geilevideossos-gamedev/fable-sbc-test/enclosure/renders/enclosure_front.png

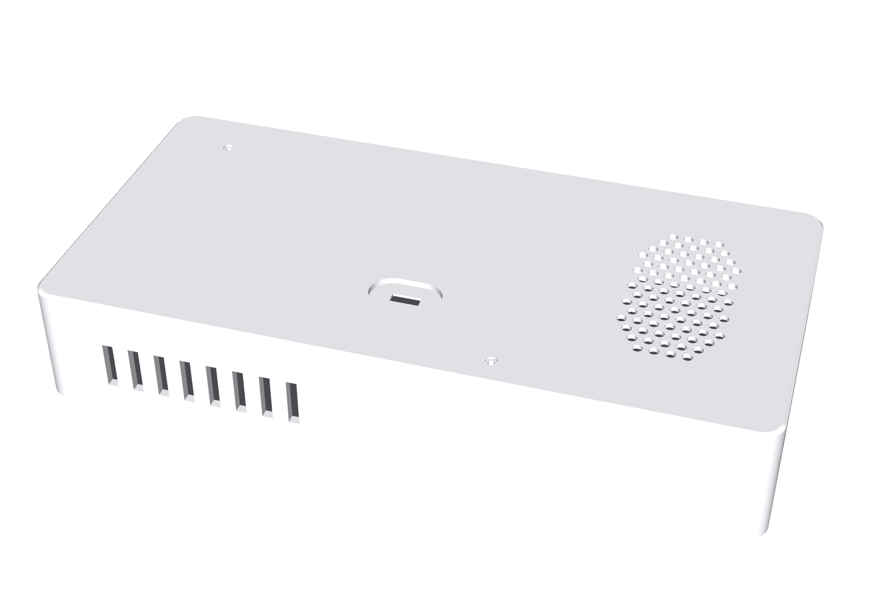
enclosure/renders/enclosure_front.png
