geilevideossos-gamedev/fable-sbc-test/enclosure/renders/fit_top_transparent.png

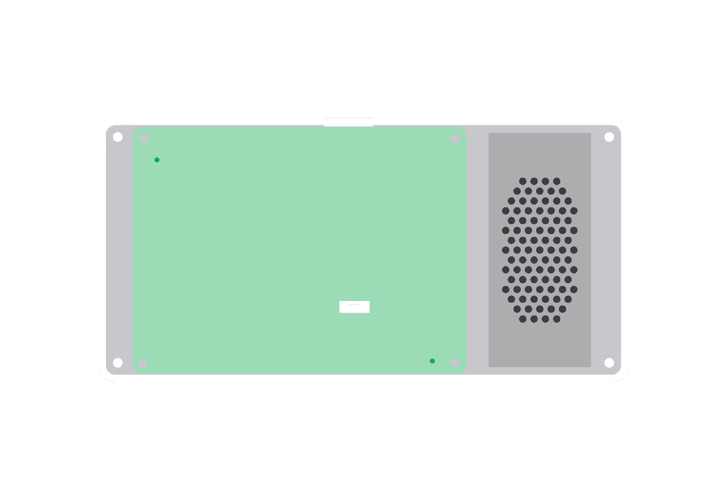
enclosure/renders/fit_top_transparent.png
