geilevideossos-gamedev/fable-sbc-test/enclosure/renders/section_cm4.png

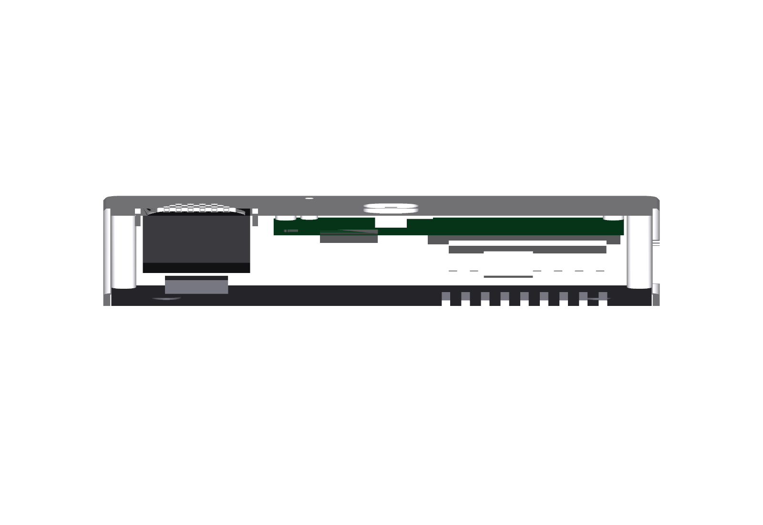
enclosure/renders/section_cm4.png
