geilevideossos-gamedev/fable-sbc-test/enclosure/renders/section_front_row.png

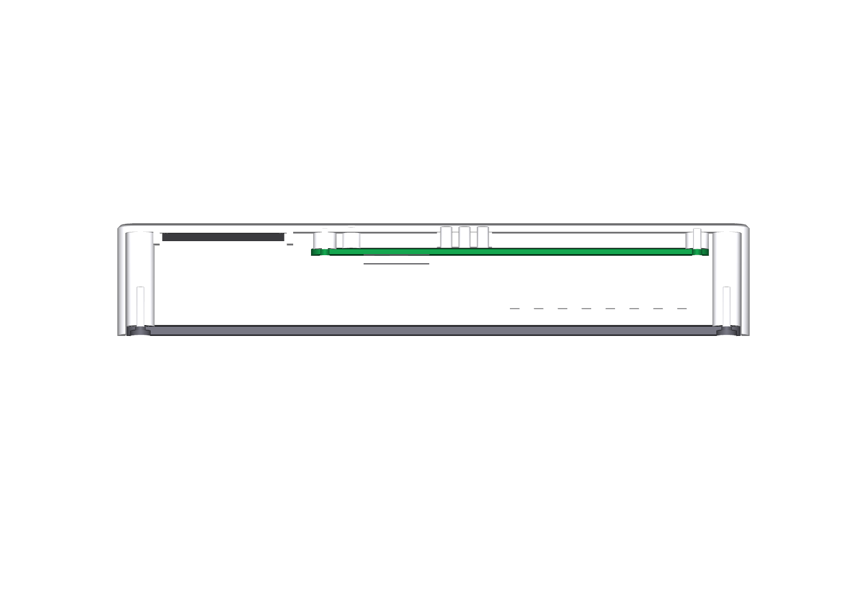
enclosure/renders/section_front_row.png
