geilevideossos-gamedev/fable-sbc-test/hardware/outputs/render_bottom.png

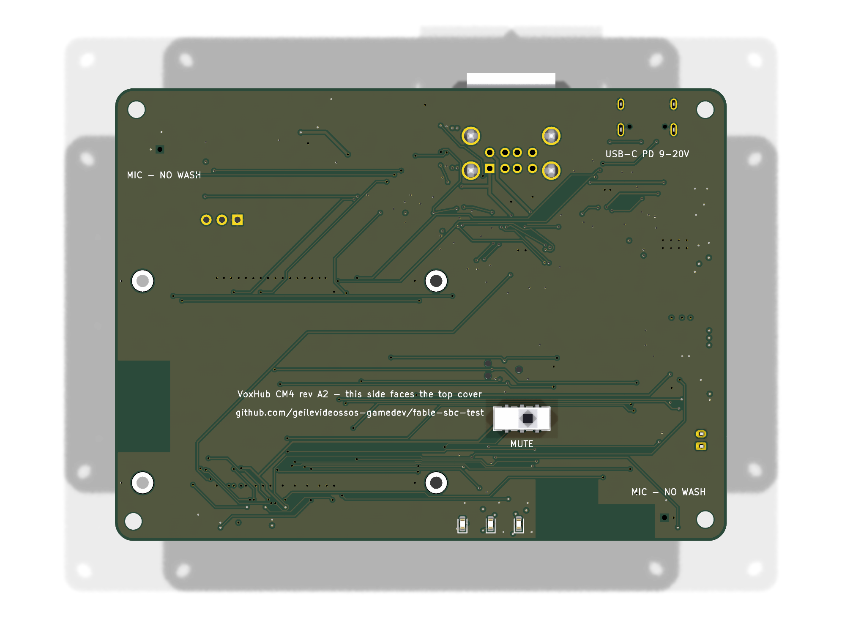
hardware/outputs/render_bottom.png
