geilevideossos-gamedev/fable-sbc-test/fab/jlcpcb/bom_jlcpcb.csv

Comment | Designator | Footprint | LCSC Part #
CL10A105KB8NNNC | C1 | C_0603_1608Metric | C15849
CC0603KRX7R9BB104 | C2 | C_0603_1608Metric | C14663
CL10B105KA8NNNC | C3,C5,C11 | C_0603_1608Metric | C29936
CL05B104KO5NNNC | C4,C6,C12,C18,C19,C21,C24,C25,C28,C29,C30,C31,C32,C33,C34,C35,C39,C42,C43,C44,C45,C48,C50 | C_0402_1005Metric | C1525
CL05B103KB5NNNC | C7 | C_0402_1005Metric | C15195
CL31B106KBHNNNE | C8,C9 | C_1206_3216Metric | C89632
GRM188R71H224KAC4D | C10 | C_0603_1608Metric | C669503
CL31A226KAHNNNE | C14,C15,C16,C17,C22,C23,C46,C47 | C_1206_3216Metric | C12891
CL10A475KA8NQNC | C20,C36,C37,C40,C49 | C_0603_1608Metric | C69335
0402CG150J500NT | C26,C27 | C_0402_1005Metric | C1548
T520B107M006ATE040 | C38,C41 | CP_EIA-3528-21_Kemet-B | C116740
SMBJ22A | D1 | D_SMB | C224015
SD24C-01FTG | D2,D3 | D_SOD-323 | C207246
LTST-C191KRKT | D4,D9 | LED_0603_1608Metric | C125099
MM3Z10VT1G | D5 | D_SOD-323 | C39057
150060VS75000 | D6,D10 | LED_0603_1608Metric | C6848499
KT-0603G | D7 | LED_0603_1608Metric | C12624
KT-0603B | D8 | LED_0603_1608Metric | C2288
9774015151R | H5,H6,H7,H8 | Mounting_Wuerth_WA-SMSI-M2.5_H1.5mm_9774015151 | C5353804
USB4105-GF-A | J1 | USB_C_Receptacle_GCT_USB4105-xx-A_16P_TopMnt_Horizontal | C3020560
DF40C-100DS-0.4V(51) | J2,J3 | CM4_J1_DF40C-100DS | C597931
DM3AT-SF-PEJM5 | J4 | microSD_HC_Hirose_DM3AT-SF-PEJM5 | C114218
61400826021 | J6 | USB_A_Wuerth_61400826021_Horizontal_Stacked | C5366339
B2B-PH-K-S(LF)(SN) | J7 | JST_PH_B2B-PH-K_1x02_P2.00mm_Vertical | C131337
SLO0630H6R8MTT | L1 | L_Bourns_SRP7028A_7.3x6.6mm | C207841
IM69D130V01 | MK1,MK2 | Infineon_PG-LLGA-5-1 | C536262
AO3401A | Q1 | SOT-23 | C15127
2N7002,215 | Q2,Q3,Q4 | SOT-23 | C65189
0402WGF5101TCE | R1,R4,R18 | R_0402_1005Metric | C25905
0402WGF1001TCE | R2,R7,R26 | R_0402_1005Metric | C11702
0402WGF0000TCE | R3,R6 | R_0402_1005Metric | C17168
0402WGF2401TCE | R5 | R_0402_1005Metric | C25882
0402WGF4992TCE | R8,R16 | R_0402_1005Metric | C25897
0402WGF1003TCE | R9,R12,R13,R24,R25,R28,R29,R30,R31,R32,R42,R43,R44,R46,R47 | R_0402_1005Metric | C25741
0402WGF1503TCE | R10 | R_0402_1005Metric | C25755
0402WGF4703TCE | R11 | R_0402_1005Metric | C25790
0402WGF2492TCE | R14 | R_0402_1005Metric | C25874
0402WGF2201TCE | R15,R20,R45 | R_0402_1005Metric | C25879
0402WGF1002TCE | R17,R19,R21,R23,R33,R34,R35,R36,R38,R40 | R_0402_1005Metric | C25744
0402WGF1500TCE | R22 | R_0402_1005Metric | C25082
0402WGF1202TCE | R27 | R_0402_1005Metric | C25752
0402WGF2002TCE | R37,R39 | R_0402_1005Metric | C25765
0402WGF330JTCE | R41 | R_0402_1005Metric | C25105
JS202011JCQN | SW1 | SW_DPDT_CK_JS202011JCQN | C221665
CYPD3177-24LQXQT | U1 | QFN-24-1EP_4x4mm_P0.5mm_EP2.75x2.75mm | C2952489
LMR33640ADDAR | U2 | Texas_HSOP-8-1EP_3.9x4.9mm_P1.27mm_ThermalVias | C2836966
TPS2553DBVR | U3,U5,U6 | SOT-23-6 | C55266
USB2514B-I/M2 | U4 | QFN-36-1EP_6x6mm_P0.5mm_EP3.7x3.7mm | C220679
USBLC6-2SC6 | U7,U8 | SOT-23-6 | C7519
ADAU7002ACBZ-R7 | U9 | ADAU7002_WLCSP-8_0.76x1.56mm_P0.4mm | C481886
MAX98357AETE+T | U10 | TQFN-16-1EP_3x3mm_P0.5mm_EP1.23x1.23mm | C910544
RF-BM-2652P2 | U11 | RFstar_RF-BM-2652P2 | C5440064
X322524MOB4SI | Y1 | Crystal_SMD_3225-4Pin_3.2x2.5mm | C70590
