geilevideossos-gamedev/fable-sbc-test/hardware/outputs/bom_system.csv

Item | Qty used | Function | Description | Manufacturer | Part number | Shop | Shop article no. | Buy qty | Pack | EUR incl. VAT | Ext. EUR | Second source | Note | Link (prices and stock checked 2026-11-12)
1 | 1 | Compute module | Raspberry Pi Compute Module 4 Lite, 4 GB RAM, wireless, no eMMC | Raspberry Pi | CM4104000 | Reichelt.at | RPI CM4W 4GBLITE | 1 | 1 | 105.83 | 105.83 | Semaf Wien 102.00 (free shipping), Welectron 103.00, DigiKey SC0671; CM4102000 (2 GB) is the cheaper drop-in | the board has no Ethernet: only wireless variants work (not RPI CM4 4GBLITE = CM4004000) | https://www.reichelt.at/at/de/shop/produkt/raspberry_pi_compute_modul_4_4gb_ram_lite_wlan-290539
2 | 1 | Speaker | Enclosed speaker 3 W 4 ohm, 70 x 30 x 16.5 mm, JST-PH 2-pin plug on a lead of about 50 cm | Adafruit | 3351 | BerryBase.at | ADA3351 | 1 | 1 | 5.50 | 5.50 | none without re-drawing the speaker pocket of the enclosure | plugs into J7, no soldering | https://www.berrybase.at/mono-gehaeuselautsprecher-3w-4-ohm
3 | 1 | Heat sink | Heat sink set for Raspberry Pi: 14 x 14 x 7 mm (used) + 8.8 x 8.8 x 5 mm, adhesive foil applied | BerryBase | RPI-2KKS | BerryBase.at | RPI-2KKS | 1 | set of 2 | 1.30 | 1.30 | BerryBase RPI-4KKS; any 14 x 14 mm heat sink up to 9.5 mm high with adhesive foil | on the BCM2711 of the CM4 | https://www.berrybase.at/2-teiliges-kuehlkoerper-set-fuer-raspberry-pi-schwarz
4 | 1 | microSD card | microSDXC 64 GB, endurance type (Home Assistant OS writes around the clock) | SanDisk | SDSQQNR-064G-GN6IA | BerryBase.at | 619659173081 | 1 | 1 | 28.90 | 28.90 | any A1 / A2 class microSD of 32 GB or more | flash os/output/haos_voxhub-cm4-*.img.xz | https://www.berrybase.at/sandisk-high-endurance-microsdxc-uhs-i-u3-speicherkarte-adapter-64gb
5 | 8 | Screws CM4 + PCB | Screw M2.5 x 5 mm pan head PH1, DIN 7985 (4 x CM4 to the SMT spacers, 4 x PCB to the shell bosses) | generic | DIN 7985 M2.5x5 | BerryBase.at | D7985 | 10 | single | 0.06 | 0.60 | ISO 7045 / ISO 14583 M2.5 x 5; Screwerk STP390250060S (2.5 x 6 thread-forming, business customers only) for the bosses | never longer than 6 mm | https://www.berrybase.at/schraube-kopf-zylinder-m2-5x5
6 | 4 | Screws base | Screw M2.5 x 8 mm pan head PH1, DIN 7985 (base to the shell posts) | generic | DIN 7985 M2.5x8 | BerryBase.at | D7988 | 10 | single | 0.05 | 0.50 | M2.5 x 10 also fits; Screwerk STP390250080S (thread-forming, business customers only) | head 5.0 mm in a 5.2 mm counterbore | https://www.berrybase.at/schraube-kopf-zylinder-m2-5x8
7 | 4 | Feet | Rubber feet 8 x 3 mm, round, self-adhesive | Delock | 18308 | Reichelt.at | DELOCK 18308 | 1 | 70 | 4.89 | 4.89 | any 8 mm stick-on foot at least 2 mm high | base recesses are 8.6 mm | https://www.reichelt.at/at/de/shop/produkt/gummifuesse_rund_selbstklebend_8_x_3_mm_70_stk_schwarz-371080
8 | 1 | Speaker pad | Self-adhesive cellular rubber sheet 3 x 300 x 200 mm (cut 40 x 18 mm for the speaker pedestal) | Jamara | 059850 | Reichelt.at | JAMARA 059850 | 1 | 1 sheet | 5.60 | 5.60 | any soft closed-cell foam about 3 mm thick | compressed to about 2 mm when the base is closed | https://www.reichelt.at/at/de/shop/produkt/moosgummiplatte_3_x_300_x_200_mm_selbstklebend_1_stueck-327925
9 | 1 | Power supply | USB-C PD charger 30 W (5 V 3 A, 9 V 3 A, 12 V 2.5 A, 15 V 2 A, 20 V 1.5 A) | Goobay | 79153 | Reichelt.at | GOOBAY 79153 | 1 | 1 | 16.54 | 16.54 | Goobay 79155 (65 W); any USB-C PD charger with a fixed 12 / 15 / 20 V profile of 2 A or more | the board negotiates 15 V / 2 A | https://www.reichelt.at/at/de/shop/produkt/usb-ladegeraet_30_w_gan_1x_usb-c_weiss-425716
10 | 1 | USB-C cable | USB-C to USB-C cable, 60 W, 1 m | Shiverpeaks | BS20-75025 | Reichelt.at | SHVP BS20-75025 | 1 | 1 | 5.84 | 5.84 | any USB-C to USB-C cable rated 3 A |  | https://www.reichelt.at/at/de/shop/produkt/sync-_ladekabel_usb-c_60w_1_0_m-378629
 |  |  | System parts for one device |  |  |  |  |  |  |  | 175.50
 |  |  | Shipping to Austria (Reichelt.at 6.95, BerryBase.at 5.95) |  |  |  |  |  |  |  | 12.90
 |  |  | Total |  |  |  |  |  |  |  | 188.40
