geilevideossos-gamedev/fable-sbc-test/enclosure/voxhub_assembly.step

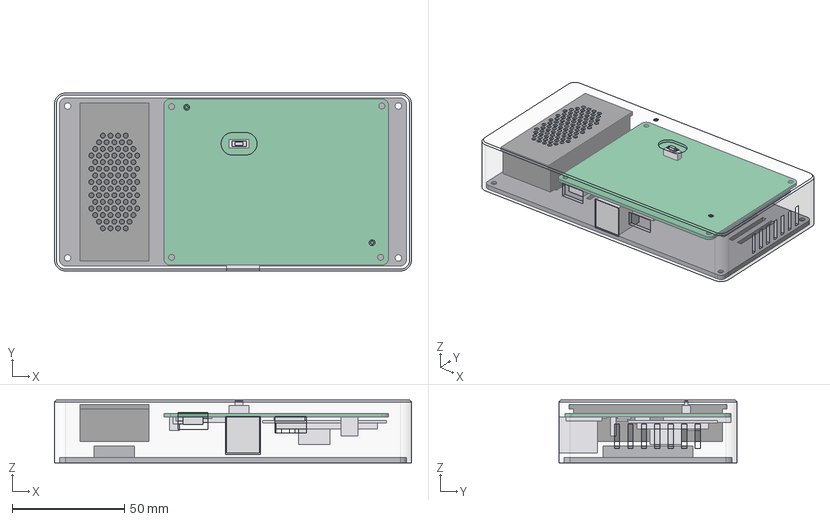
[picture p11: CAD file, 2026-11-12]
enclosure/voxhub_assembly.step
158.8 x 79.2 x 28.0 mm
base
pcb
components
speaker
