geilevideossos-gamedev/fable-sbc-test/hardware/3dmodels/ADAU7002.step

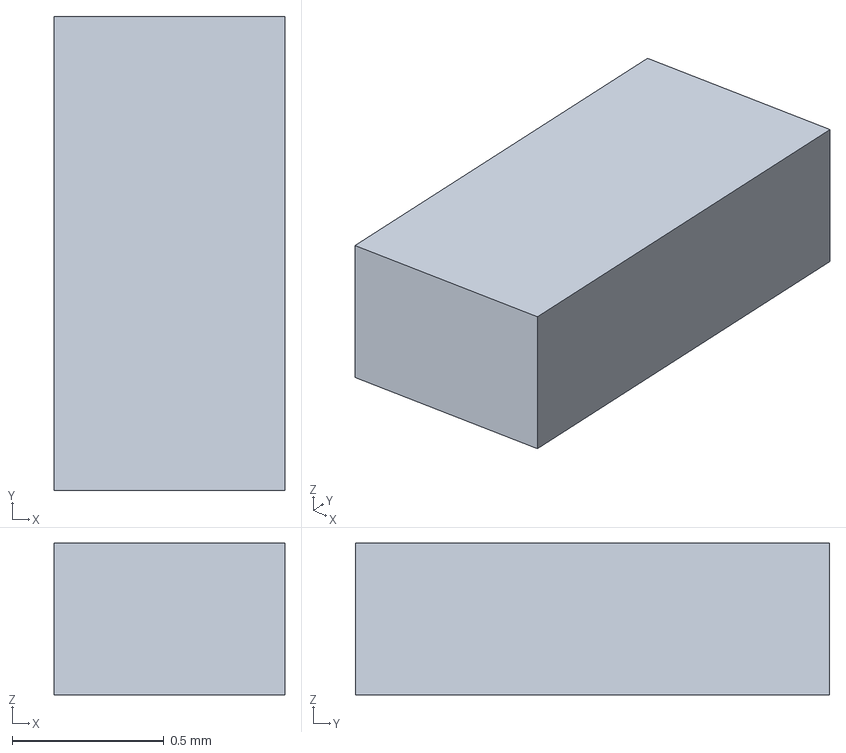
[picture p12: CAD file, 2026-11-12]
hardware/3dmodels/ADAU7002.step
0.76 x 1.56 x 0.5 mm
