geilevideossos-gamedev/fable-sbc-test/hardware/outputs/voxhub_outline.dxf

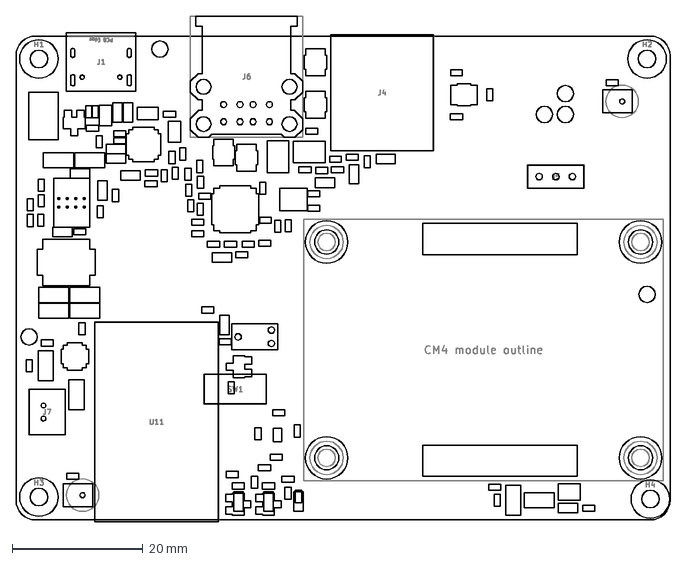
[picture p13: CAD file, 2026-11-12]
hardware/outputs/voxhub_outline.dxf
100.0 x 77.3 mm
