geilevideossos-gamedev/fable-sbc-test/enclosure/voxhub_base.step

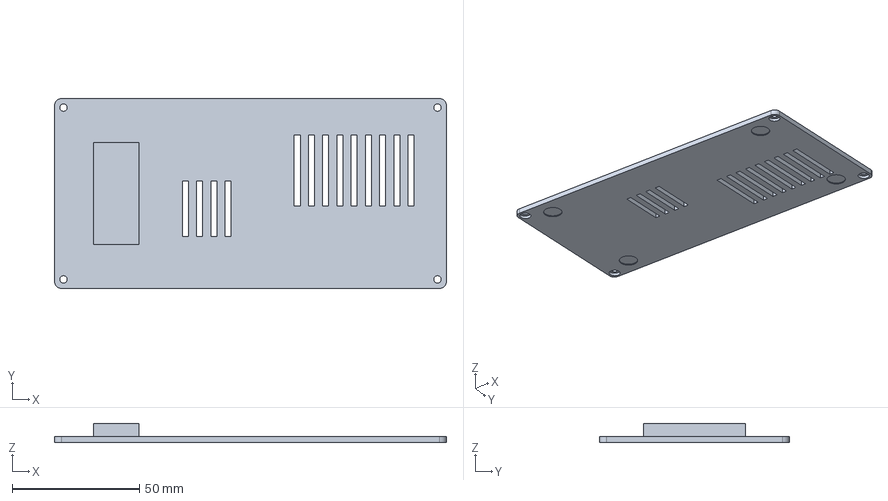
[picture p14: CAD file, 2026-11-12]
enclosure/voxhub_base.step
154.3 x 74.7 x 7.50 mm
