geilevideossos-gamedev/fable-sbc-test/hardware/3dmodels/RaspberryPi_CM4_with_heatsink.step

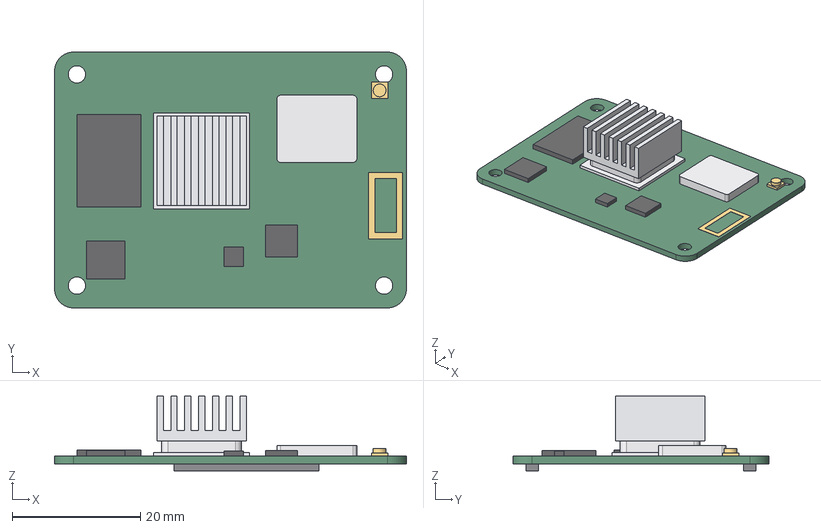
[picture p15: CAD file, 2026-11-12]
hardware/3dmodels/RaspberryPi_CM4_with_heatsink.step
55.0 x 40.0 x 11.7 mm
pcb
plugs
soc
heatsink
chips
shield
ufl
antenna
