geilevideossos-gamedev/fable-sbc-test/hardware/outputs/voxhub_pcb.step

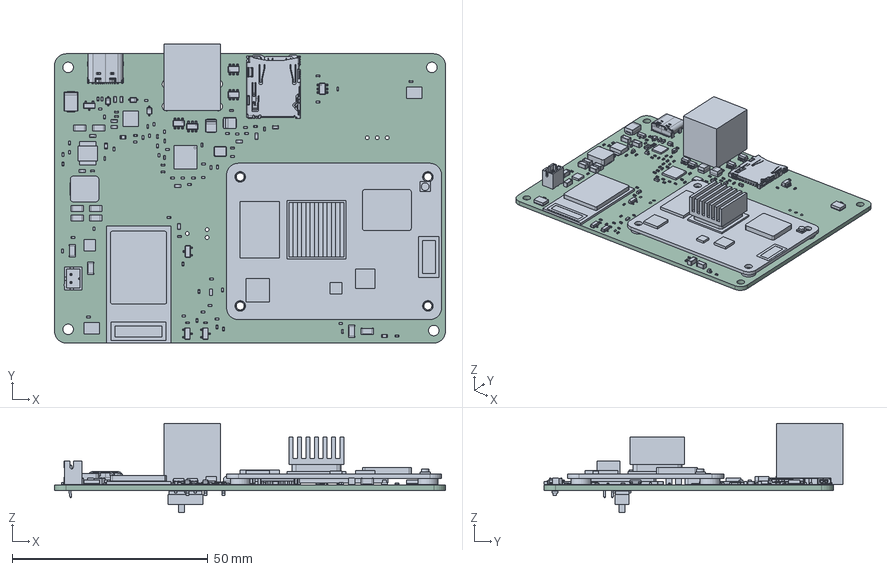
[picture p16: CAD file, 2026-11-12]
hardware/outputs/voxhub_pcb.step
100.0 x 76.5 x 22.8 mm
C_0402_1005Metric x 26
R_0402_1005Metric x 47
QFN-36-1EP_6x6mm_P0.5mm_EP3.7x3.7mm
C_0603_1608Metric x 11
lid x 2
base x 3
pcb x 2
shield x 2
antenna x 2
D_SOD-323 x 3
C_1206_3216Metric x 10
LED_0603_1608Metric x 6
JST_PH_B2B-PH-K_1x02_P2.00mm_Vertical
pads
SOT-23 x 4
D_SMB
tongues
contacts
SOT-23-6 x 5
Crystal_SMD_3225-4Pin_3.2x2.5mm
microSD_HC_Hirose_DM3AT-SF-PEJM5
CP_EIA-3528-21_Kemet-B x 2
plugs
soc
heatsink
chips
ufl
Mounting_Wuerth_WA-SMSI-M2.5_H1.5mm_9774015151 x 4
leads
USB_C_Receptacle_GCT_USB4105-xx-A_16P_TopMnt_Horizontal
frame
actuator
pins
voxhub_PCB
