geilevideossos-gamedev/fable-sbc-test/enclosure/voxhub_shell.step

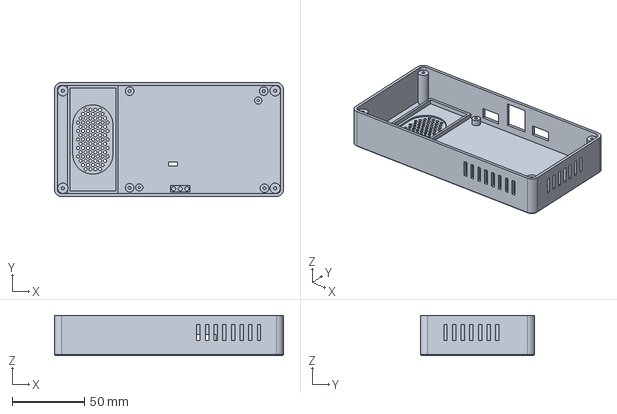
[picture p17: CAD file, 2026-11-12]
enclosure/voxhub_shell.step
158.8 x 79.2 x 28.0 mm
