geilevideossos-gamedev/fable-sbc-test/hardware/3dmodels/RF-BM-2652P2.step

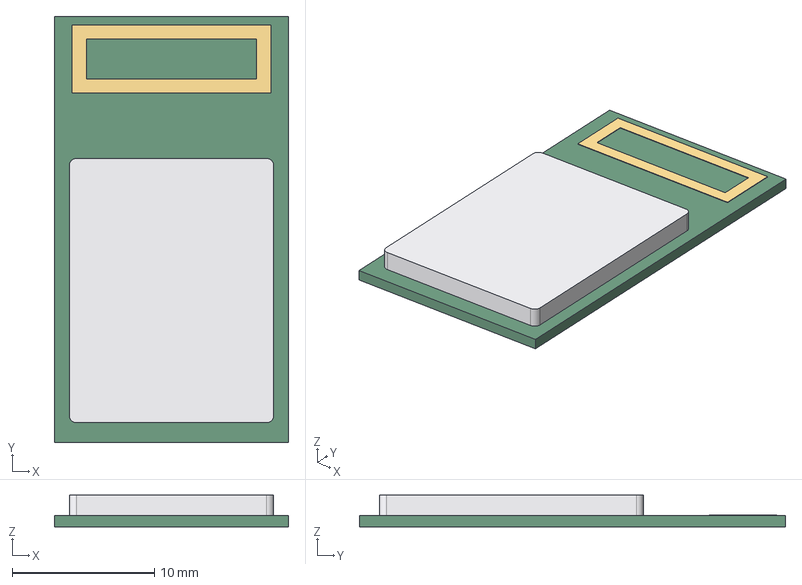
[picture p18: CAD file, 2026-11-12]
hardware/3dmodels/RF-BM-2652P2.step
16.5 x 30.0 x 2.25 mm
pcb
shield
antenna
