geilevideossos-gamedev/fable-sbc-test/hardware/3dmodels/MGM240P.step

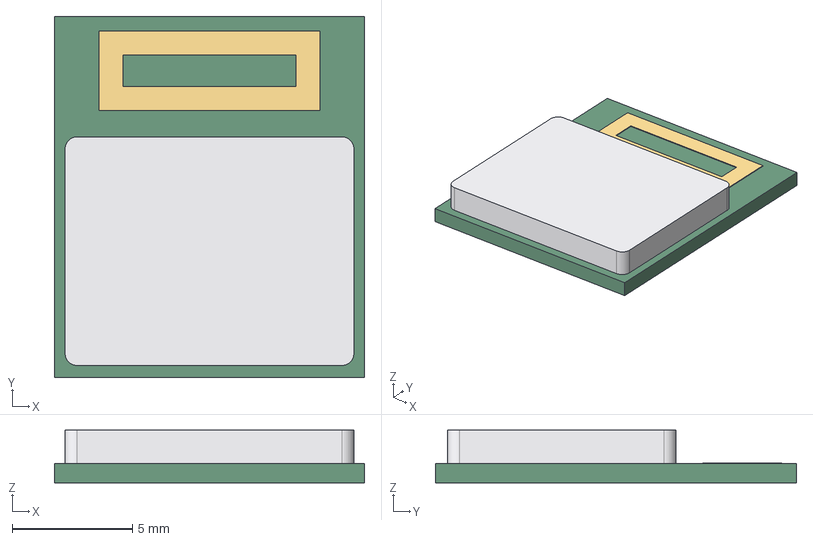
[picture p19: CAD file, 2026-11-12]
hardware/3dmodels/MGM240P.step
12.9 x 15.0 x 2.20 mm
pcb
shield
antenna
