geilevideossos-gamedev/fable-sbc-test/(list of files, cad)

Other CAD files:
enclosure/voxhub_base.3mf
enclosure/voxhub_base.stl
enclosure/voxhub_shell.3mf
enclosure/voxhub_shell.stl
