geilevideossos-gamedev/fable-sbc-test/assistant/voxhub_satellite/CHANGELOG.md

# Changelog

## 0.1.0

- First release: Linux Voice Assistant 1.1.18 as an Assist voice satellite on the VoxHub hub, status LEDs and
  hardware mute switch through the peripheral API, microphone gain for the googlevoicehat card, and the exposure
  guard that keeps locks and alarm panels away from Assist.
