geilevideossos-gamedev/fable-sbc-test/hardware/outputs/voxhub_schematic.pdf

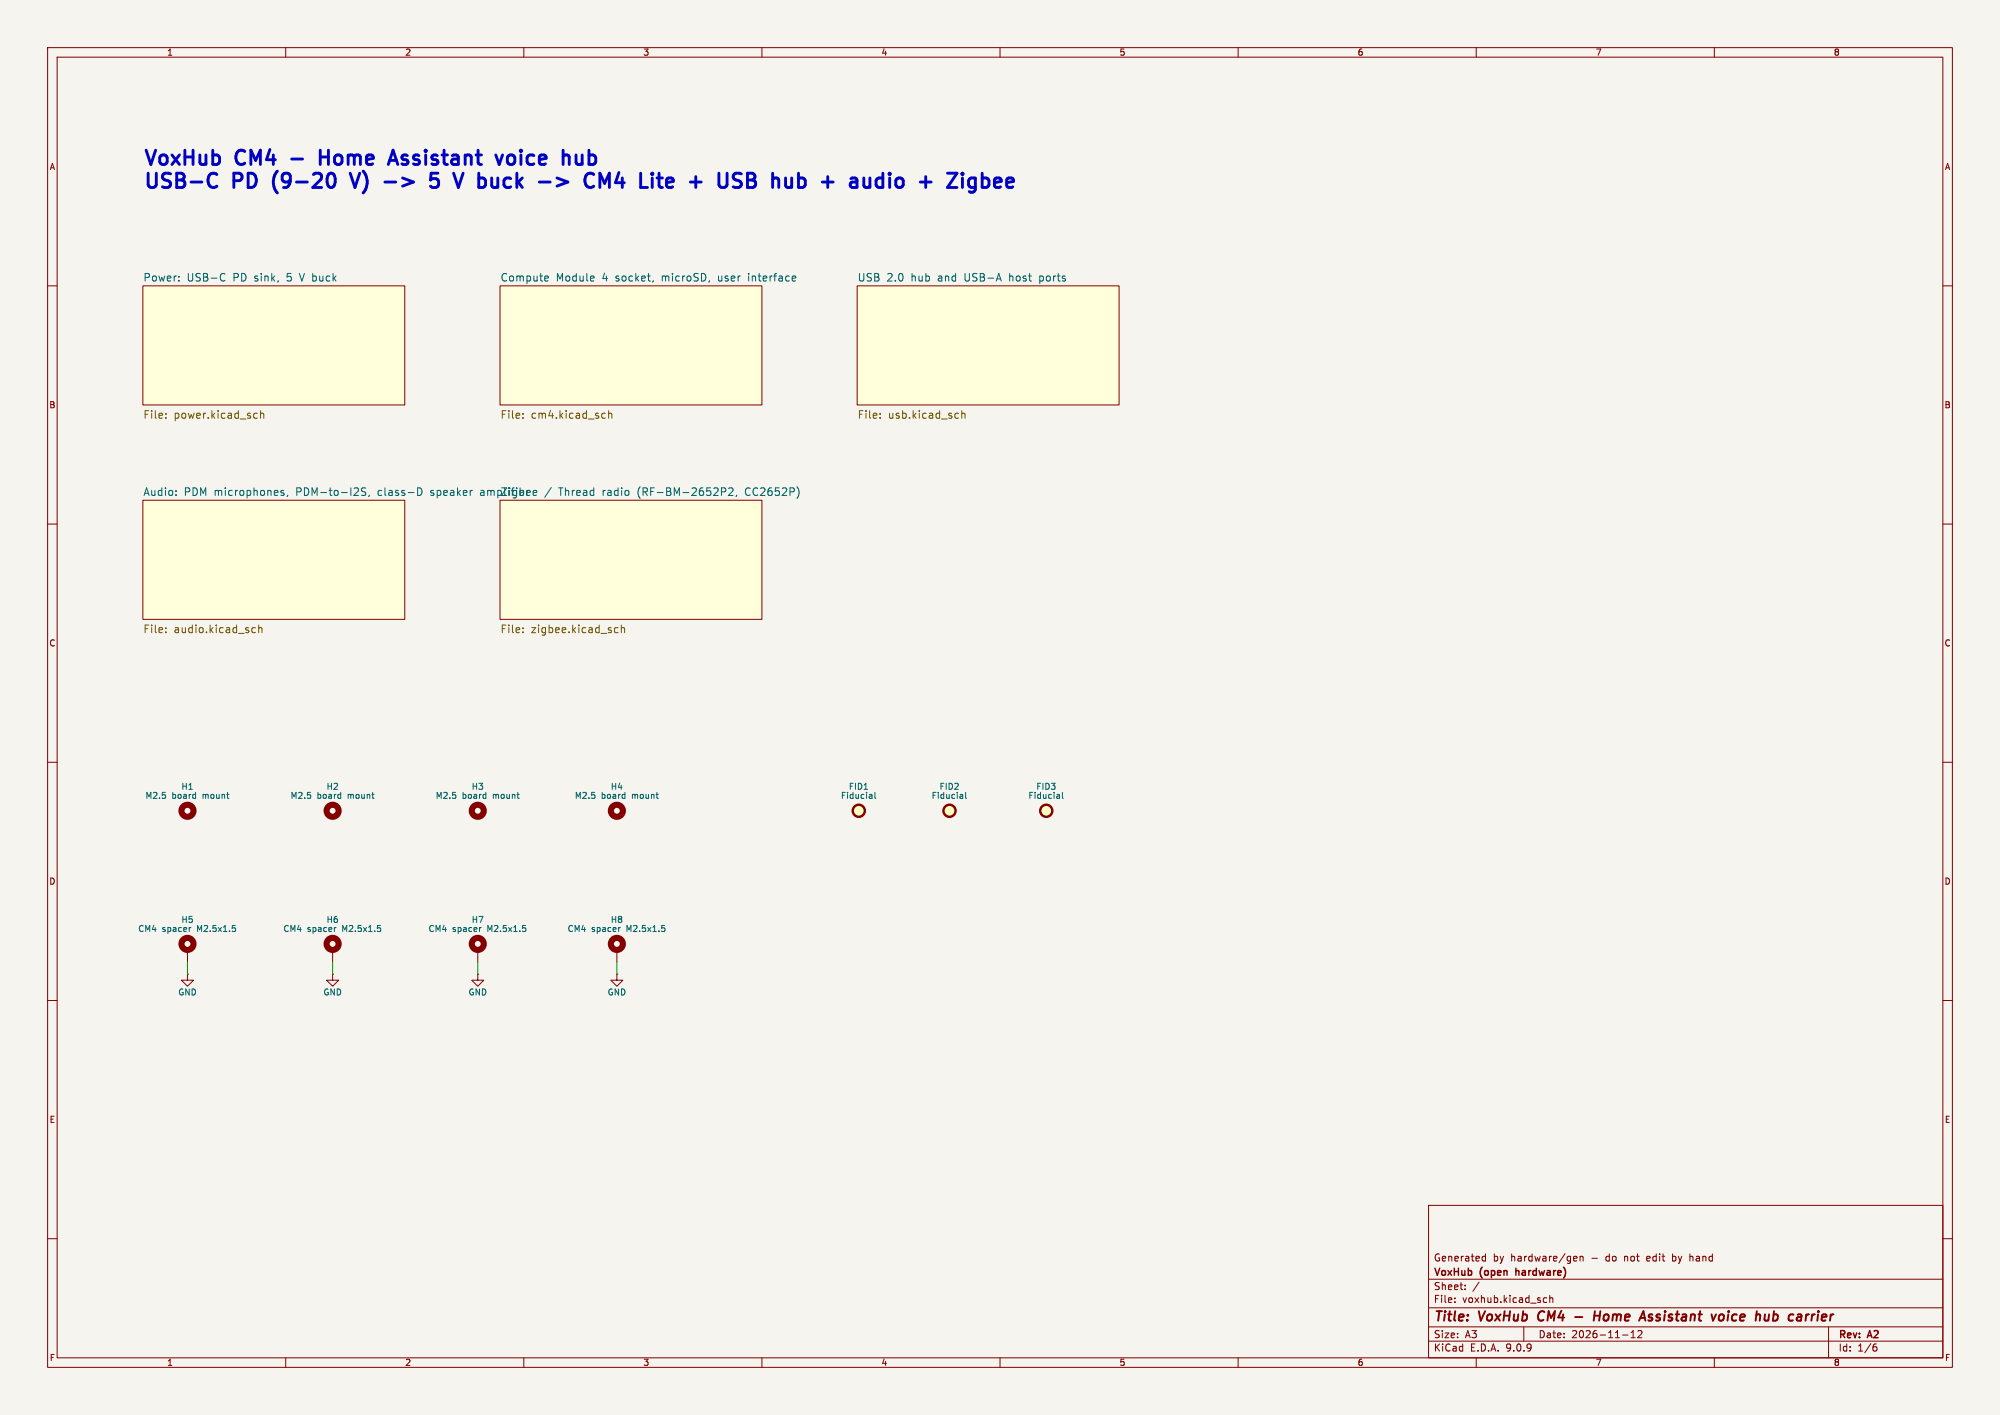
[picture p20: page 1]

FID2 Fiducial FID1 Fiducial H4 M2.5 board mount H3 M2.5 board mount H2 M2.5 board mount H1 M2.5 board mount VoxHub CM4 - Home Assistant voice hub

Compute Module 4 socket, microSD, user interface

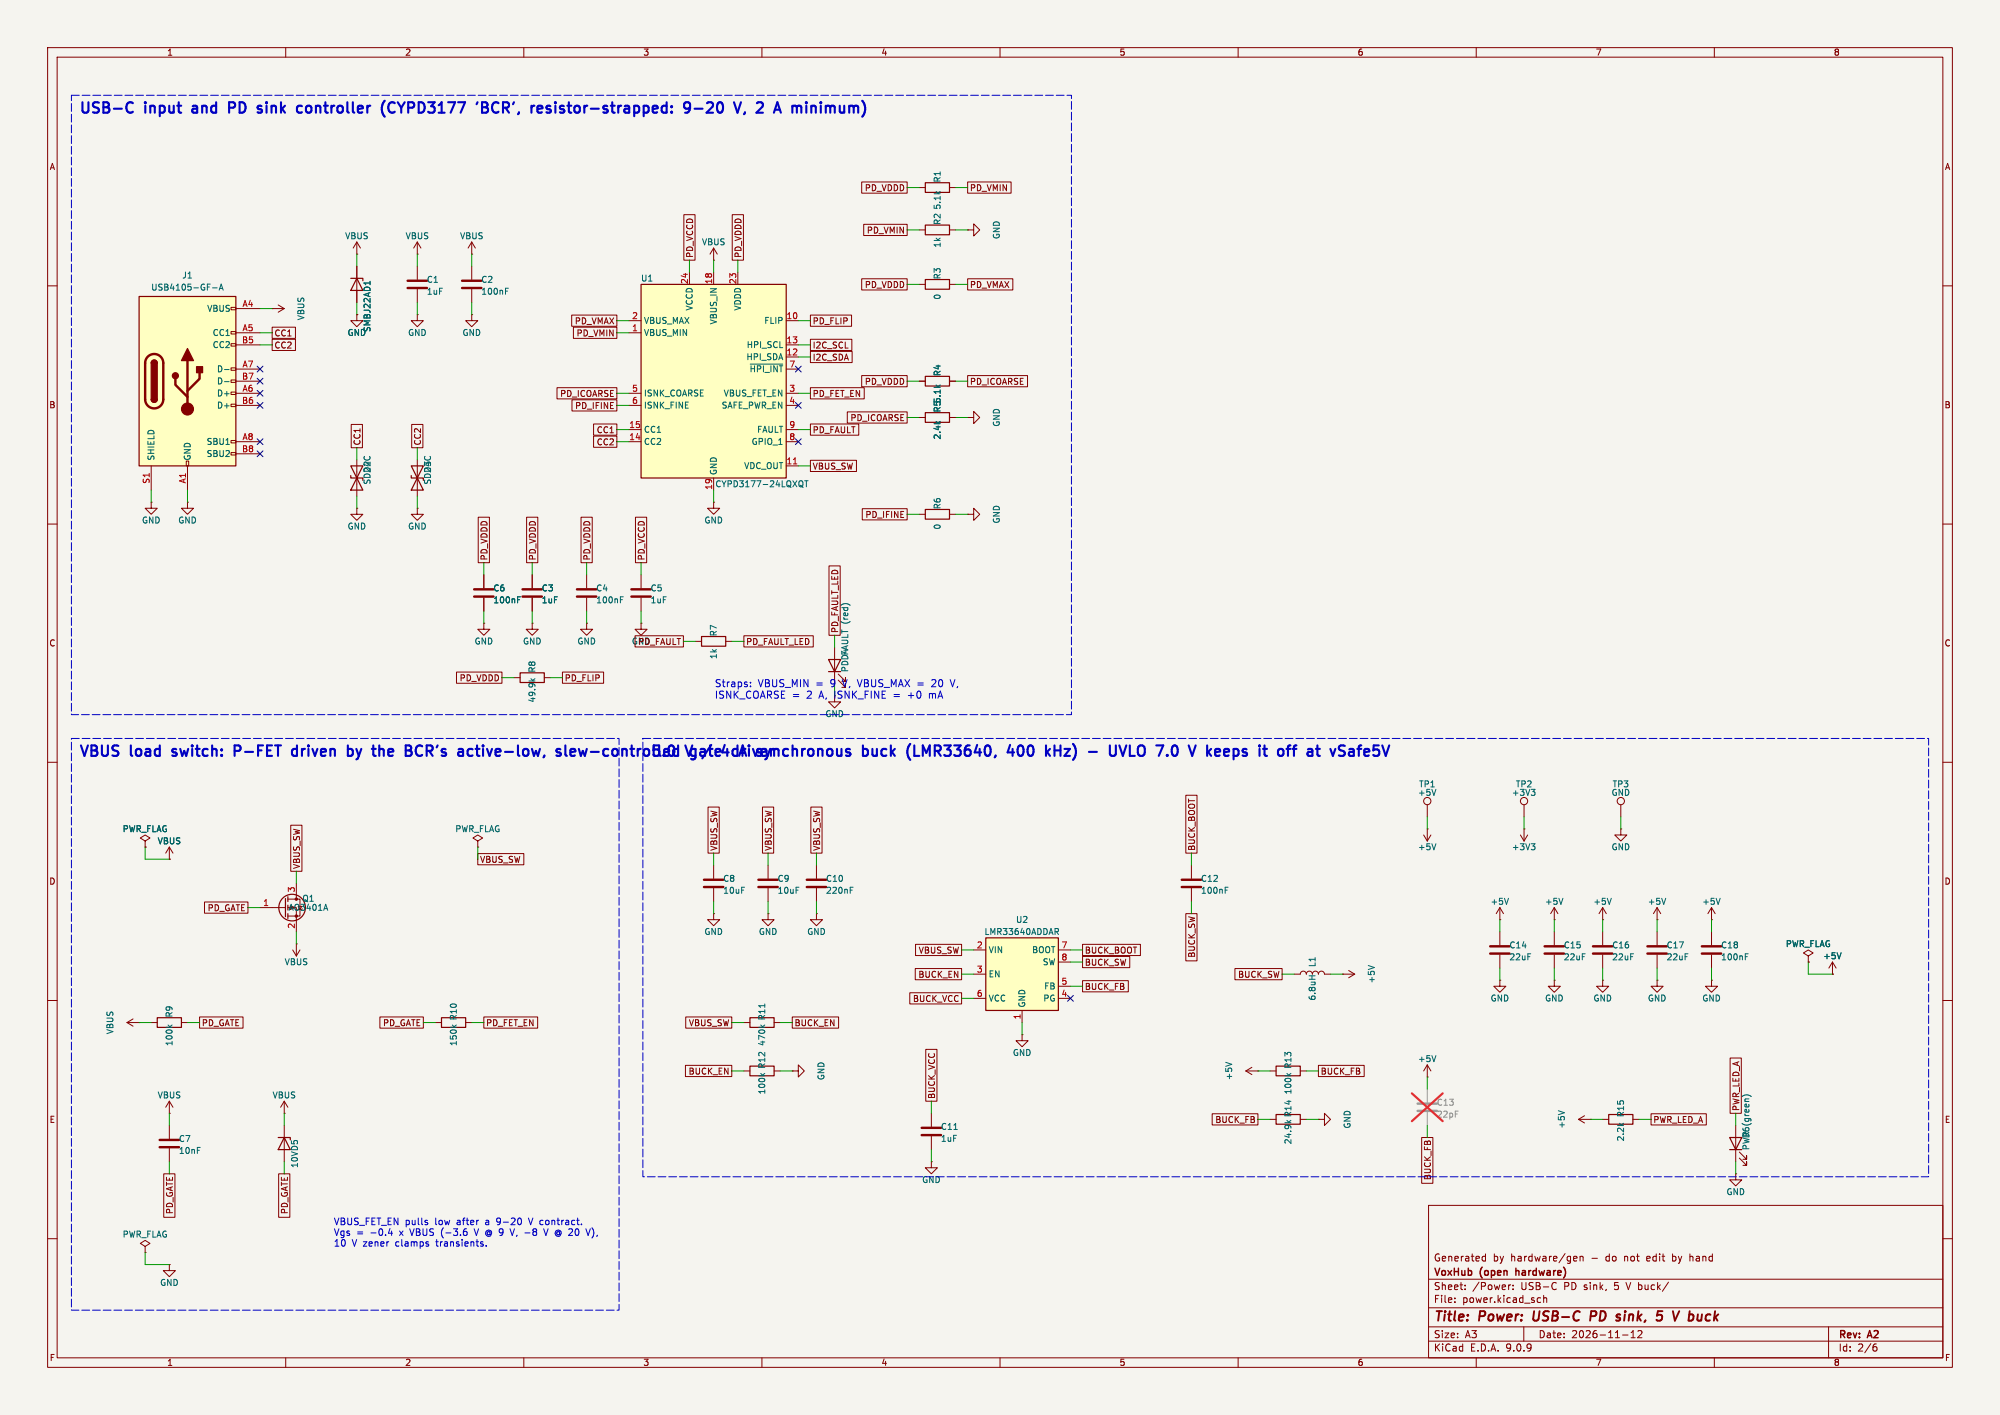
[picture p21: page 2]

1 BOOT 7 SW 8 FB 5 PG 4 U2

Id: 2/6 Title: Power: USB-C PD sink, 5 V buck

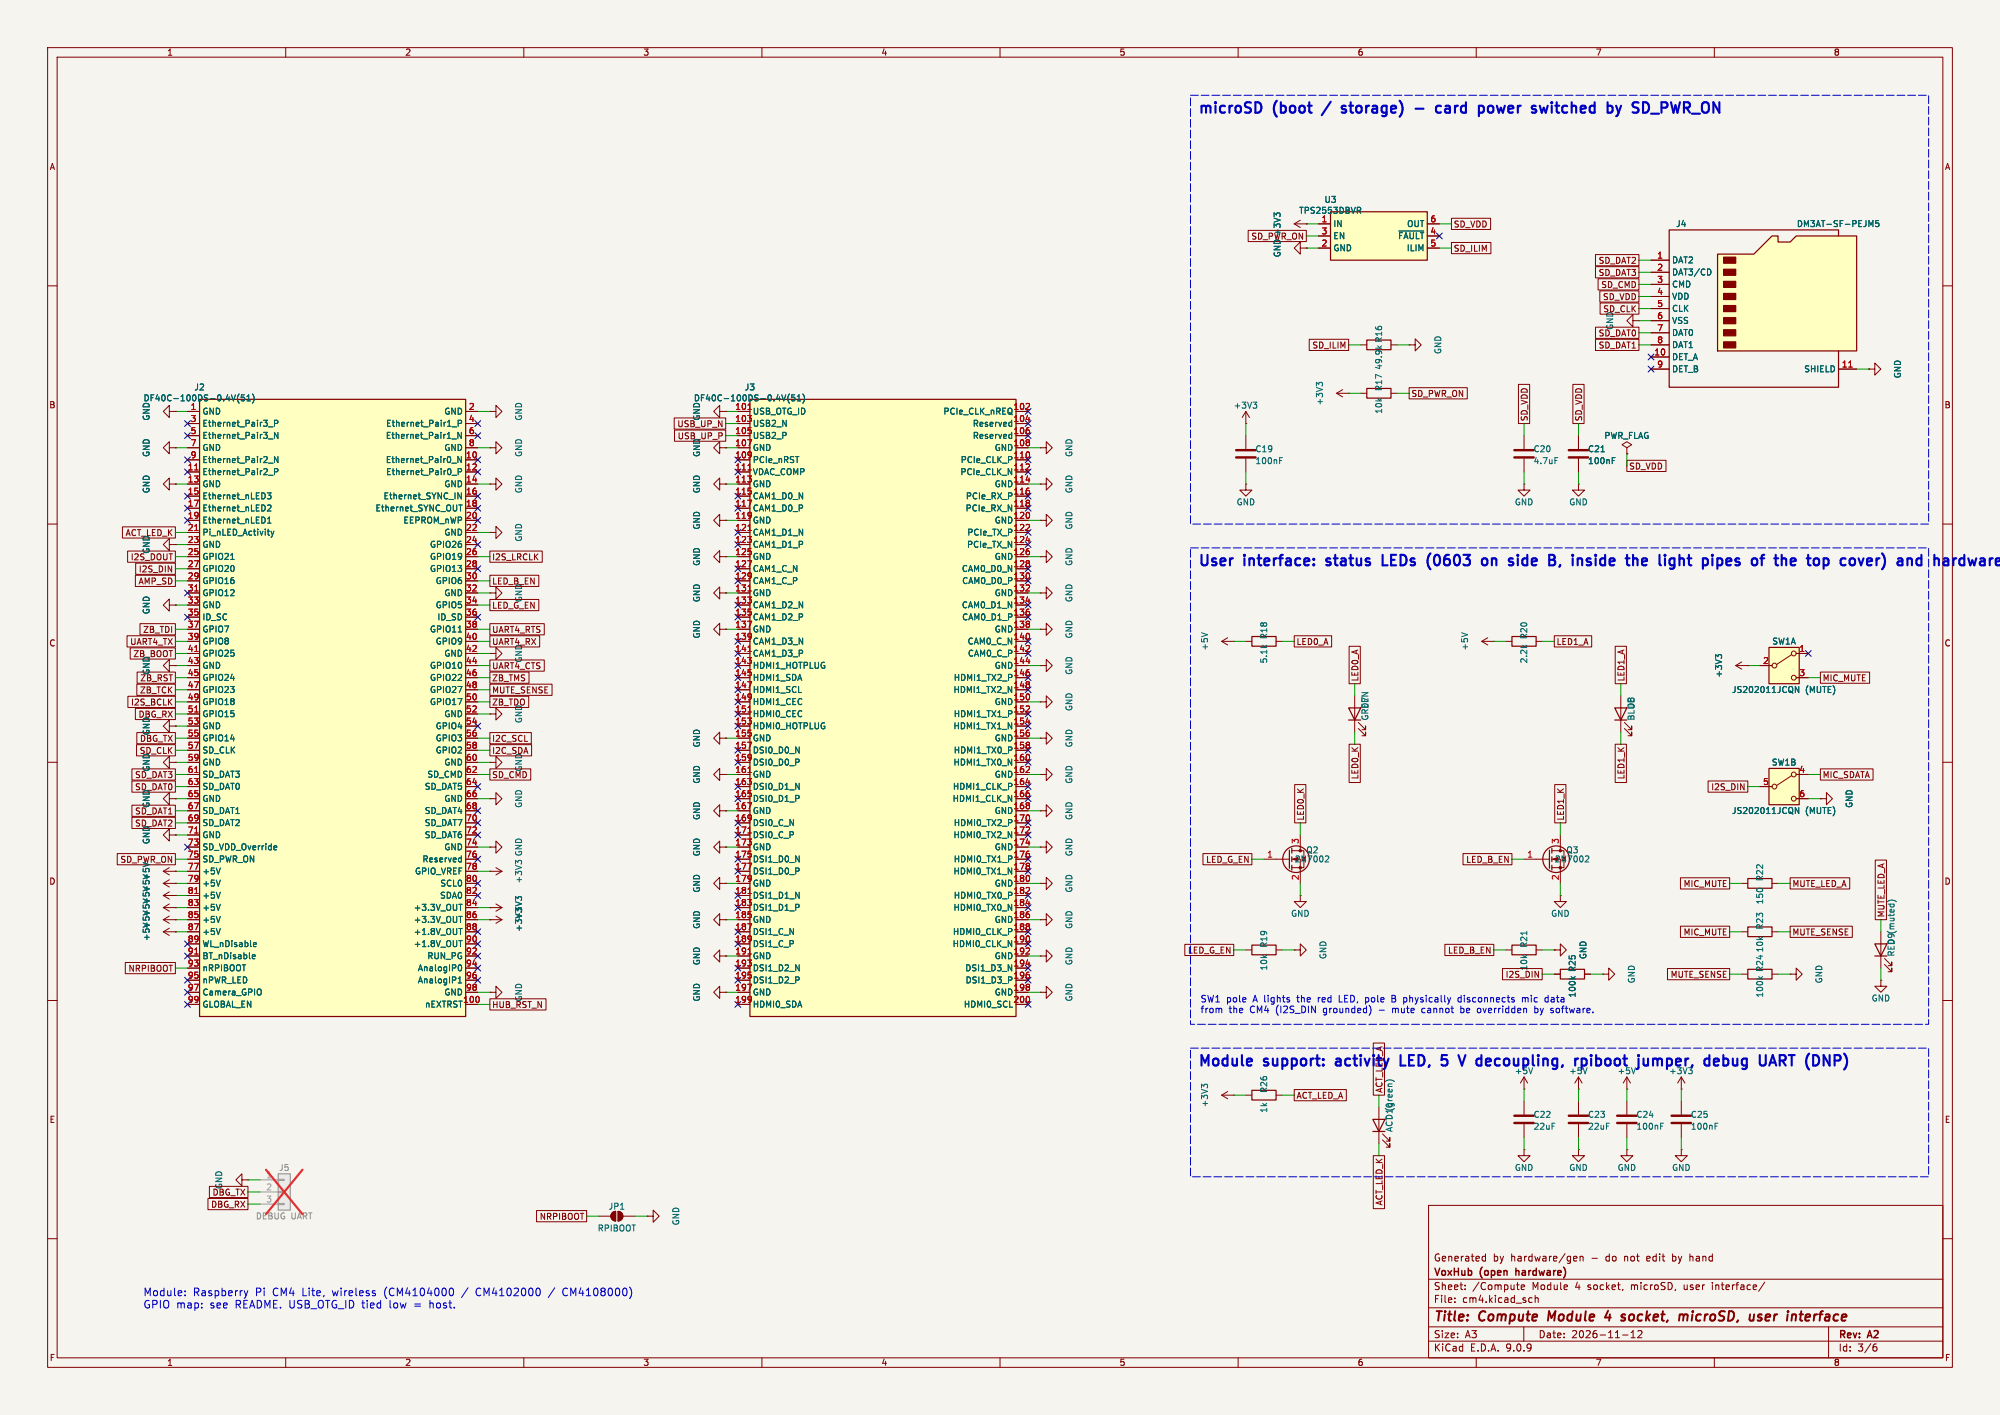
[picture p22: page 3]

microSD (boot / storage) - card power switched by SD_PWR_ON
ILIM 5 U3 TPS2553DBVR +3V3 GND GND
PCIe_CLK_nREQ 102 Reserved 104 Reserved 106 GND108 PCIe_CLK_P 110 PCIe_CLK_N 112 GND114 PCIe_RX_P 116 PCIe_RX_N 118 GND120 PCIe_TX_P 122 PCIe_TX_N 124 GND126 CAM0_D0_N 128 CAM0_D0_P 130 GND132 CAM0_D1_N 134 CAM0_D1_P 136 GND138 CAM0_C_N140 CAM0_C_P142 GND144 HDMI1_TX2_P 146 HDMI1_TX2_N 148 GND150 HDMI1_TX1_P 152 HDMI1_TX1_N 154 GND156 HDMI1_TX0_P 158 HDMI1_TX0_N 160 GND162 HDMI1_CLK_P 164 HDMI1_CLK_N 166 GND168 HDMI0_TX2_P 170 HDMI0_TX2_N 172 GND174 HDMI0_TX1_P 176 HDMI0_TX1_N 178 GND180 HDMI0_TX0_P 182 HDMI0_TX0_N 184 GND186 HDMI0_CLK_P 188 HDMI0_CLK_N 190 GND192 DSI1_D3_N 194 DSI1_D3_P 196 GND198 HDMI0_SCL 200

GND 1 Ethernet_Pair3_P 3 Ethernet_Pair3_N 5 GND 7 Ethernet_Pair2_N 9 Ethernet_Pair2_P 11 GND 13 Ethernet_nLED3 15 Ethernet_nLED2 17 Ethernet_nLED1 19 Pi_nLED_Activity 21 GND 23 GPIO21 25 GPIO20 27 GPIO16 29 GPIO12 31 GND 33

J2 DF40C-100DS-0.4V(51) GND 1 Ethernet_Pair3_P 3 Ethernet_Pair3_N 5 GND 7 Ethernet_Pair2_N 9 Ethernet_Pair2_P 11 GND 13 Ethernet_nLED3 15 Ethernet_nLED2 17 Ethernet_nLED1 19 Pi_nLED_Activity 21 GND 23 GPIO21 25 GPIO20 27 GPIO16 29 GPIO12 31 GND 33

PCIe_CLK_nREQ 102 Reserved 104 Reserved 106 GND108 PCIe_CLK_P 110 PCIe_CLK_N 112 GND114 PCIe_RX_P 116 PCIe_RX_N 118 GND120 PCIe_TX_P 122 PCIe_TX_N 124 GND126 CAM0_D0_N 128 CAM0_D0_P 130 GND132 CAM0_D1_N 134 CAM0_D1_P 136 GND138 CAM0_C_N140 CAM0_C_P142 GND144 HDMI1_TX2_P 146 HDMI1_TX2_N 148 GND150 HDMI1_TX1_P 152 HDMI1_TX1_N 154 GND156 HDMI1_TX0_P 158 HDMI1_TX0_N 160 GND162 HDMI1_CLK_P 164 HDMI1_CLK_N 166 GND168 HDMI0_TX2_P 170 HDMI0_TX2_N 172 GND174 HDMI0_TX1_P 176 HDMI0_TX1_N 178 GND180 HDMI0_TX0_P 182 HDMI0_TX0_N 184 GND186 HDMI0_CLK_P 188 HDMI0_CLK_N 190 GND192 DSI1_D3_N 194 DSI1_D3_P 196 GND198 HDMI0_SCL 200 GND GND GND

ID_SC 35 GPIO7 37 GPIO8 39 GPIO25 41 GND 43 GPIO24 45 GPIO23 47 GPIO18 49 GPIO15 51 GND 53 GPIO14 55 SD_CLK 57 GND 59 SD_DAT3 61 SD_DAT0 63 GND 65 SD_DAT1 67 SD_DAT2 69 GND 71 SD_VDD_Override 73 SD_PWR_ON 75 +5V 77 +5V 79 +5V 81 +5V 83 +5V 85 +5V 87 WL_nDisable 89 BT_nDisable 91

I2S_LRCLK
ID_SD 36 GPIO11 38 GPIO9 40 GND 42 GPIO10 44 GPIO22 46 GPIO27 48 GPIO17 50 GND 52 GPIO4 54 GPIO3 56 GPIO2 58 GND 60 SD_CMD 62 SD_DAT5 64 GND 66 SD_DAT4 68 SD_DAT7 70 SD_DAT6 72 GND 74 Reserved 76 GPIO_VREF 78 SCL0 80 SDA0 82 +3.3V_OUT 84 +3.3V_OUT 86 +1.8V_OUT 88 +1.8V_OUT 90 RUN_PG 92 AnalogIP0 94 AnalogIP1 96 GND 98

LED_B_EN

Id: 3/6 Title: Compute Module 4 socket, microSD, user interface

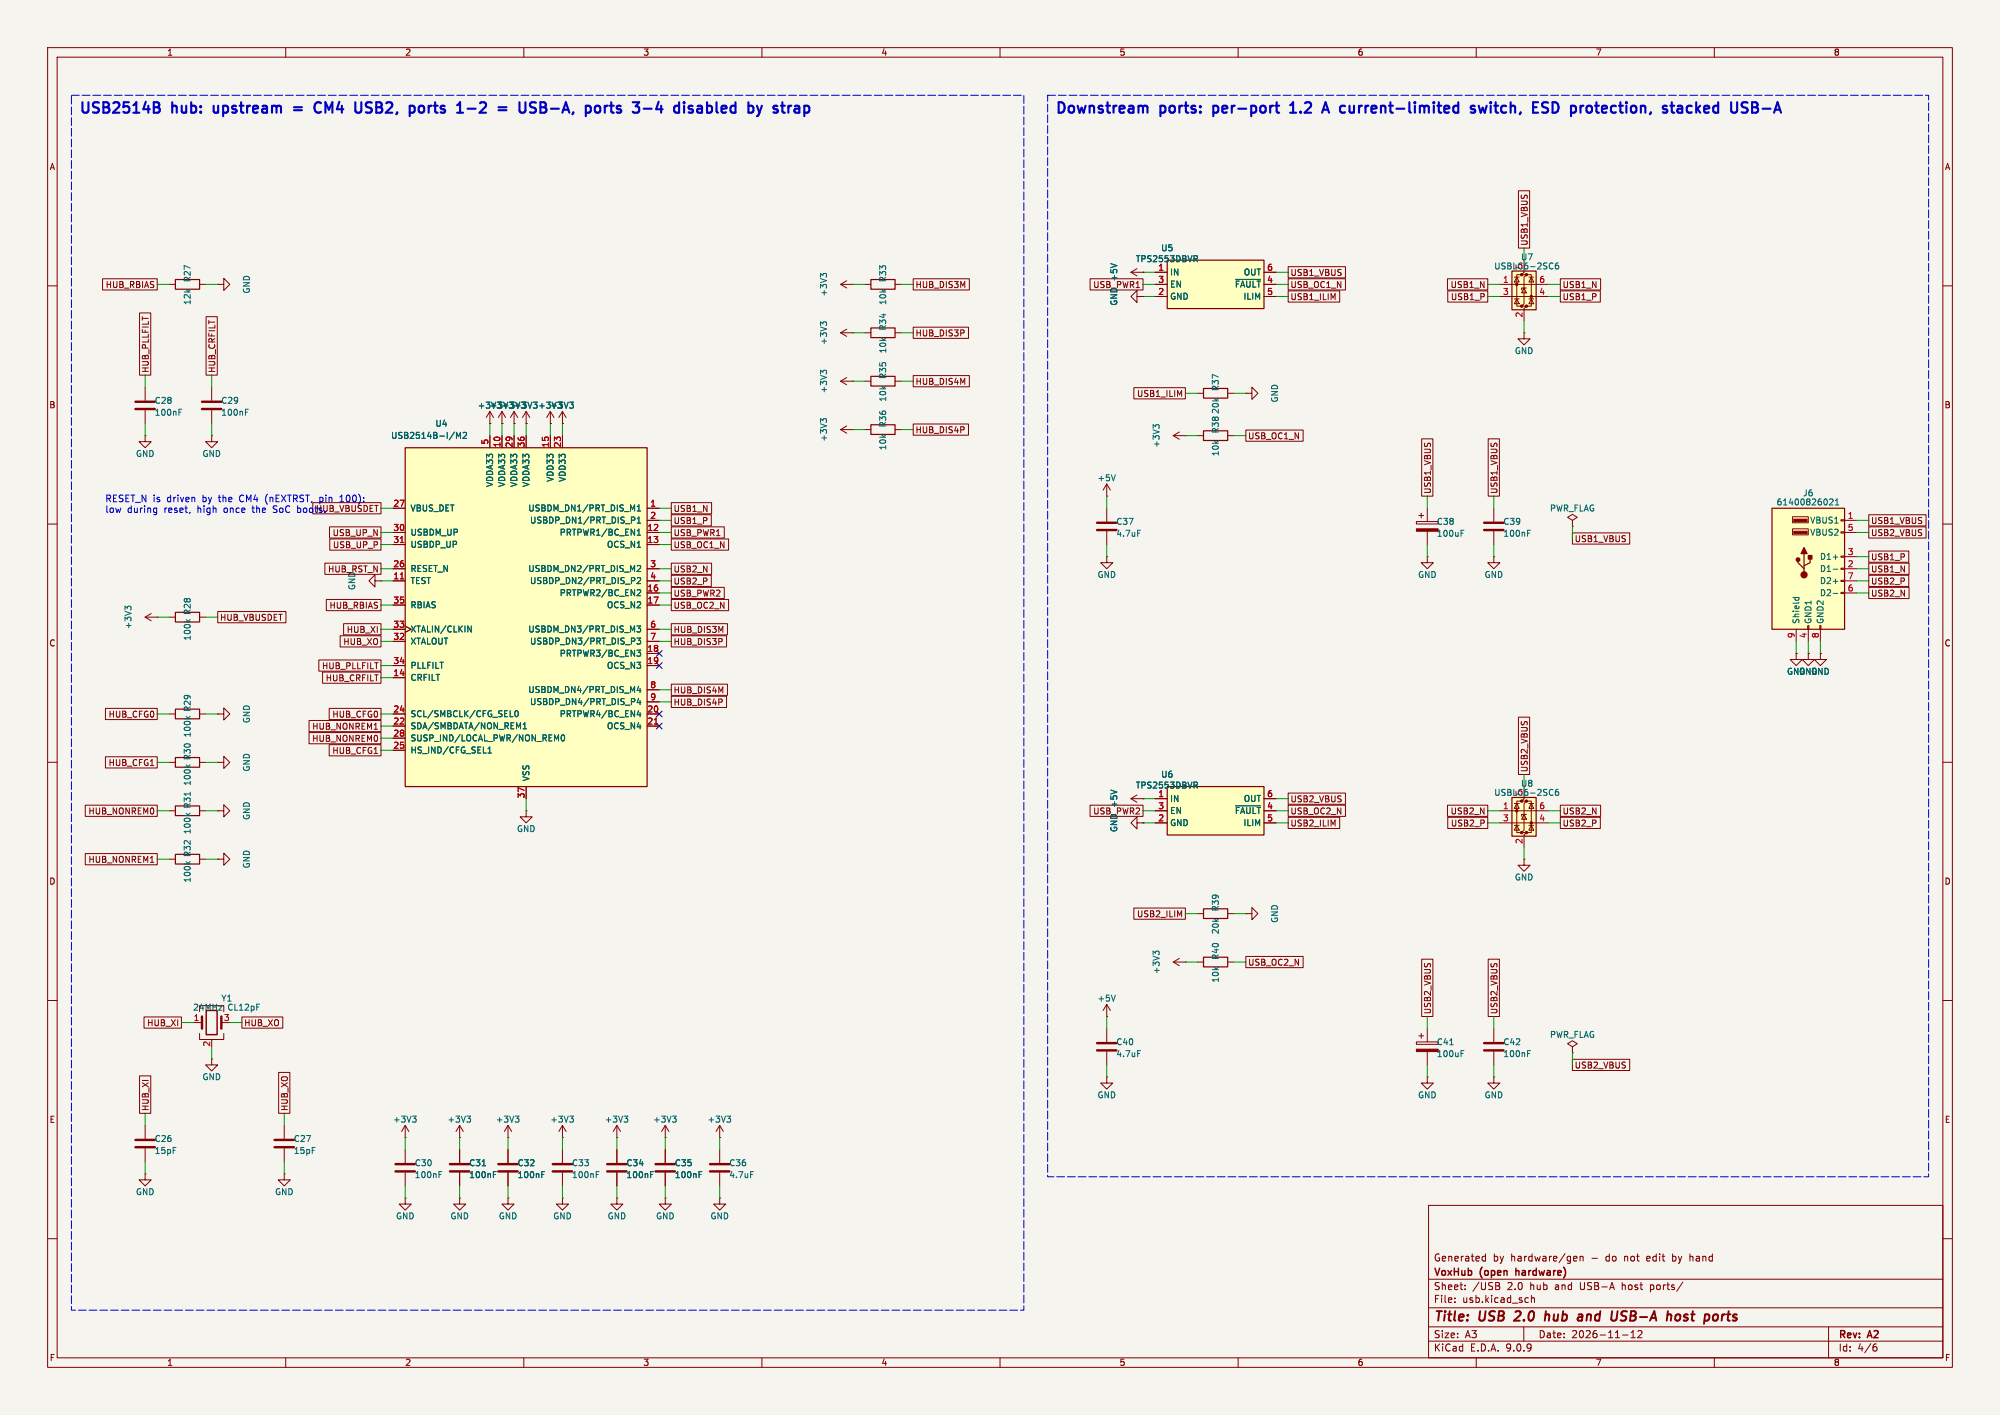
[picture p23: page 4]

RESET_N is driven by the CM4 (nEXTRST, pin 100):

Id: 4/6 Title: USB 2.0 hub and USB-A host ports

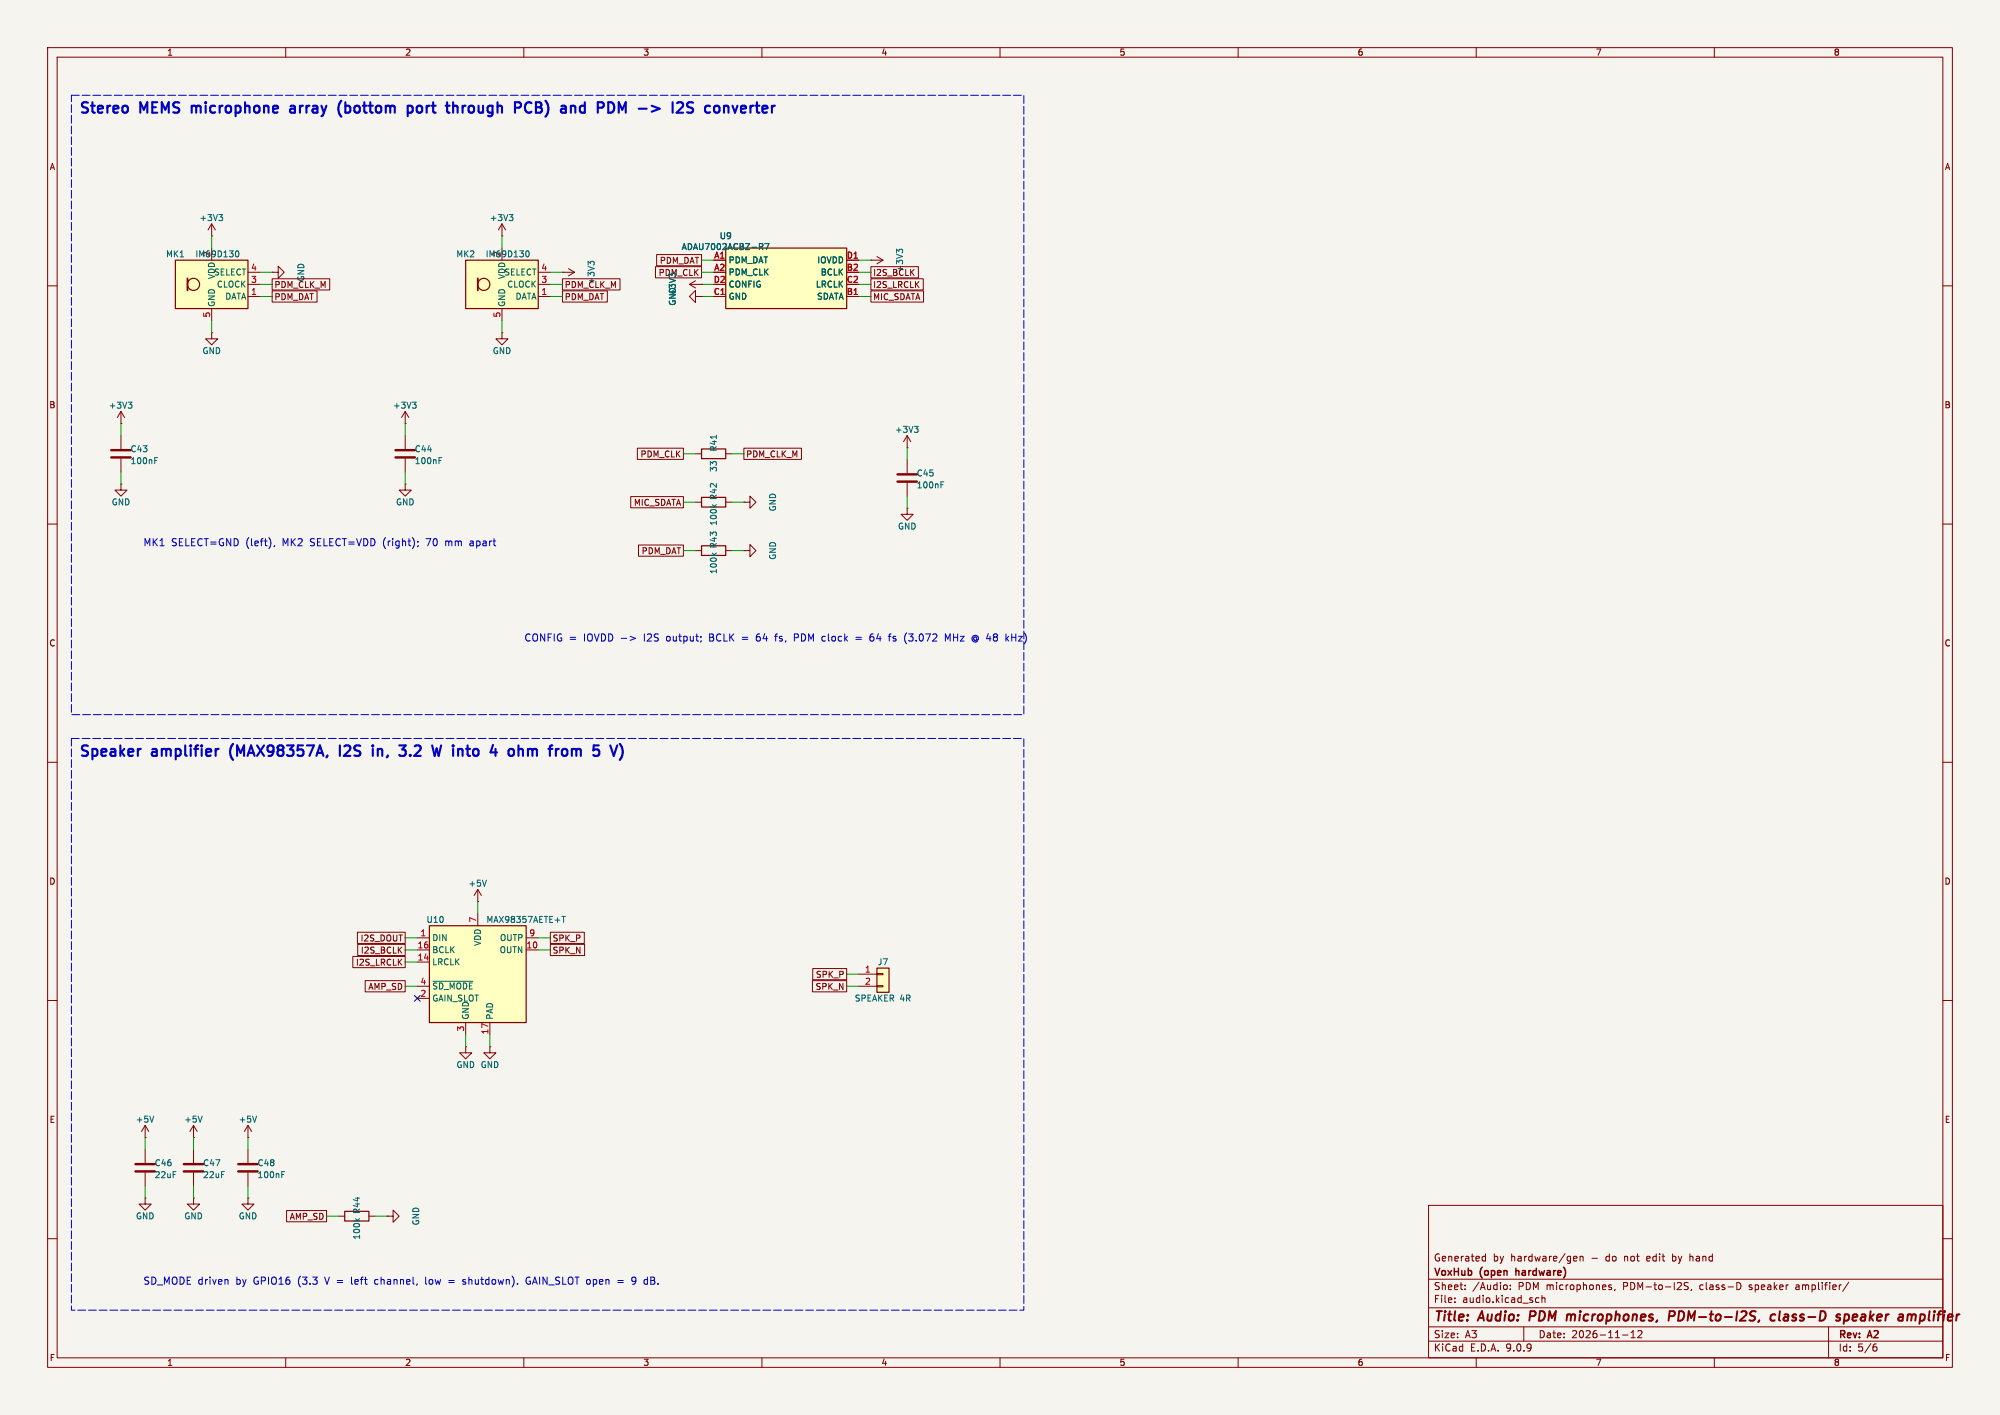
[picture p24: page 5]

5 SELECT 4 CLOCK 3 DATA 1 MK2 IM69D130 +3V3 GND GND VDD

7 PAD 17 OUTP 9 OUTN 10 U10 MAX98357AETE+T GND GND R41 33 GND R42 100k 1

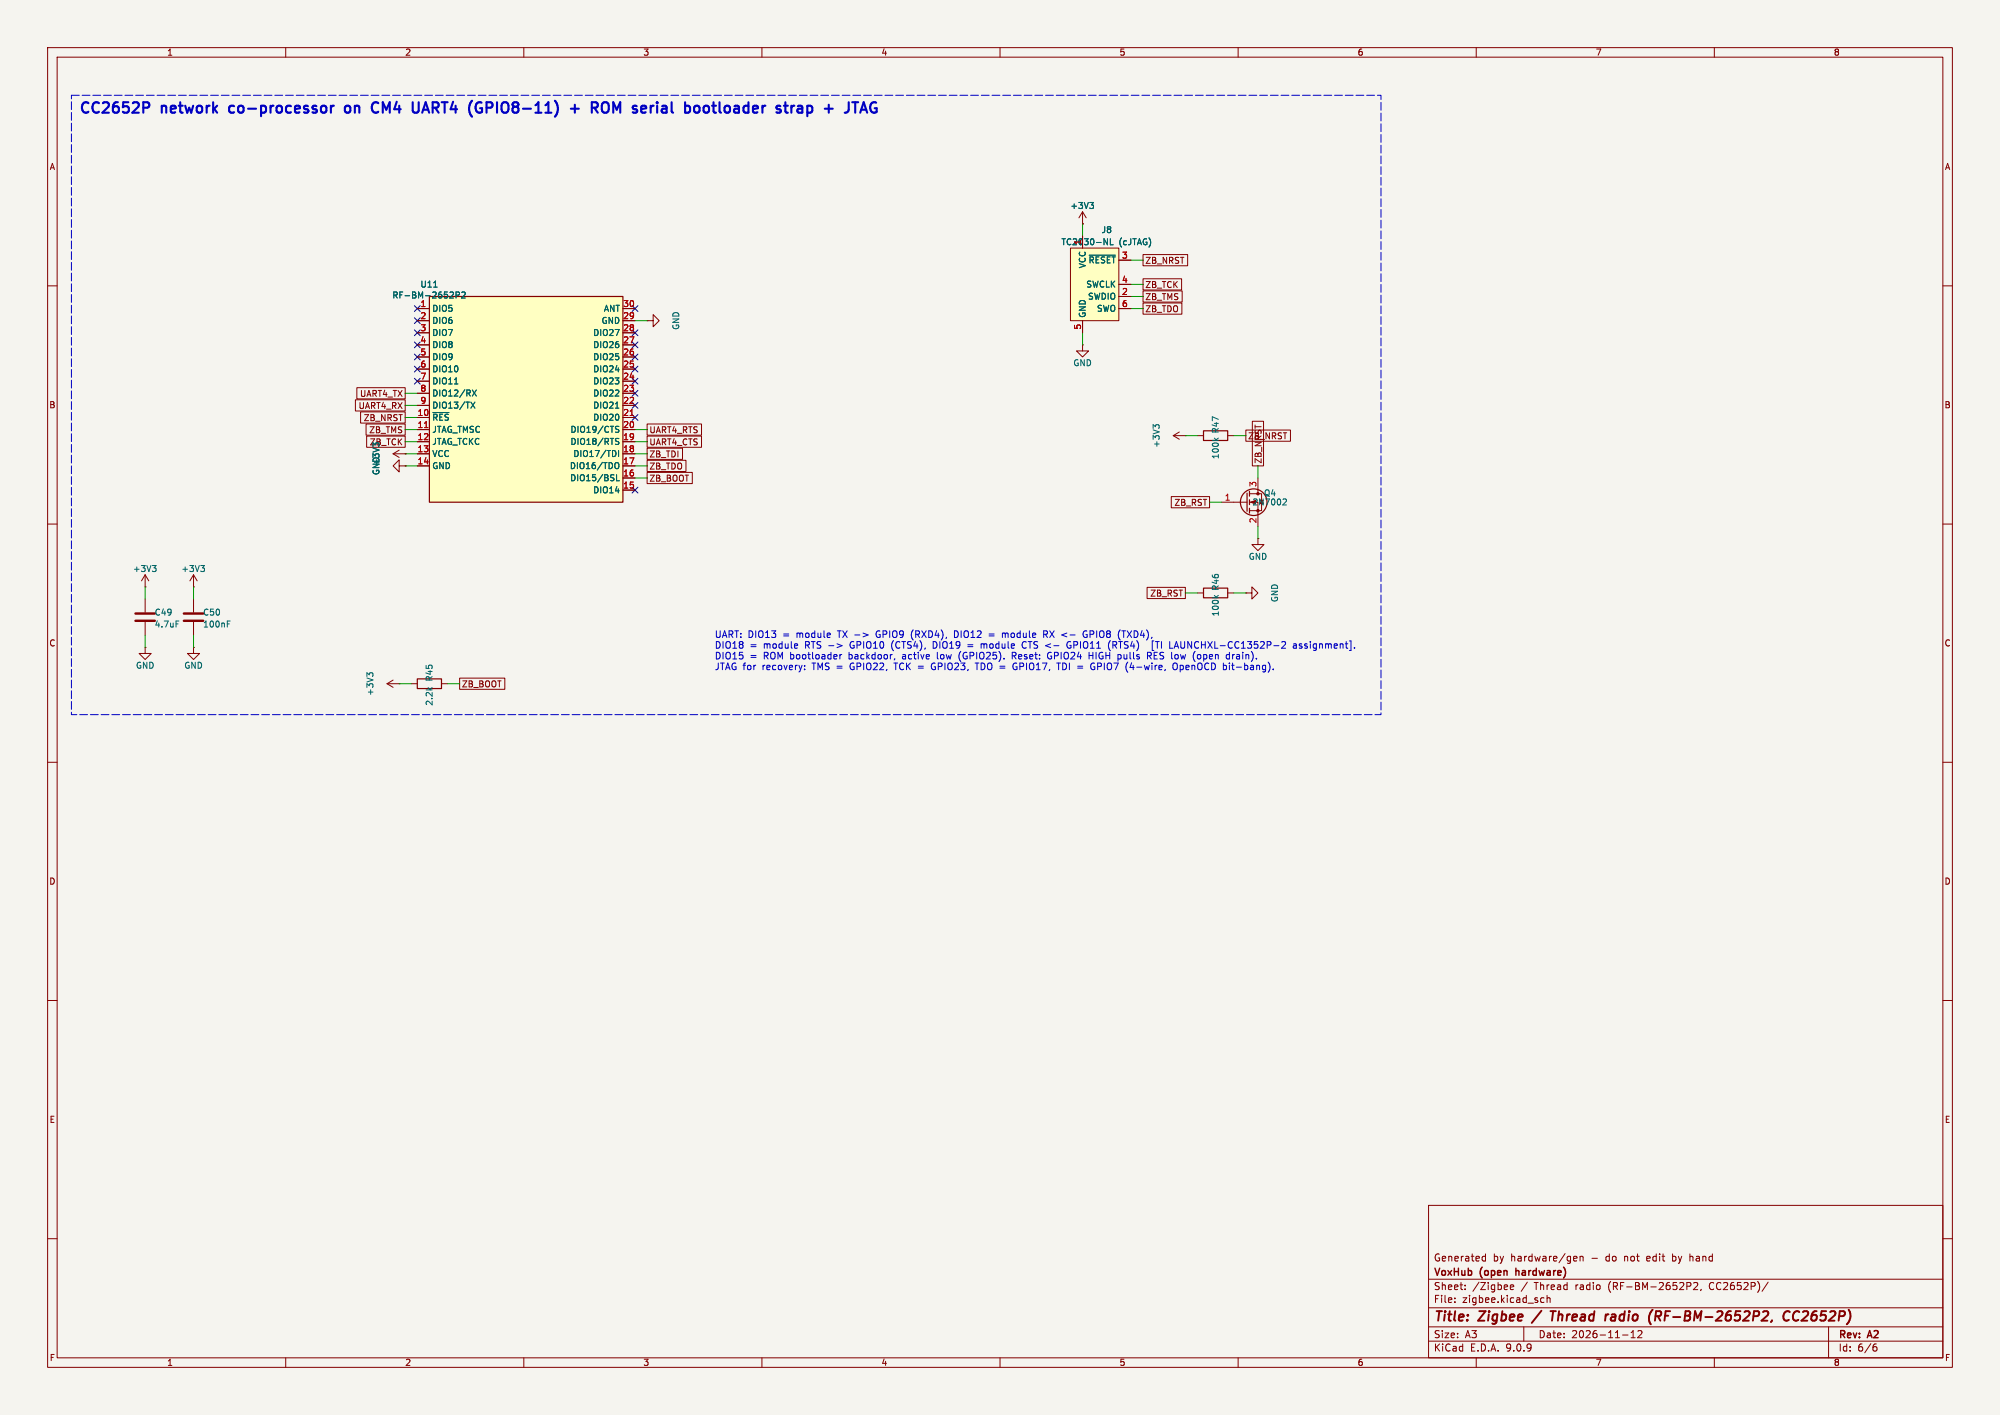
[picture p25: page 6]

5 ~{RESET}3 SWCLK 4 SWDIO 2 SWO 6
