geilevideossos-gamedev/fable-sbc-test/hardware/outputs/pcb_layers/voxhub.pdf

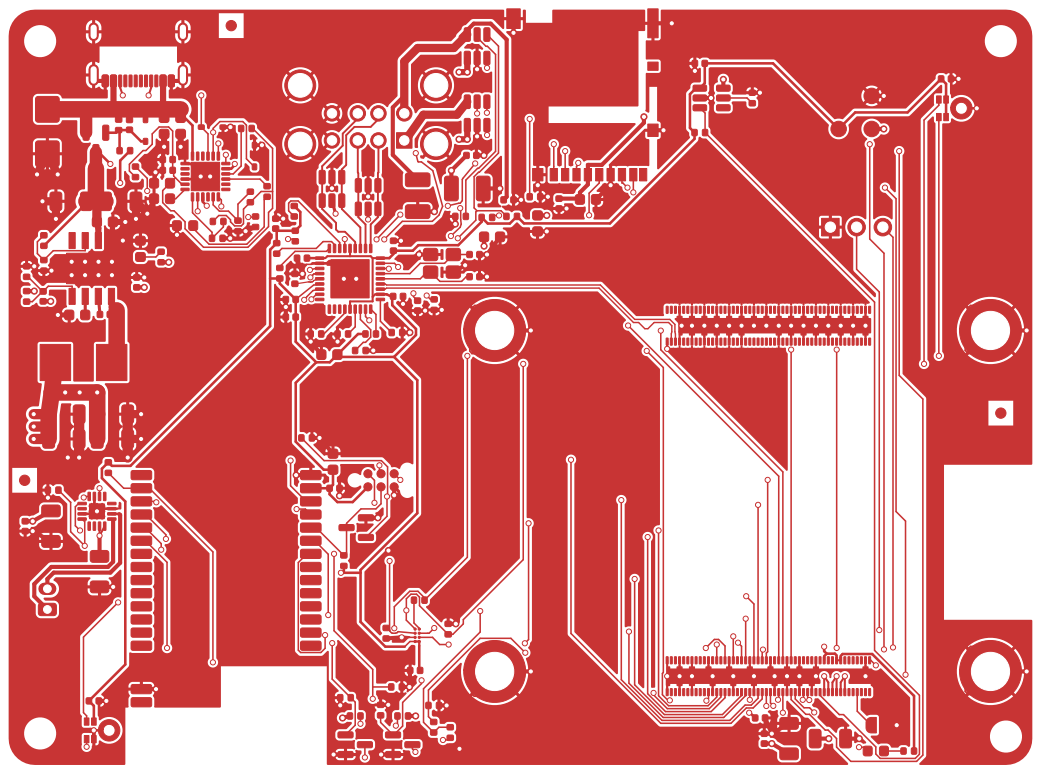
[picture p26: page 1]

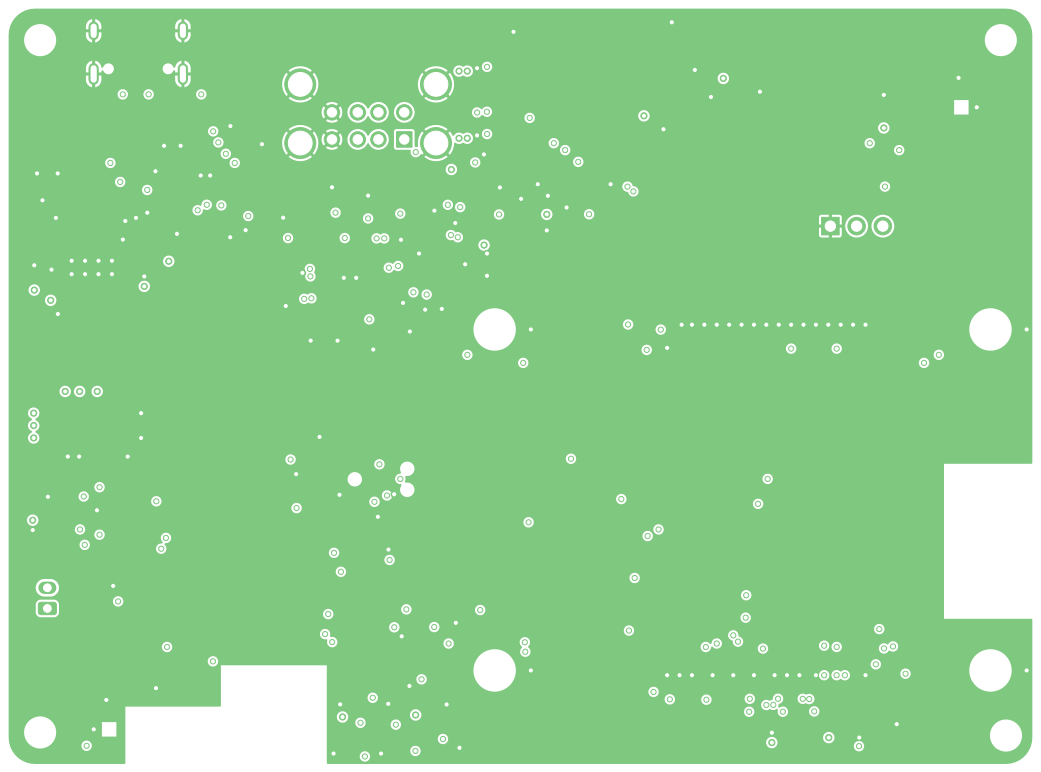
[picture p27: page 2]

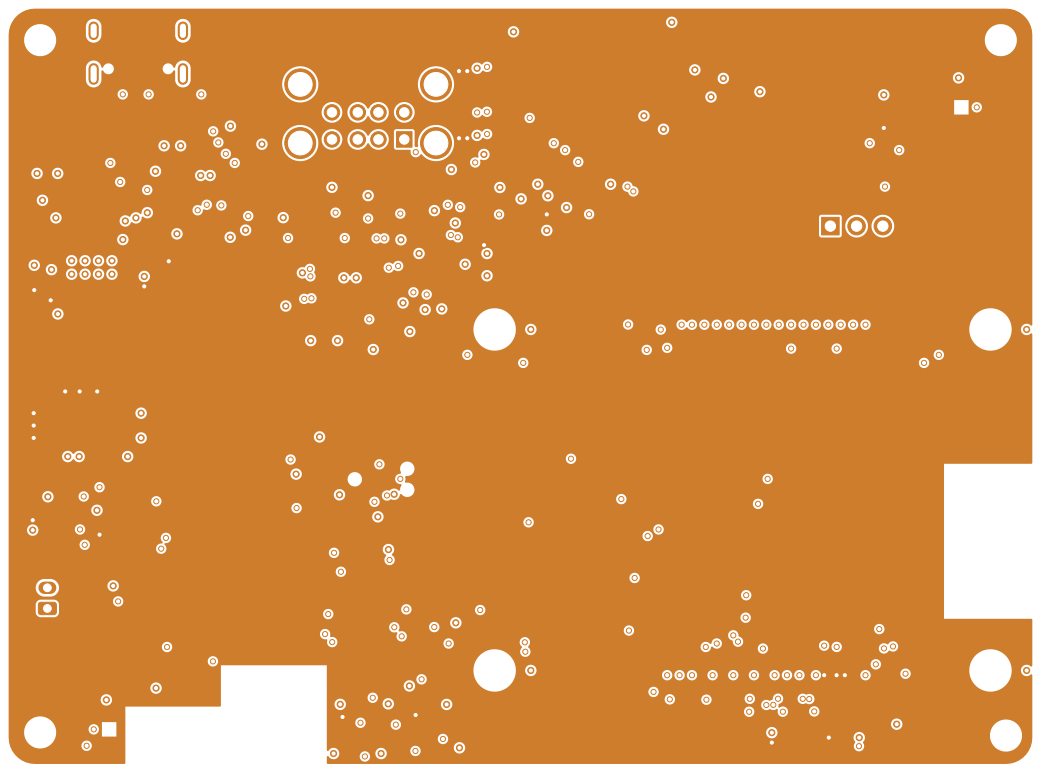
[picture p28: page 3]

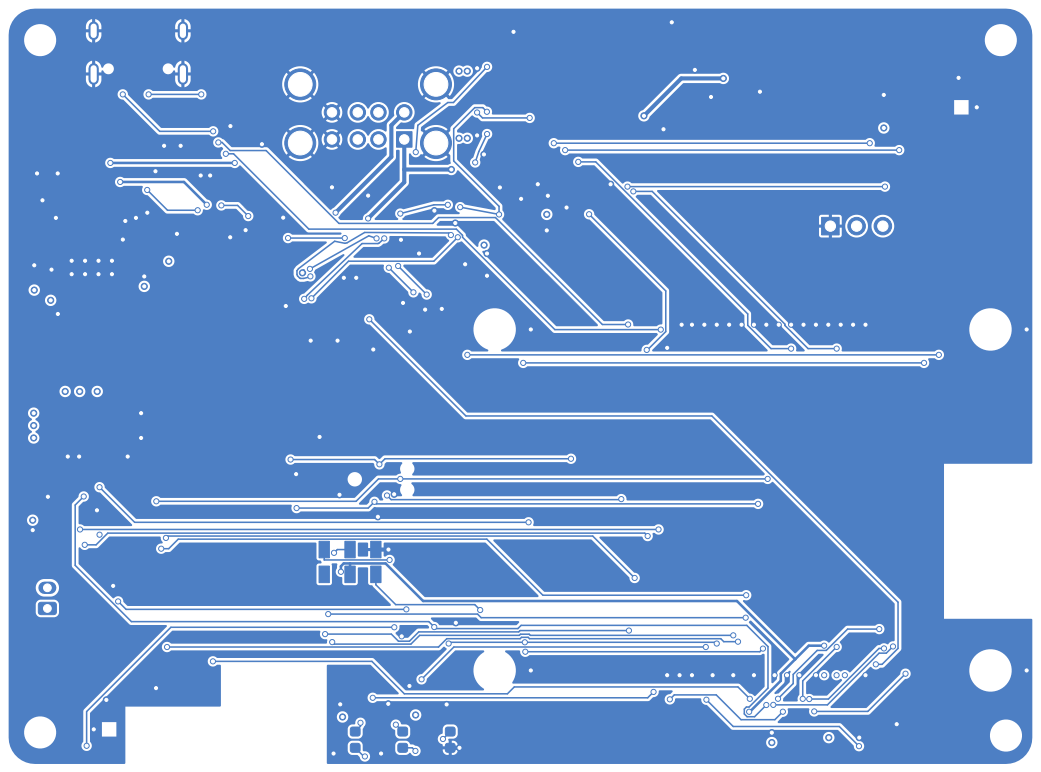
[picture p29: page 4]

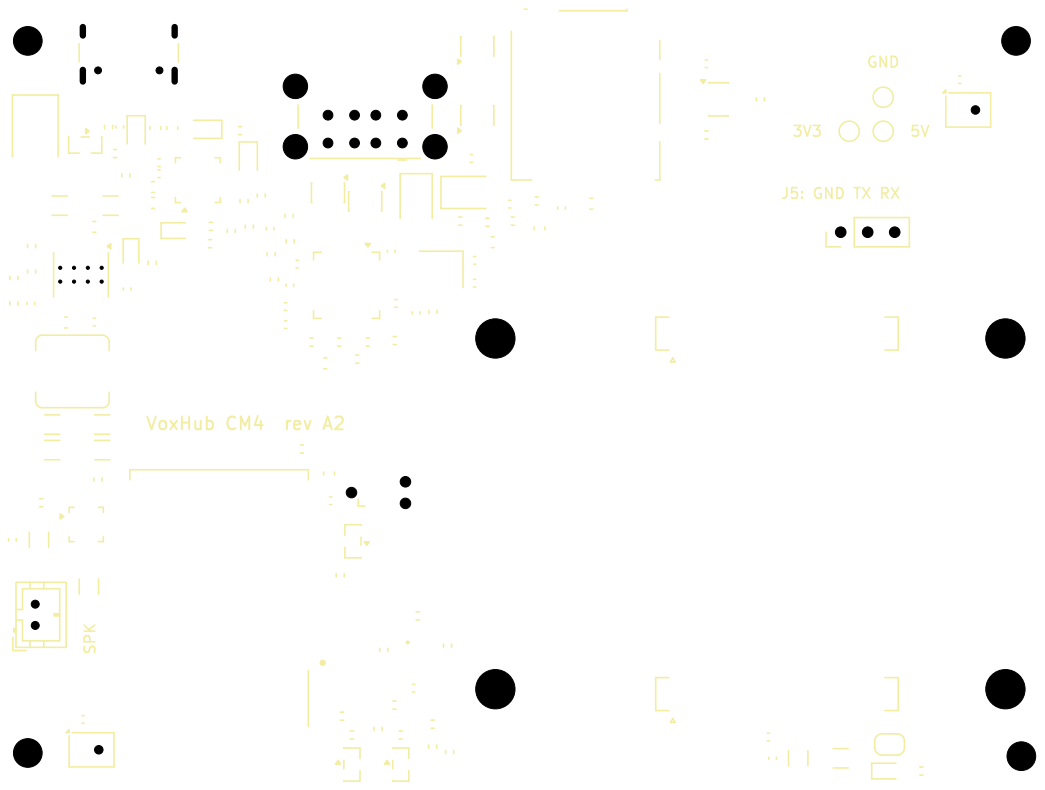
[picture p30: page 5]

J5: GND TX RX GND

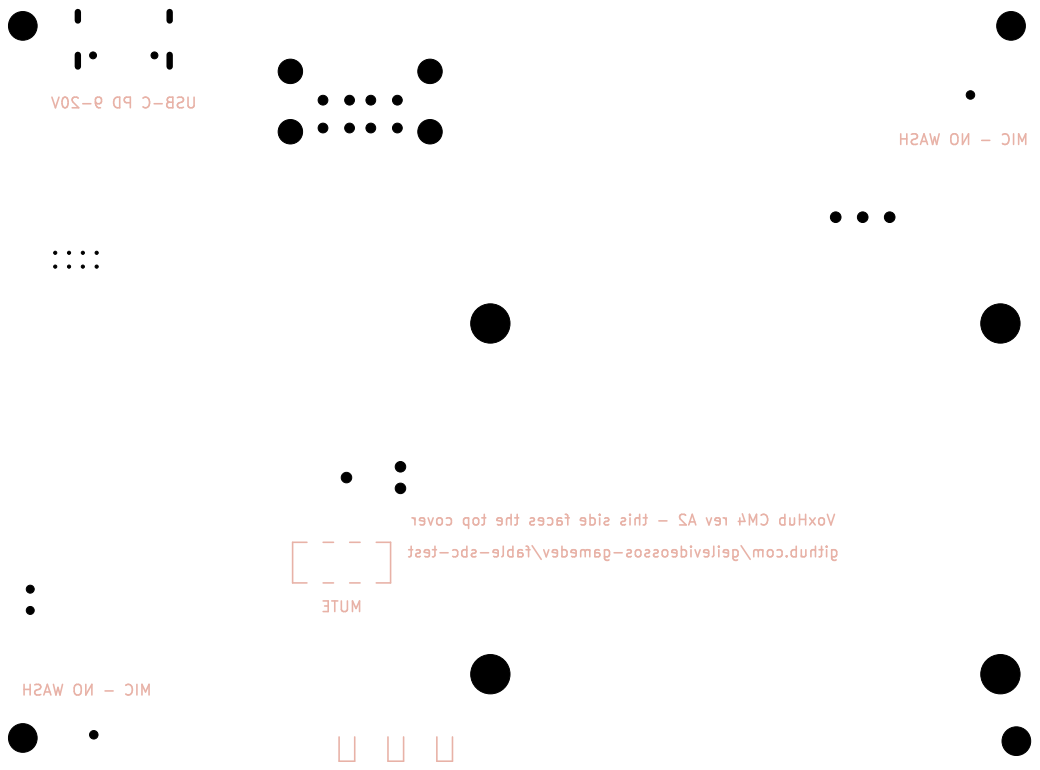
[picture p31: page 6]

github.com/geilevideossos-gamedev/fable-sbc-test WASH NO - MIC

cover top the faces side this - A2 rev CM4 VoxHub

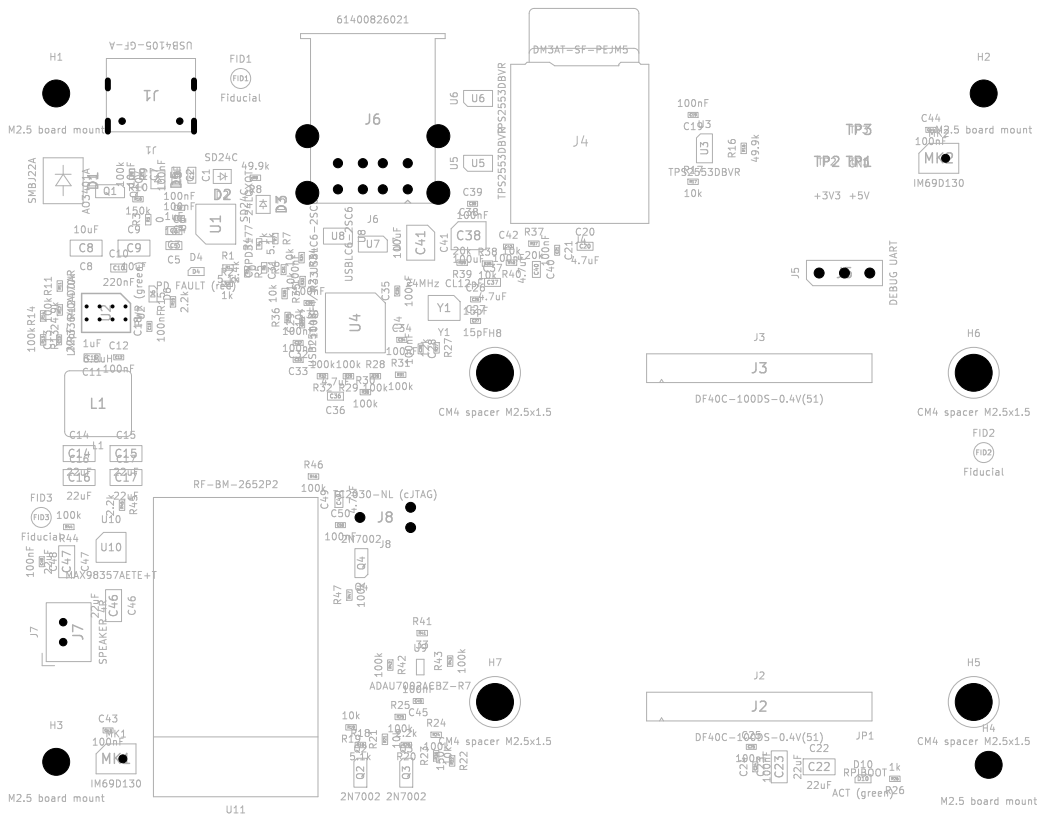
[picture p32: page 7]

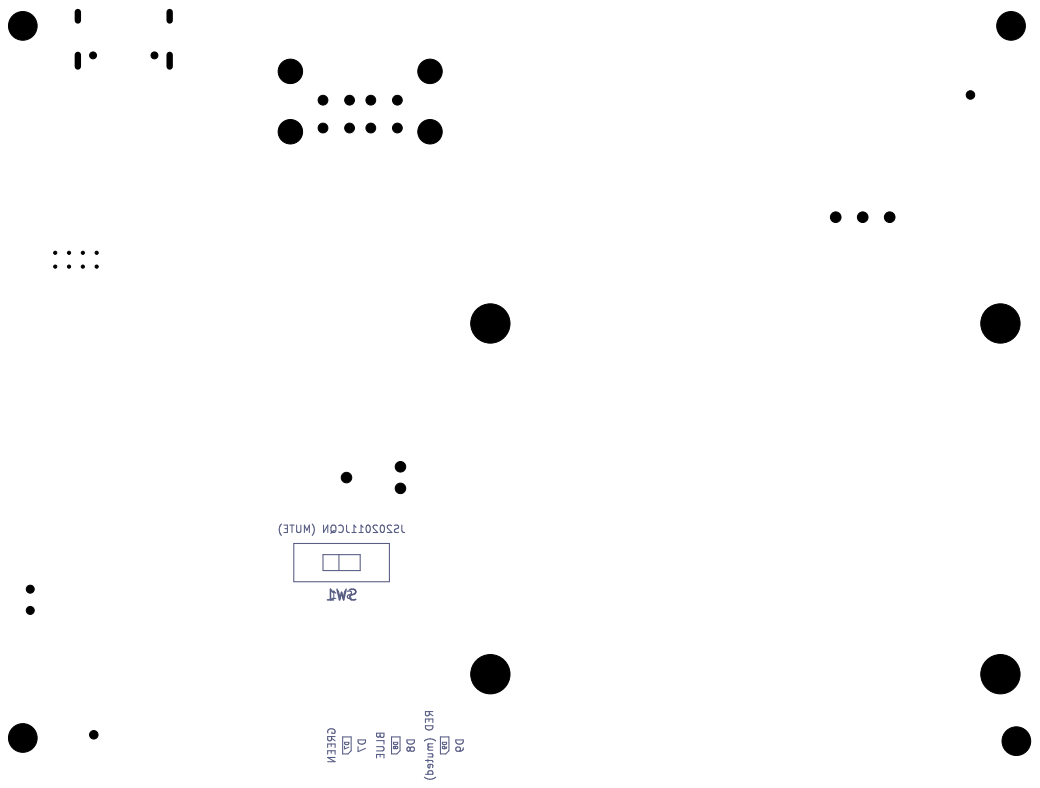
[picture p33: page 8]

(MUTE) JS202011JCQN SW1 D9 RED (muted) D8D9 BLUE D7D8 GREEN D7

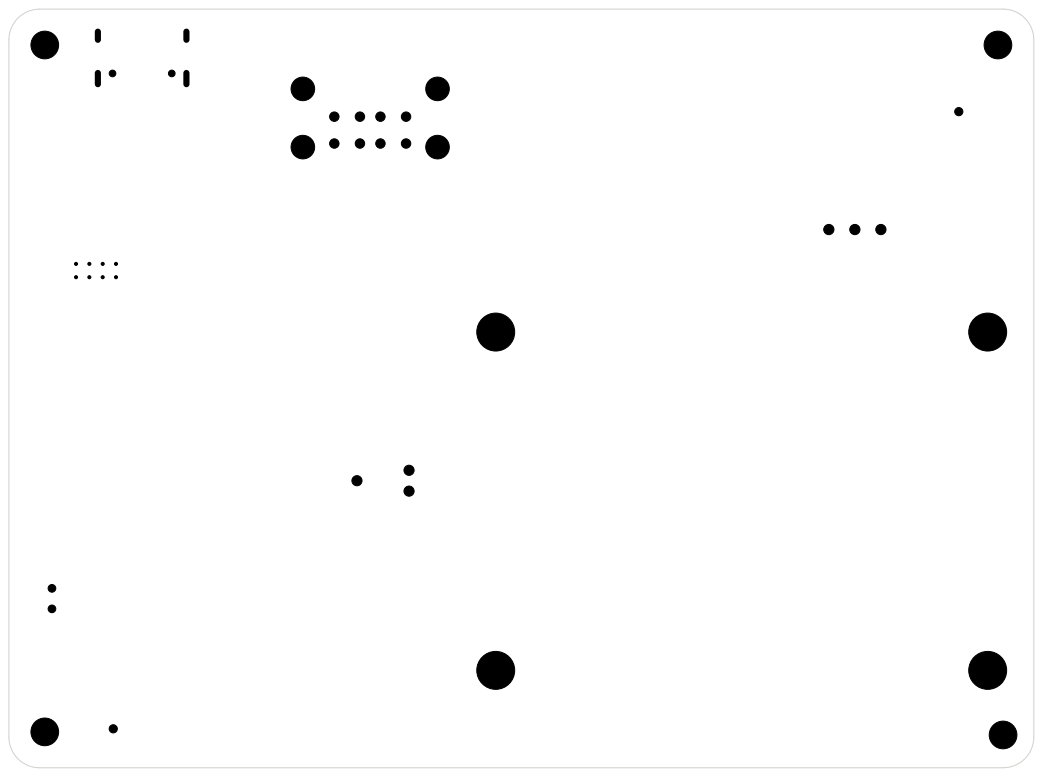
[picture p34: page 9]
