geilevideossos-gamedev/fable-sbc-test/hardware/voxhub.kicad_pcb

## KiCad design hardware/voxhub.kicad_pcb (2026-11-12)

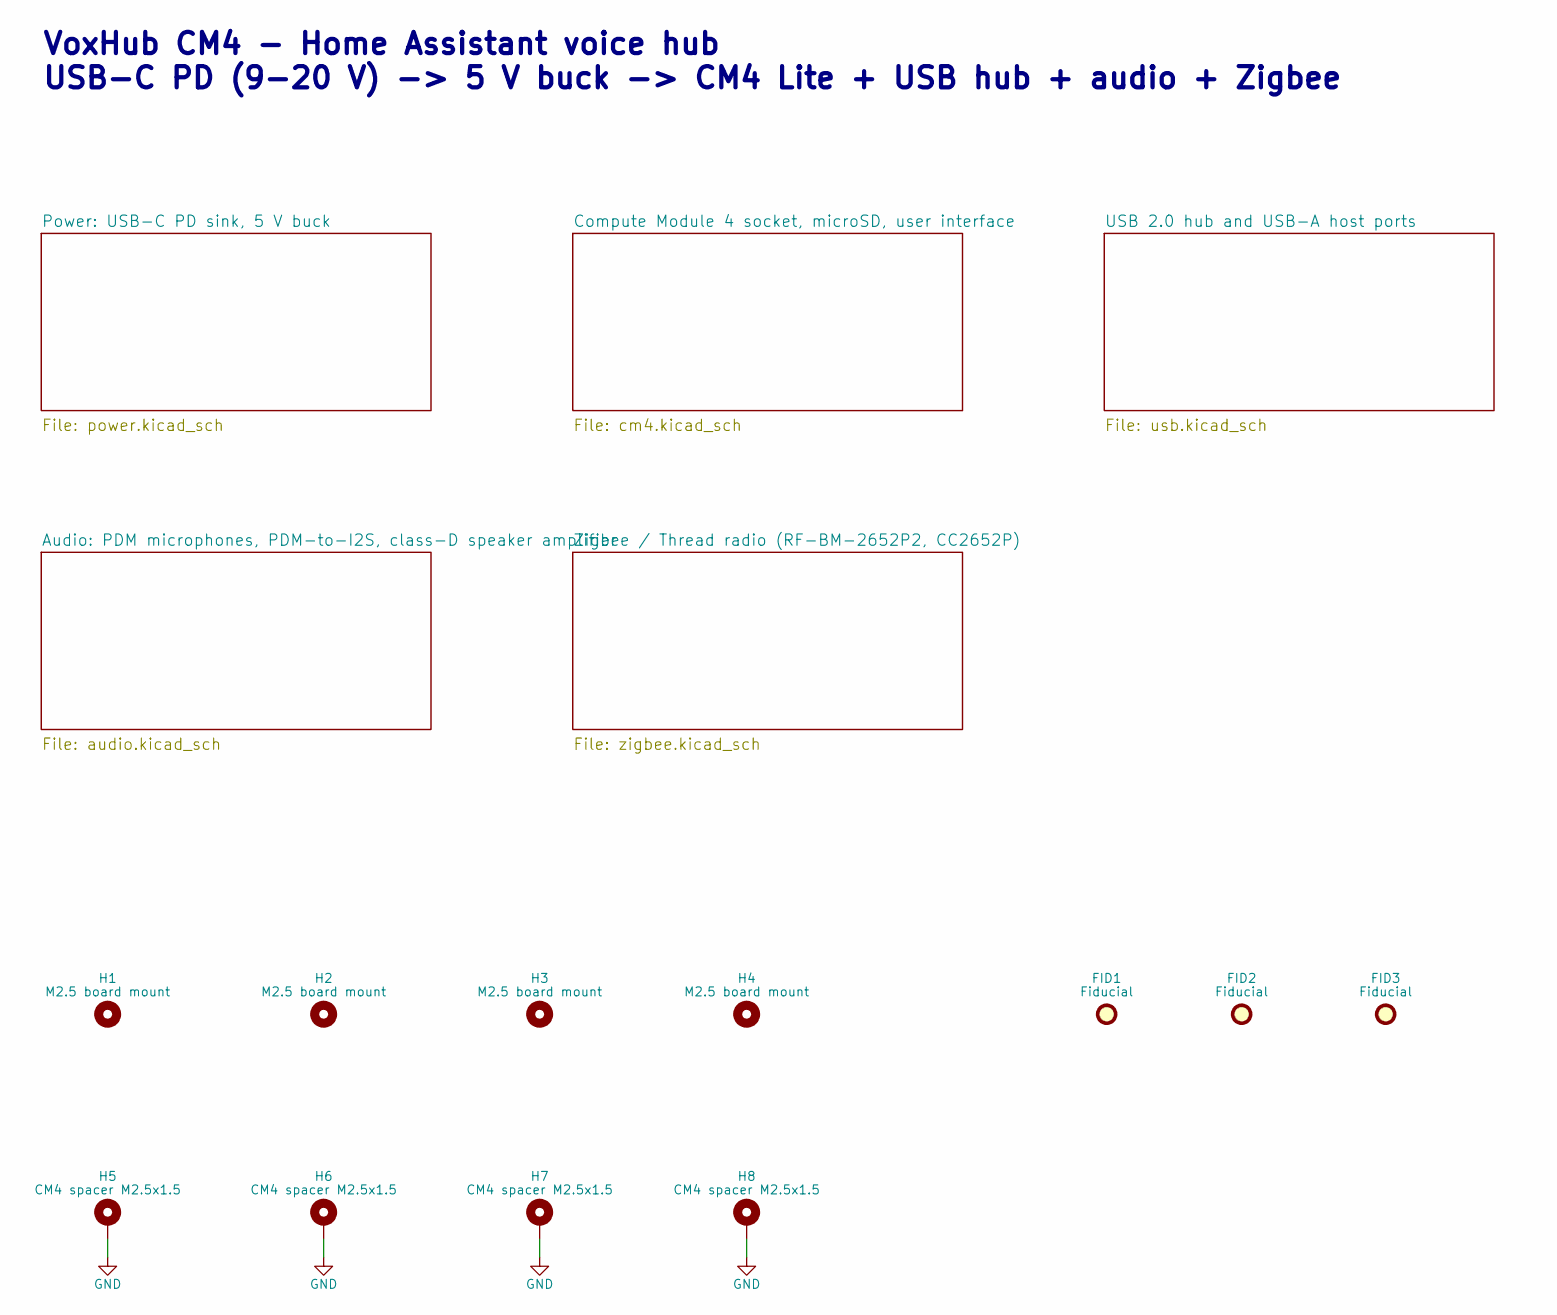
[picture p35: schematic voxhub.kicad_sch, VoxHub CM4 - Home Assistant voice hub carrier]

Parts:
FID1, FID2, FID3: Fiducial; Fiducial_1mm_Mask2mm; PartDescription Fiducial
H1, H2, H3, H4: M2.5 board mount; MountingHole_2.7mm_M2.5; PartDescription PCB mounting hole
H5, H6, H7, H8: CM4 spacer M2.5x1.5; Mounting_Wuerth_WA-SMSI-M2.5_H1.5mm_9774015151; MPN 9774015151R

Connections:
GND: H5.1, H6.1, H7.1, H8.1; also elsewhere on the board

Notes on the sheet:
VoxHub CM4 - Home Assistant voice hub USB-C PD (9-20 V) -> 5 V buck -> CM4 Lite + USB hub + audio + Zigbee

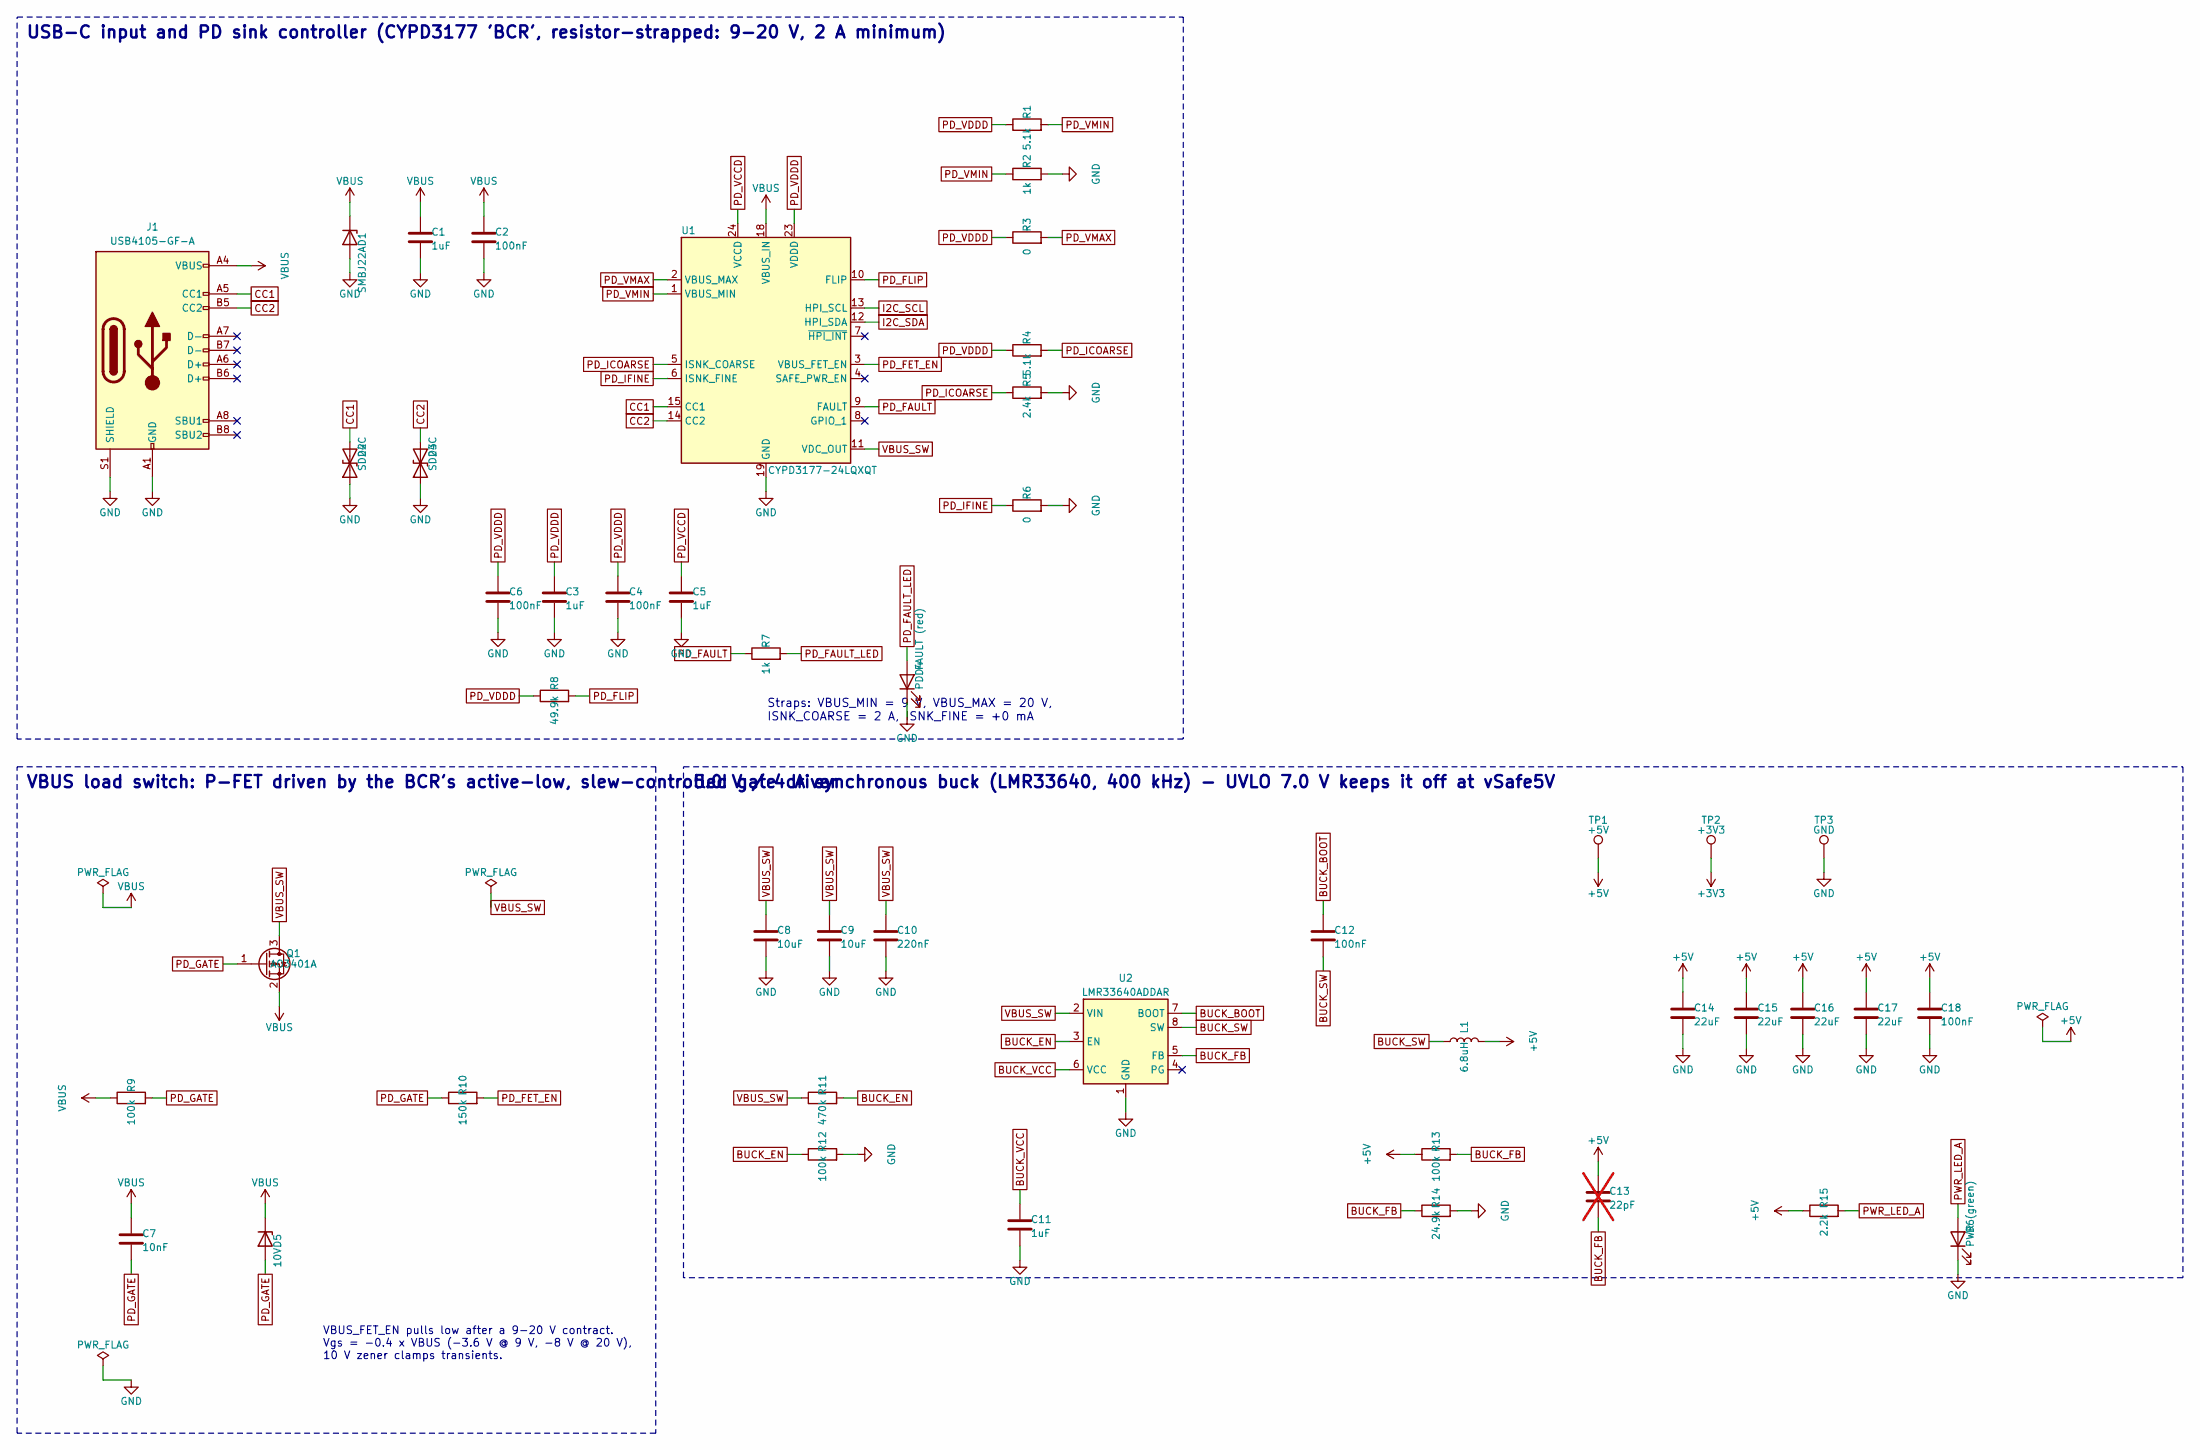
[picture p36: schematic power.kicad_sch, Power: USB-C PD sink, 5 V buck]

Parts:
C1: 1uF; C_0603_1608Metric; MPN CL10A105KB8NNNC
C2: 100nF; C_0603_1608Metric; MPN CC0603KRX7R9BB104
C3, C5, C11: 1uF; C_0603_1608Metric; MPN CL10B105KA8NNNC
C4, C6, C12, C18: 100nF; C_0402_1005Metric; MPN CL05B104KO5NNNC
C7: 10nF; C_0402_1005Metric; MPN CL05B103KB5NNNC
C8, C9: 10uF; C_1206_3216Metric; MPN CL31B106KBHNNNE
C10: 220nF; C_0603_1608Metric; MPN GRM188R71H224KAC4D
C13: 22pF; C_0402_1005Metric; MPN 0402CG220J500NT; not fitted
C14, C15, C16, C17: 22uF; C_1206_3216Metric; MPN CL31A226KAHNNNE
D1: SMBJ22A; D_SMB; MPN SMBJ22A
D2, D3: SD24C; D_SOD-323; MPN SD24C-01FTG
D4: PD FAULT (red); LED_0603_1608Metric; MPN LTST-C191KRKT
D5: 10V; D_SOD-323; MPN MM3Z10VT1G
D6: PWR (green); LED_0603_1608Metric; MPN 150060VS75000
J1: USB4105-GF-A; USB_C_Receptacle_GCT_USB4105-xx-A_16P_TopMnt_Horizontal; MPN USB4105-GF-A
L1: 6.8uH; L_Bourns_SRP7028A_7.3x6.6mm; MPN SLO0630H6R8MTT
Q1: AO3401A; SOT-23; MPN AO3401A
R1, R4: 5.1k; R_0402_1005Metric; MPN 0402WGF5101TCE
R2, R7: 1k; R_0402_1005Metric; MPN 0402WGF1001TCE
R3, R6: 0; R_0402_1005Metric; MPN 0402WGF0000TCE
R5: 2.4k; R_0402_1005Metric; MPN 0402WGF2401TCE
R8: 49.9k; R_0402_1005Metric; MPN 0402WGF4992TCE
R9, R12, R13: 100k; R_0402_1005Metric; MPN 0402WGF1003TCE
R10: 150k; R_0402_1005Metric; MPN 0402WGF1503TCE
R11: 470k; R_0402_1005Metric; MPN 0402WGF4703TCE
R14: 24.9k; R_0402_1005Metric; MPN 0402WGF2492TCE
R15: 2.2k; R_0402_1005Metric; MPN 0402WGF2201TCE
TP1: +5V; TestPoint_Pad_D1.5mm; PartDescription Test pad (no part)
TP2: +3V3; TestPoint_Pad_D1.5mm; PartDescription Test pad (no part)
TP3: GND; TestPoint_Pad_D1.5mm; PartDescription Test pad (no part)
U1: CYPD3177-24LQXQT; QFN-24-1EP_4x4mm_P0.5mm_EP2.75x2.75mm; MPN CYPD3177-24LQXQT
U2: LMR33640ADDAR; Texas_HSOP-8-1EP_3.9x4.9mm_P1.27mm_ThermalVias; MPN LMR33640ADDAR

Connections:
+3V3: TP2.1; also elsewhere on the board
+5V: C13.1, C14.1, C15.1, C16.1, C17.1, C18.1, L1.2, R13.1, R15.1, TP1.1; also elsewhere on the board
BUCK_BOOT: C12.1, U2.7 (BOOT)
BUCK_EN: R11.2, R12.1, U2.3 (EN)
BUCK_FB: C13.2, R13.2, R14.1, U2.5 (FB)
BUCK_SW: C12.2, L1.1, U2.8 (SW)
BUCK_VCC: C11.1, U2.6 (VCC)
CC1: D2.2 (A2), J1.A5 (CC1), U1.15 (CC1)
CC2: D3.2 (A2), J1.B5 (CC2), U1.14 (CC2)
GND: C1.2, C2.2, C3.2, C4.2, C5.2, C6.2, C8.2, C9.2, C10.2, C11.2, C14.2, C15.2, C16.2, C17.2, C18.2, D1.2 (A), D2.1 (A1), D3.1 (A1), D4.1 (K), D6.1 (K), J1.A1 (GND), J1.A12 (GND), J1.B1 (GND), J1.B12 (GND), J1.S1 (SHIELD), R2.2, R5.2, R6.2, R12.2, R14.2, TP3.1, U1.19 (GND), U1.22 (GND), U1.25 (GND), U2.1 (GND), U2.9 (GND); also elsewhere on the board
I2C_SCL: U1.13 (HPI_SCL); also elsewhere on the board
I2C_SDA: U1.12 (HPI_SDA); also elsewhere on the board
PD_FAULT: R7.1, U1.9 (FAULT)
PD_FAULT_LED: D4.2 (A), R7.2
PD_FET_EN: R10.2, U1.3 (VBUS_FET_EN)
PD_FLIP: R8.2, U1.10 (FLIP)
PD_GATE: C7.2, D5.2 (A), Q1.1 (G), R9.2, R10.1
PD_ICOARSE: R4.2, R5.1, U1.5 (ISNK_COARSE)
PD_IFINE: R6.1, U1.6 (ISNK_FINE)
PD_VCCD: C5.1, U1.24 (VCCD)
PD_VDDD: C3.1, C4.1, C6.1, R1.1, R3.1, R4.1, R8.1, U1.23 (VDDD)
PD_VMAX: R3.2, U1.2 (VBUS_MAX)
PD_VMIN: R1.2, R2.1, U1.1 (VBUS_MIN)
PWR_LED_A: D6.2 (A), R15.2
VBUS: C1.1, C2.1, C7.1, D1.1 (K), D5.1 (K), J1.A4 (VBUS), J1.A9 (VBUS), J1.B4 (VBUS), J1.B9 (VBUS), Q1.2 (S), R9.1, U1.18 (VBUS_IN)
VBUS_SW: C8.1, C9.1, C10.1, Q1.3 (D), R11.1, U1.11 (VDC_OUT), U2.2 (VIN)

Notes on the sheet:
USB-C input and PD sink controller (CYPD3177 'BCR', resistor-strapped: 9-20 V, 2 A minimum)
Straps: VBUS_MIN = 9 V, VBUS_MAX = 20 V, ISNK_COARSE = 2 A, ISNK_FINE = +0 mA
VBUS load switch: P-FET driven by the BCR's active-low, slew-controlled gate driver
VBUS_FET_EN pulls low after a 9-20 V contract. Vgs = -0.4 x VBUS (-3.6 V @ 9 V, -8 V @ 20 V), 10 V zener clamps transients.
5.0 V / 4 A synchronous buck (LMR33640, 400 kHz) - UVLO 7.0 V keeps it off at vSafe5V

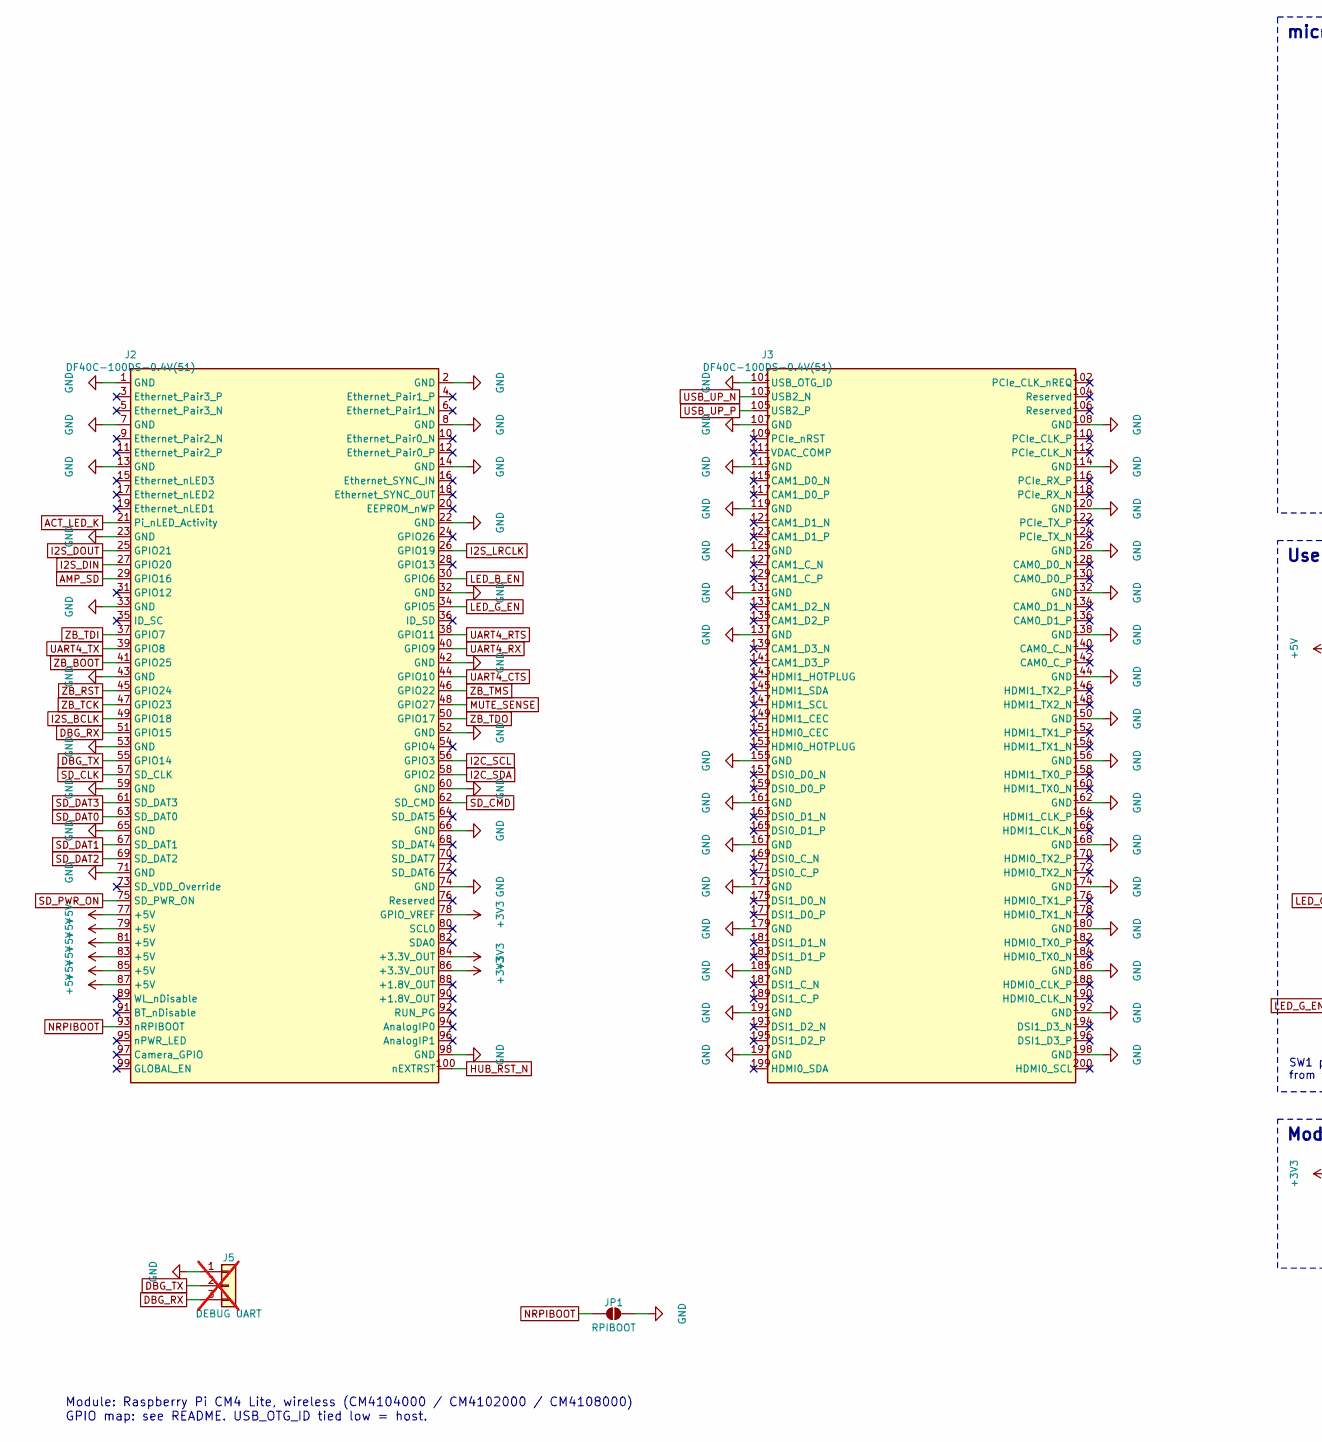
[picture p37: schematic cm4.kicad_sch, Compute Module 4 socket, microSD, user interface, part in row 1, column 1]

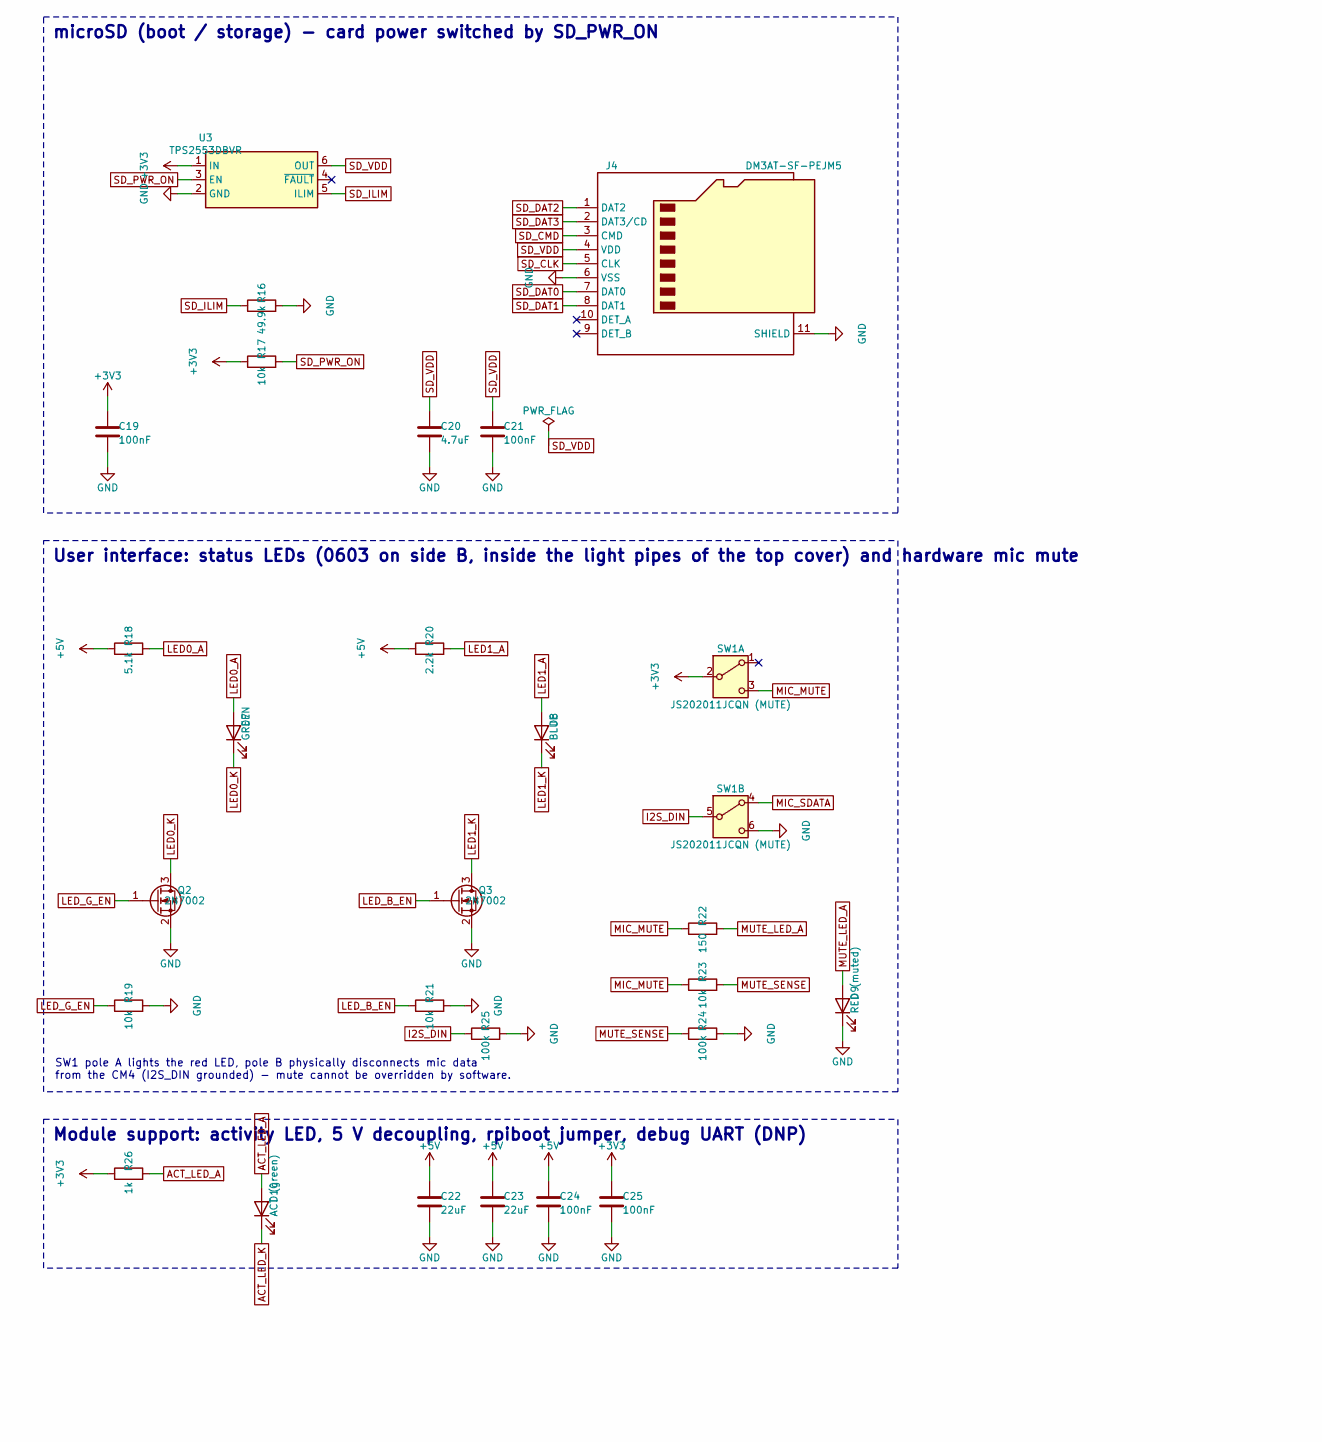
[picture p38: schematic cm4.kicad_sch, Compute Module 4 socket, microSD, user interface, part in row 1, column 2]

Parts:
C19, C21, C24, C25: 100nF; C_0402_1005Metric; MPN CL05B104KO5NNNC
C20: 4.7uF; C_0603_1608Metric; MPN CL10A475KA8NQNC
C22, C23: 22uF; C_1206_3216Metric; MPN CL31A226KAHNNNE
D7: GREEN; LED_0603_1608Metric; MPN KT-0603G
D8: BLUE; LED_0603_1608Metric; MPN KT-0603B
D9: RED (muted); LED_0603_1608Metric; MPN LTST-C191KRKT
D10: ACT (green); LED_0603_1608Metric; MPN 150060VS75000
J2: DF40C-100DS-0.4V(51); CM4_J1_DF40C-100DS; MPN DF40C-100DS-0.4V(51)
J3: DF40C-100DS-0.4V(51); CM4_J2_DF40C-100DS; MPN DF40C-100DS-0.4V(51)
J4: DM3AT-SF-PEJM5; microSD_HC_Hirose_DM3AT-SF-PEJM5; MPN DM3AT-SF-PEJM5
J5: DEBUG UART; PinHeader_1x03_P2.54mm_Vertical; MPN 61300311121; not fitted
JP1: RPIBOOT; SolderJumper-2_P1.3mm_Open_RoundedPad1.0x1.5mm; PartDescription Solder jumper (no part)
Q2, Q3: 2N7002; SOT-23; MPN 2N7002,215
R16: 49.9k; R_0402_1005Metric; MPN 0402WGF4992TCE
R17, R19, R21, R23: 10k; R_0402_1005Metric; MPN 0402WGF1002TCE
R18: 5.1k; R_0402_1005Metric; MPN 0402WGF5101TCE
R20: 2.2k; R_0402_1005Metric; MPN 0402WGF2201TCE
R22: 150; R_0402_1005Metric; MPN 0402WGF1500TCE
R24, R25: 100k; R_0402_1005Metric; MPN 0402WGF1003TCE
R26: 1k; R_0402_1005Metric; MPN 0402WGF1001TCE
SW1: JS202011JCQN (MUTE); SW_DPDT_CK_JS202011JCQN; MPN JS202011JCQN
U3: TPS2553DBVR; SOT-23-6; MPN TPS2553DBVR

Connections:
+3V3: C19.1, C25.1, J2.78 (GPIO_VREF), J2.84 (+3.3V_OUT), J2.86 (+3.3V_OUT), R17.1, R26.1, SW1.2 (B), U3.1 (IN); also elsewhere on the board
+5V: C22.1, C23.1, C24.1, J2.77 (+5V), J2.79 (+5V), J2.81 (+5V), J2.83 (+5V), J2.85 (+5V), J2.87 (+5V), R18.1, R20.1; also elsewhere on the board
ACT_LED_A: D10.2 (A), R26.2
ACT_LED_K: D10.1 (K), J2.21 (Pi_nLED_Activity)
AMP_SD: J2.29 (GPIO16); also elsewhere on the board
DBG_RX: J2.51 (GPIO15), J5.3
DBG_TX: J2.55 (GPIO14), J5.2
GND: C19.2, C20.2, C21.2, C22.2, C23.2, C24.2, C25.2, D9.1 (K), J2.1 (GND), J2.2 (GND), J2.7 (GND), J2.8 (GND), J2.13 (GND), J2.14 (GND), J2.22 (GND), J2.23 (GND), J2.32 (GND), J2.33 (GND), J2.42 (GND), J2.43 (GND), J2.52 (GND), J2.53 (GND), J2.59 (GND), J2.60 (GND), J2.65 (GND), J2.66 (GND), J2.71 (GND), J2.74 (GND), J2.98 (GND), J3.101 (USB_OTG_ID), J3.107 (GND), J3.108 (GND), J3.113 (GND), J3.114 (GND), J3.119 (GND), J3.120 (GND), J3.125 (GND), J3.126 (GND), J3.131 (GND), J3.132 (GND), J3.137 (GND), J3.138 (GND), J3.144 (GND), J3.150 (GND), J3.155 (GND), J3.156 (GND), J3.161 (GND), J3.162 (GND), J3.167 (GND), J3.168 (GND), J3.173 (GND), J3.174 (GND), J3.179 (GND), J3.180 (GND), J3.185 (GND), J3.186 (GND), J3.191 (GND), J3.192 (GND), J3.197 (GND), J3.198 (GND), J4.6 (VSS), J4.11 (SHIELD), J5.1, JP1.2 (B), Q2.2 (S), Q3.2 (S), R16.2, R19.2, R21.2, R24.2, R25.2, SW1.6 (C), U3.2 (GND); also elsewhere on the board
HUB_RST_N: J2.100 (nEXTRST); also elsewhere on the board
I2C_SCL: J2.56 (GPIO3); also elsewhere on the board
I2C_SDA: J2.58 (GPIO2); also elsewhere on the board
I2S_BCLK: J2.49 (GPIO18); also elsewhere on the board
I2S_DIN: J2.27 (GPIO20), R25.1, SW1.5 (B)
I2S_DOUT: J2.25 (GPIO21); also elsewhere on the board
I2S_LRCLK: J2.26 (GPIO19); also elsewhere on the board
LED0_A: D7.2 (A), R18.2
LED0_K: D7.1 (K), Q2.3 (D)
LED1_A: D8.2 (A), R20.2
LED1_K: D8.1 (K), Q3.3 (D)
LED_B_EN: J2.30 (GPIO6), Q3.1 (G), R21.1
LED_G_EN: J2.34 (GPIO5), Q2.1 (G), R19.1
MIC_MUTE: R22.1, R23.1, SW1.3 (C)
MIC_SDATA: SW1.4 (A); also elsewhere on the board
MUTE_LED_A: D9.2 (A), R22.2
MUTE_SENSE: J2.48 (GPIO27), R23.2, R24.1
NRPIBOOT: J2.93 (nRPIBOOT), JP1.1 (A)
SD_CLK: J2.57 (SD_CLK), J4.5 (CLK)
SD_CMD: J2.62 (SD_CMD), J4.3 (CMD)
SD_DAT0: J2.63 (SD_DAT0), J4.7 (DAT0)
SD_DAT1: J2.67 (SD_DAT1), J4.8 (DAT1)
SD_DAT2: J2.69 (SD_DAT2), J4.1 (DAT2)
SD_DAT3: J2.61 (SD_DAT3), J4.2 (DAT3/CD)
SD_ILIM: R16.1, U3.5 (ILIM)
SD_PWR_ON: J2.75 (SD_PWR_ON), R17.2, U3.3 (EN)
SD_VDD: C20.1, C21.1, J4.4 (VDD), U3.6 (OUT)
UART4_CTS: J2.44 (GPIO10); also elsewhere on the board
UART4_RTS: J2.38 (GPIO11); also elsewhere on the board
UART4_RX: J2.40 (GPIO9); also elsewhere on the board
UART4_TX: J2.39 (GPIO8); also elsewhere on the board
USB_UP_N: J3.103 (USB2_N); also elsewhere on the board
USB_UP_P: J3.105 (USB2_P); also elsewhere on the board
ZB_BOOT: J2.41 (GPIO25); also elsewhere on the board
ZB_RST: J2.45 (GPIO24); also elsewhere on the board
ZB_TCK: J2.47 (GPIO23); also elsewhere on the board
ZB_TDI: J2.37 (GPIO7); also elsewhere on the board
ZB_TDO: J2.50 (GPIO17); also elsewhere on the board
ZB_TMS: J2.46 (GPIO22); also elsewhere on the board

Notes on the sheet:
Module: Raspberry Pi CM4 Lite, wireless (CM4104000 / CM4102000 / CM4108000) GPIO map: see README. USB_OTG_ID tied low = host.
microSD (boot / storage) - card power switched by SD_PWR_ON
User interface: status LEDs (0603 on side B, inside the light pipes of the top cover) and hardware mic mute
SW1 pole A lights the red LED, pole B physically disconnects mic data from the CM4 (I2S_DIN grounded) - mute cannot be overridden by software.
Module support: activity LED, 5 V decoupling, rpiboot jumper, debug UART (DNP)

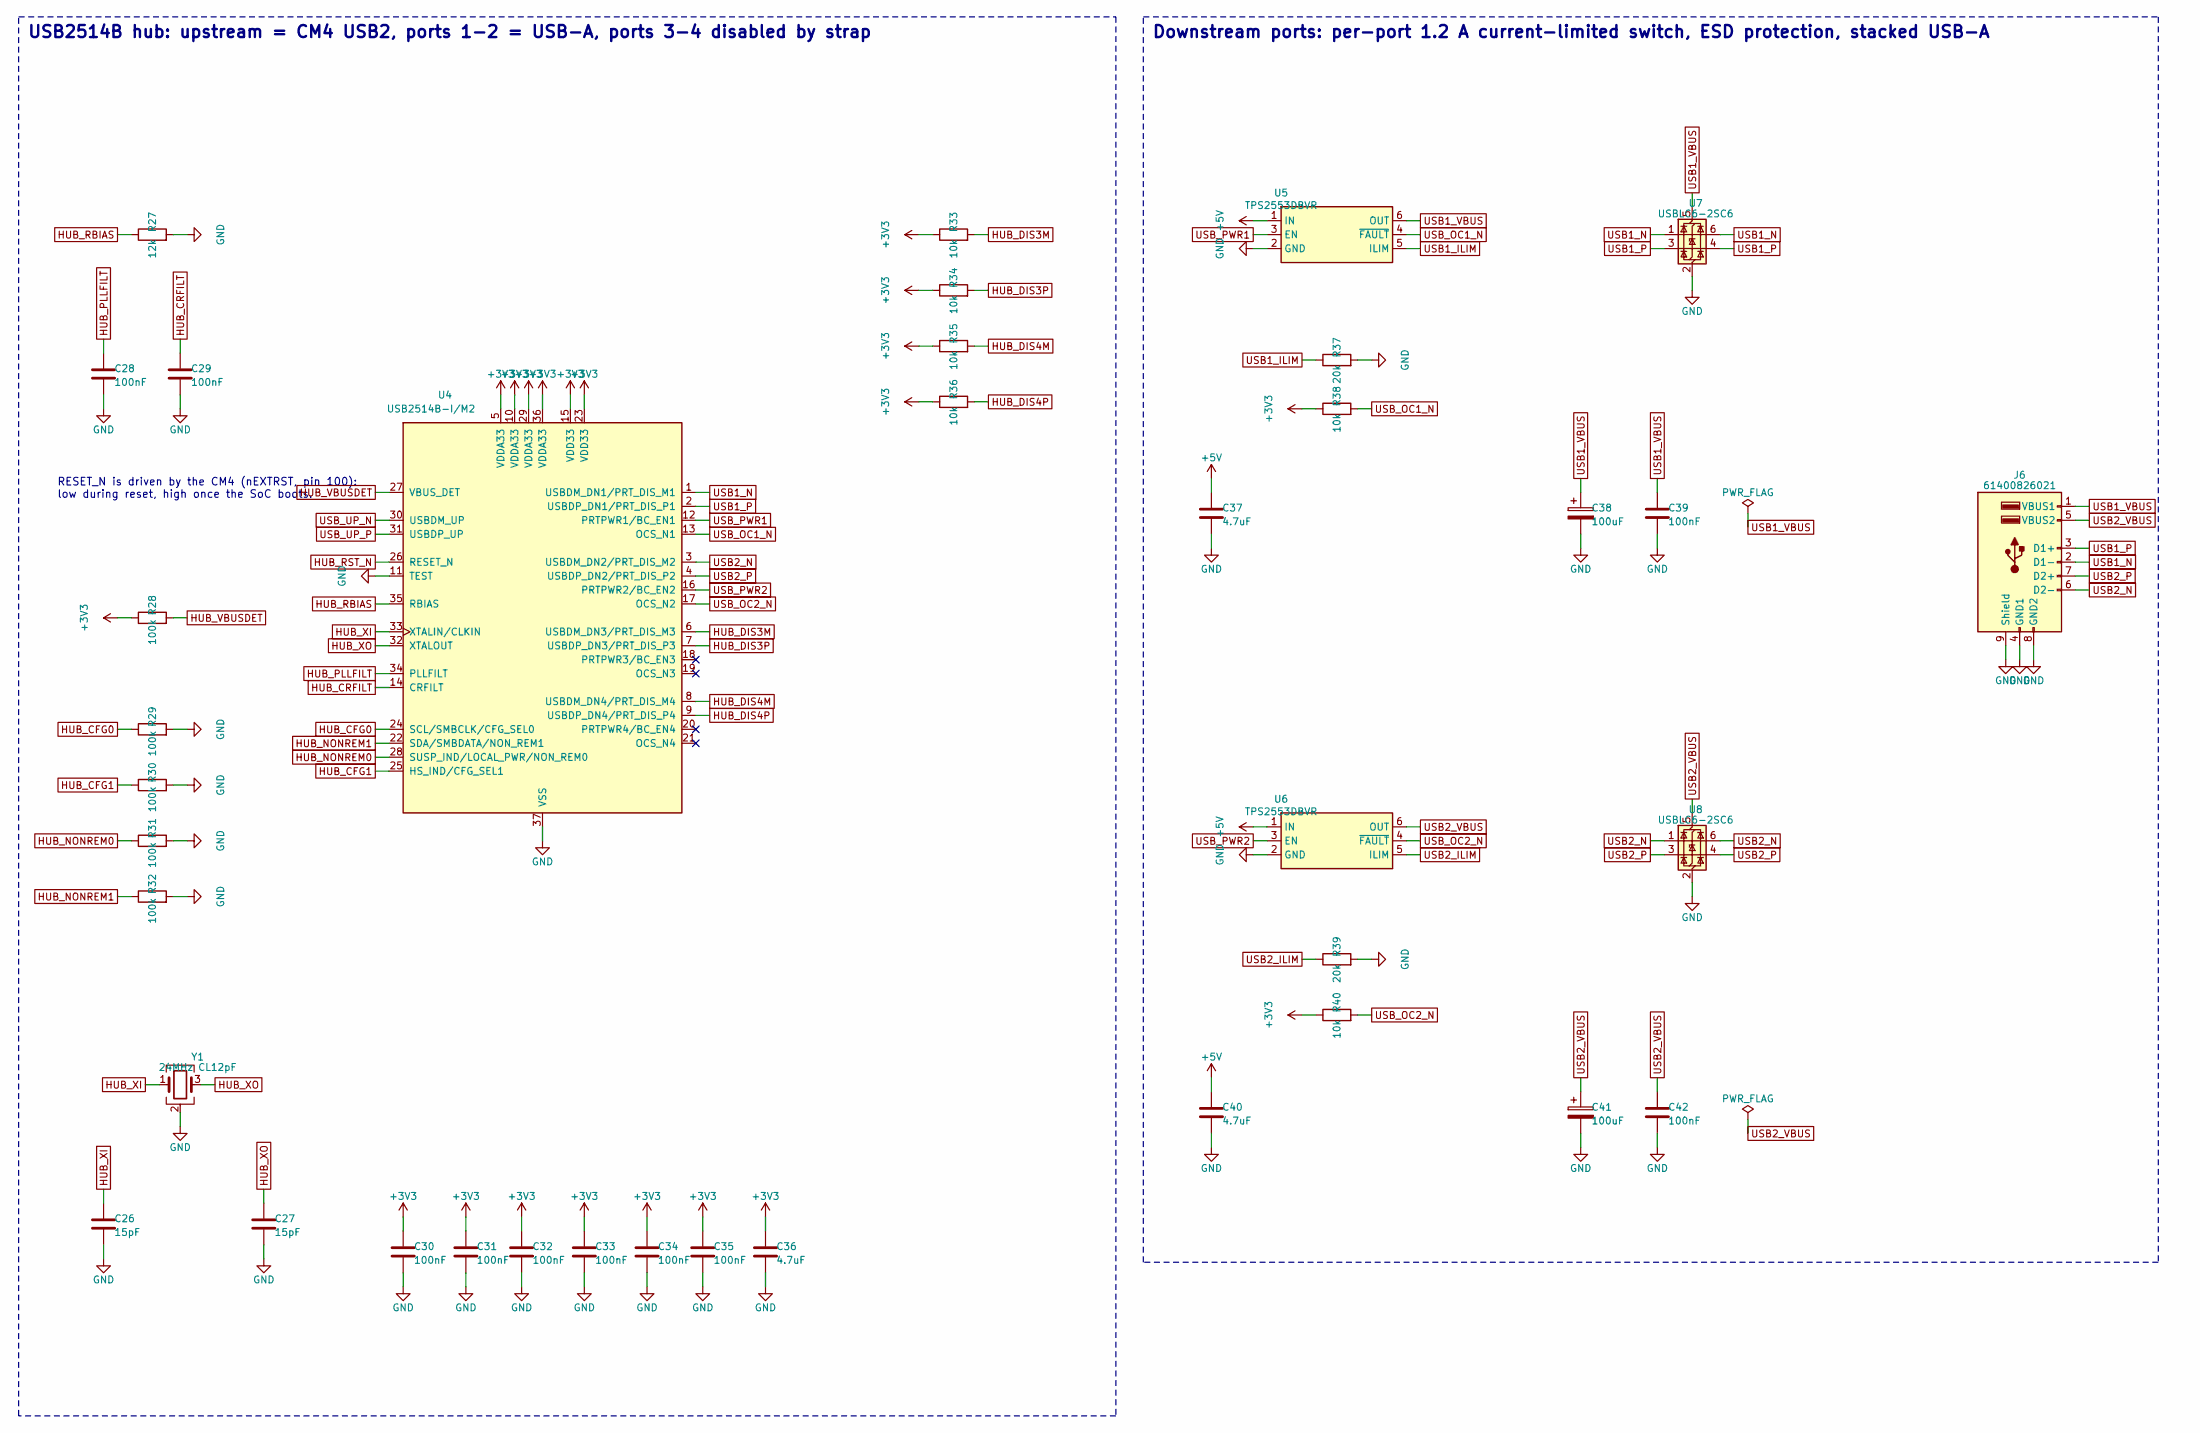
[picture p39: schematic usb.kicad_sch, USB 2.0 hub and USB-A host ports]

Parts:
C26, C27: 15pF; C_0402_1005Metric; MPN 0402CG150J500NT
C28, C29, C30, C31, C32, C33, C34, C35, C39, C42: 100nF; C_0402_1005Metric; MPN CL05B104KO5NNNC
C36, C37, C40: 4.7uF; C_0603_1608Metric; MPN CL10A475KA8NQNC
C38, C41: 100uF; CP_EIA-3528-21_Kemet-B; MPN T520B107M006ATE040
J6: 61400826021; USB_A_Wuerth_61400826021_Horizontal_Stacked; MPN 61400826021
R27: 12k; R_0402_1005Metric; MPN 0402WGF1202TCE
R28, R29, R30, R31, R32: 100k; R_0402_1005Metric; MPN 0402WGF1003TCE
R33, R34, R35, R36, R38, R40: 10k; R_0402_1005Metric; MPN 0402WGF1002TCE
R37, R39: 20k; R_0402_1005Metric; MPN 0402WGF2002TCE
U4: USB2514B-I/M2; QFN-36-1EP_6x6mm_P0.5mm_EP3.7x3.7mm; MPN USB2514B-I/M2
U5, U6: TPS2553DBVR; SOT-23-6; MPN TPS2553DBVR
U7, U8: USBLC6-2SC6; SOT-23-6; MPN USBLC6-2SC6
Y1: 24MHz CL12pF; Crystal_SMD_3225-4Pin_3.2x2.5mm; MPN X322524MOB4SI

Connections:
+3V3: C30.1, C31.1, C32.1, C33.1, C34.1, C35.1, C36.1, R28.1, R33.1, R34.1, R35.1, R36.1, R38.1, R40.1, U4.5 (VDDA33), U4.10 (VDDA33), U4.15 (VDD33), U4.23 (VDD33), U4.29 (VDDA33), U4.36 (VDDA33); also elsewhere on the board
+5V: C37.1, C40.1, U5.1 (IN), U6.1 (IN); also elsewhere on the board
GND: C26.2, C27.2, C28.2, C29.2, C30.2, C31.2, C32.2, C33.2, C34.2, C35.2, C36.2, C37.2, C38.2, C39.2, C40.2, C41.2, C42.2, J6.4 (GND1), J6.8 (GND2), J6.9 (Shield), R27.2, R29.2, R30.2, R31.2, R32.2, R37.2, R39.2, U4.11 (TEST), U4.37 (VSS), U5.2 (GND), U6.2 (GND), U7.2 (GND), U8.2 (GND), Y1.2 (G), Y1.4 (G); also elsewhere on the board
HUB_CFG0: R29.1, U4.24 (SCL/SMBCLK/CFG_SEL0)
HUB_CFG1: R30.1, U4.25 (HS_IND/CFG_SEL1)
HUB_CRFILT: C29.1, U4.14 (CRFILT)
HUB_DIS3M: R33.2, U4.6 (USBDM_DN3/PRT_DIS_M3)
HUB_DIS3P: R34.2, U4.7 (USBDP_DN3/PRT_DIS_P3)
HUB_DIS4M: R35.2, U4.8 (USBDM_DN4/PRT_DIS_M4)
HUB_DIS4P: R36.2, U4.9 (USBDP_DN4/PRT_DIS_P4)
HUB_NONREM0: R31.1, U4.28 (SUSP_IND/LOCAL_PWR/NON_REM0)
HUB_NONREM1: R32.1, U4.22 (SDA/SMBDATA/NON_REM1)
HUB_PLLFILT: C28.1, U4.34 (PLLFILT)
HUB_RBIAS: R27.1, U4.35 (RBIAS)
HUB_RST_N: U4.26 (RESET_N); also elsewhere on the board
HUB_VBUSDET: R28.2, U4.27 (VBUS_DET)
HUB_XI: C26.1, U4.33 (XTALIN/CLKIN), Y1.1
HUB_XO: C27.1, U4.32 (XTALOUT), Y1.3
USB1_ILIM: R37.1, U5.5 (ILIM)
USB1_N: J6.2 (D1-), U4.1 (USBDM_DN1/PRT_DIS_M1), U7.1 (I/O1), U7.6 (I/O1)
USB1_P: J6.3 (D1+), U4.2 (USBDP_DN1/PRT_DIS_P1), U7.3 (I/O2), U7.4 (I/O2)
USB1_VBUS: C38.1, C39.1, J6.1 (VBUS1), U5.6 (OUT), U7.5 (VBUS)
USB2_ILIM: R39.1, U6.5 (ILIM)
USB2_N: J6.6 (D2-), U4.3 (USBDM_DN2/PRT_DIS_M2), U8.1 (I/O1), U8.6 (I/O1)
USB2_P: J6.7 (D2+), U4.4 (USBDP_DN2/PRT_DIS_P2), U8.3 (I/O2), U8.4 (I/O2)
USB2_VBUS: C41.1, C42.1, J6.5 (VBUS2), U6.6 (OUT), U8.5 (VBUS)
USB_OC1_N: R38.2, U4.13 (OCS_N1), U5.4 (~FAULT)
USB_OC2_N: R40.2, U4.17 (OCS_N2), U6.4 (~FAULT)
USB_PWR1: U4.12 (PRTPWR1/BC_EN1), U5.3 (EN)
USB_PWR2: U4.16 (PRTPWR2/BC_EN2), U6.3 (EN)
USB_UP_N: U4.30 (USBDM_UP); also elsewhere on the board
USB_UP_P: U4.31 (USBDP_UP); also elsewhere on the board

Notes on the sheet:
USB2514B hub: upstream = CM4 USB2, ports 1-2 = USB-A, ports 3-4 disabled by strap
RESET_N is driven by the CM4 (nEXTRST, pin 100): low during reset, high once the SoC boots.
Downstream ports: per-port 1.2 A current-limited switch, ESD protection, stacked USB-A
