geilevideossos-gamedev/fable-sbc-test/hardware/voxhub.kicad_pcb

## KiCad design hardware/voxhub.kicad_pcb (continued)

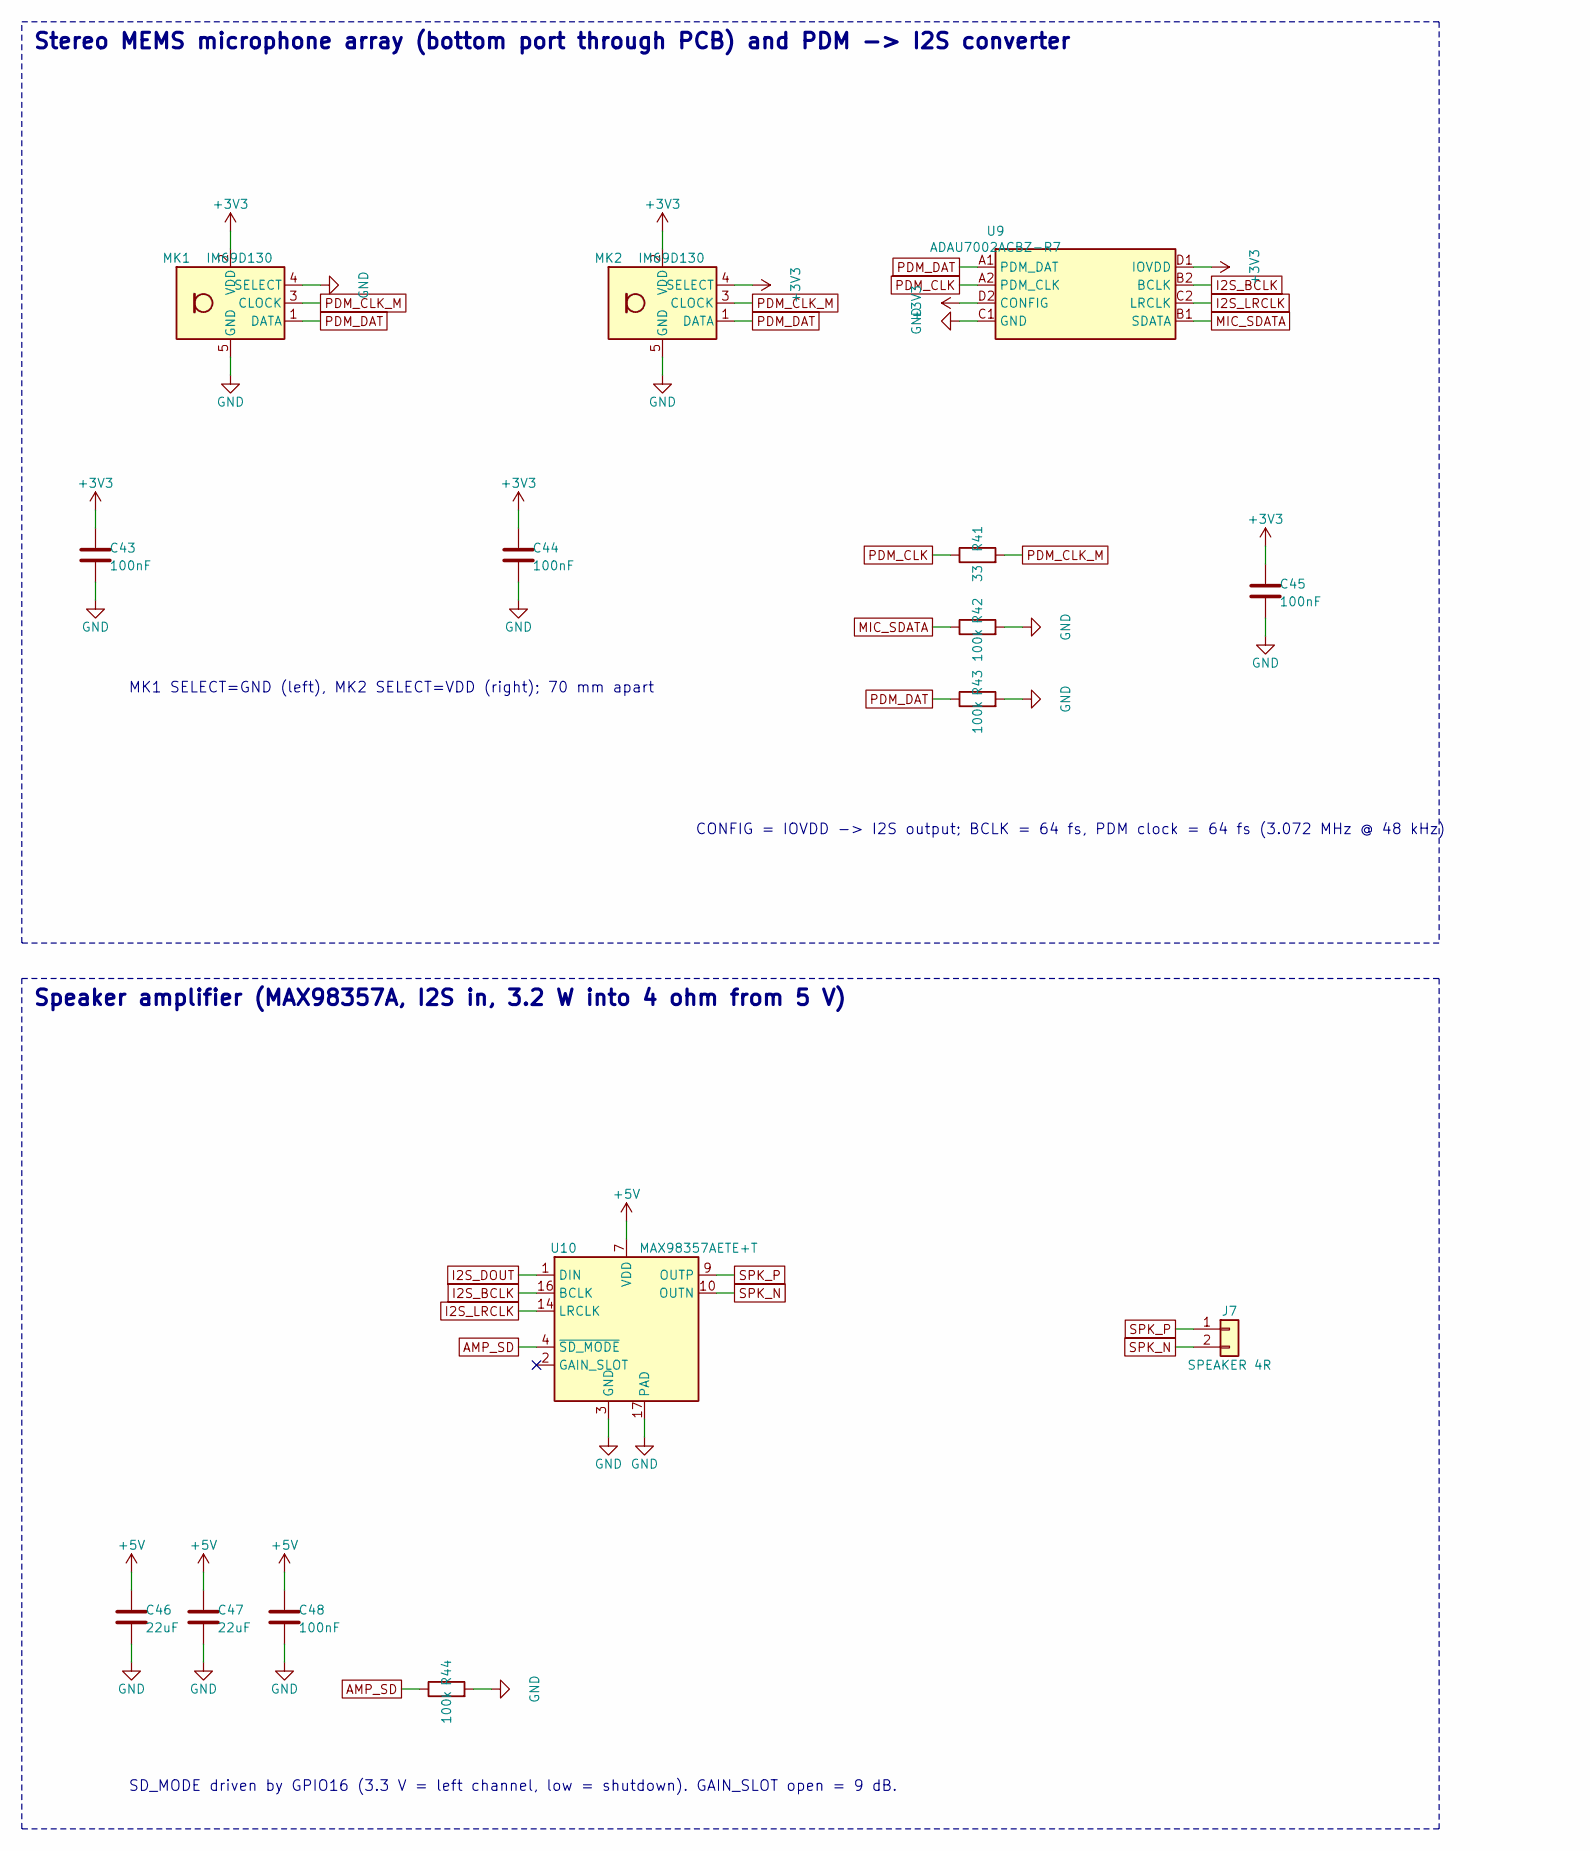
[picture p40: schematic audio.kicad_sch, Audio: PDM microphones, PDM-to-I2S, class-D speaker amplifi…]

Parts:
C43, C44, C45, C48: 100nF; C_0402_1005Metric; MPN CL05B104KO5NNNC
C46, C47: 22uF; C_1206_3216Metric; MPN CL31A226KAHNNNE
J7: SPEAKER 4R; JST_PH_B2B-PH-K_1x02_P2.00mm_Vertical; MPN B2B-PH-K-S(LF)(SN)
MK1, MK2: IM69D130; Infineon_PG-LLGA-5-1; MPN IM69D130V01XTSA1
R41: 33; R_0402_1005Metric; MPN 0402WGF330JTCE
R42, R43, R44: 100k; R_0402_1005Metric; MPN 0402WGF1003TCE
U9: ADAU7002ACBZ-R7; ADAU7002_WLCSP-8_0.76x1.56mm_P0.4mm; MPN ADAU7002ACBZ-R7
U10: MAX98357AETE+T; TQFN-16-1EP_3x3mm_P0.5mm_EP1.23x1.23mm; MPN MAX98357AETE+T

Connections:
+3V3: C43.1, C44.1, C45.1, MK1.2 (VDD), MK2.2 (VDD), MK2.4 (SELECT), U9.D1 (IOVDD), U9.D2 (CONFIG); also elsewhere on the board
+5V: C46.1, C47.1, C48.1, U10.7 (VDD), U10.8 (VDD); also elsewhere on the board
AMP_SD: R44.1, U10.4 (~SD_MODE); also elsewhere on the board
GND: C43.2, C44.2, C45.2, C46.2, C47.2, C48.2, MK1.4 (SELECT), MK1.5 (GND), MK2.5 (GND), R42.2, R43.2, R44.2, U9.C1 (GND), U10.3 (GND), U10.11 (GND), U10.15 (GND), U10.17 (PAD); also elsewhere on the board
I2S_BCLK: U9.B2 (BCLK), U10.16 (BCLK); also elsewhere on the board
I2S_DOUT: U10.1 (DIN); also elsewhere on the board
I2S_LRCLK: U9.C2 (LRCLK), U10.14 (LRCLK); also elsewhere on the board
MIC_SDATA: R42.1, U9.B1 (SDATA); also elsewhere on the board
PDM_CLK: R41.1, U9.A2 (PDM_CLK)
PDM_CLK_M: MK1.3 (CLOCK), MK2.3 (CLOCK), R41.2
PDM_DAT: MK1.1 (DATA), MK2.1 (DATA), R43.1, U9.A1 (PDM_DAT)
SPK_N: J7.2, U10.10 (OUTN)
SPK_P: J7.1, U10.9 (OUTP)

Notes on the sheet:
Stereo MEMS microphone array (bottom port through PCB) and PDM -> I2S converter
MK1 SELECT=GND (left), MK2 SELECT=VDD (right); 70 mm apart
CONFIG = IOVDD -> I2S output; BCLK = 64 fs, PDM clock = 64 fs (3.072 MHz @ 48 kHz)
Speaker amplifier (MAX98357A, I2S in, 3.2 W into 4 ohm from 5 V)
SD_MODE driven by GPIO16 (3.3 V = left channel, low = shutdown). GAIN_SLOT open = 9 dB.

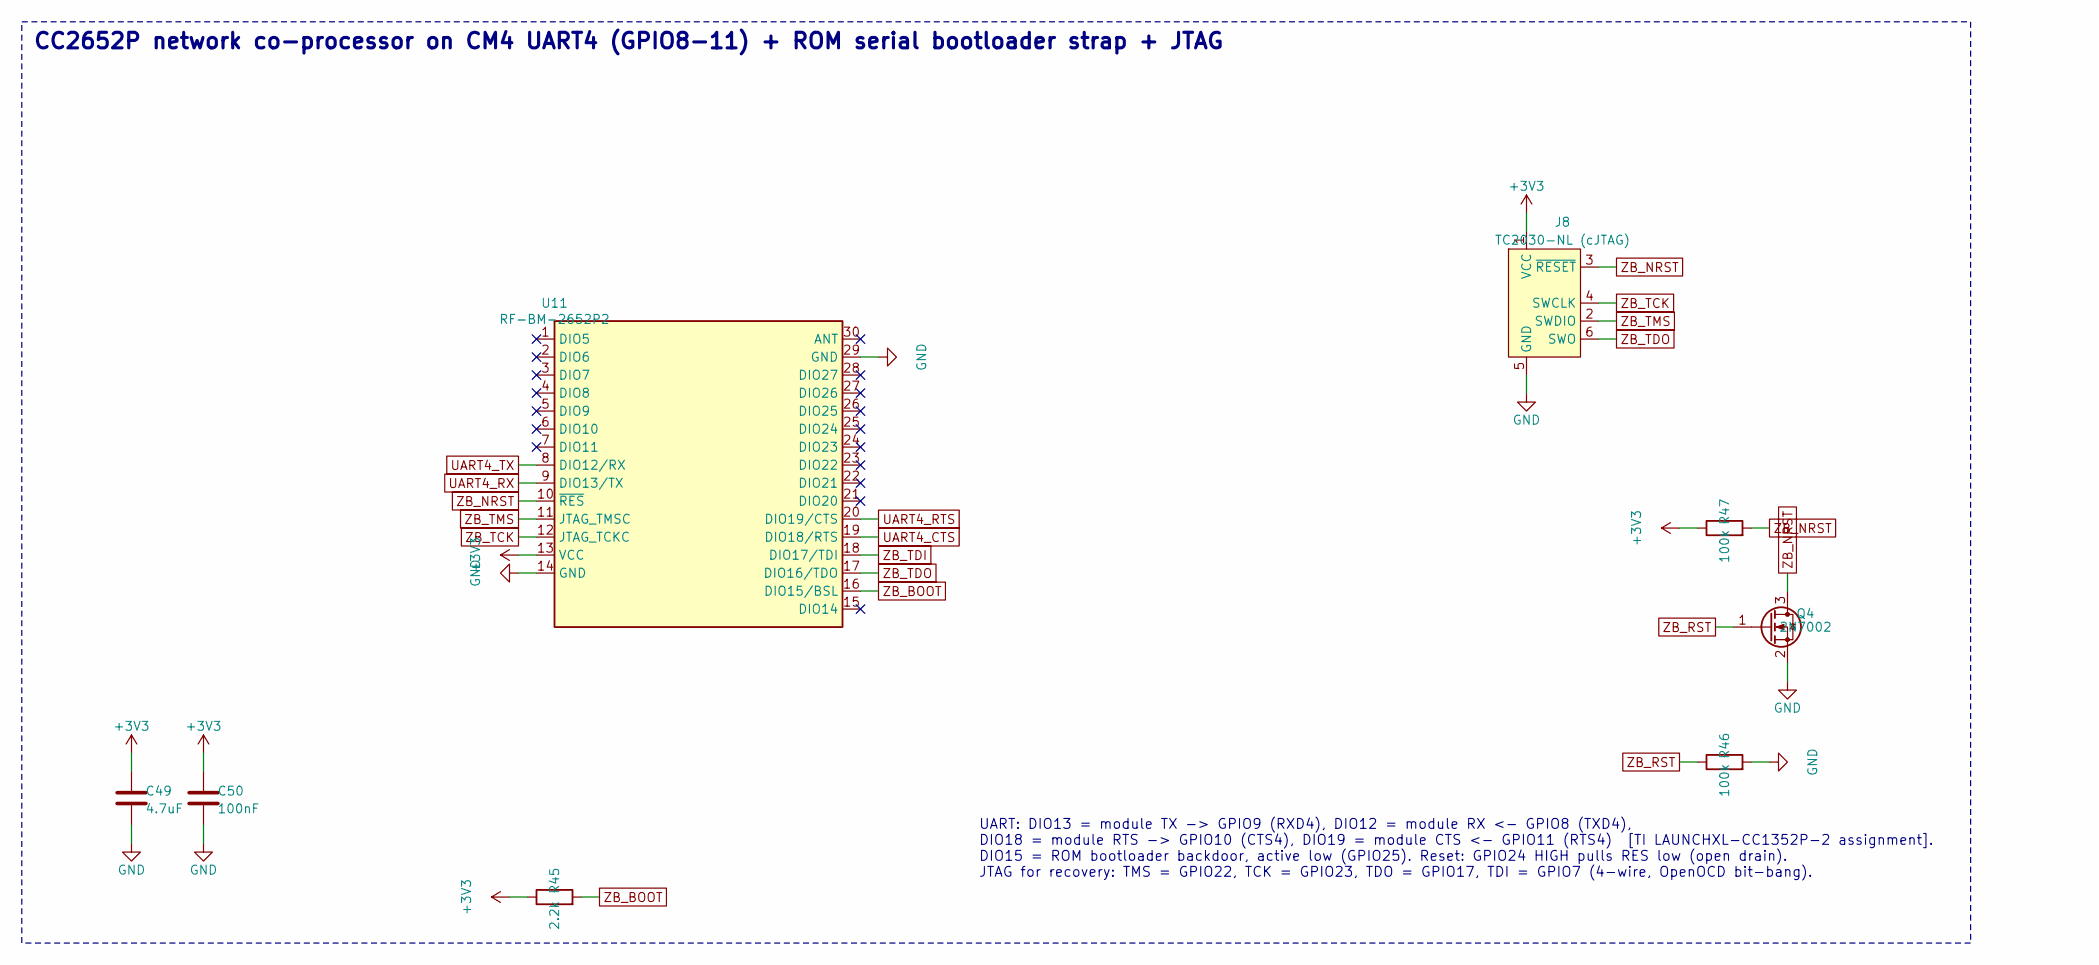
[picture p41: schematic zigbee.kicad_sch, Zigbee / Thread radio (RF-BM-2652P2, CC2652P)]

Parts:
C49: 4.7uF; C_0603_1608Metric; MPN CL10A475KA8NQNC
C50: 100nF; C_0402_1005Metric; MPN CL05B104KO5NNNC
J8: TC2030-NL (cJTAG); Tag-Connect_TC2030-IDC-NL_2x03_P1.27mm_Vertical; PartDescription Tag-Connect footprint (no part)
Q4: 2N7002; SOT-23; MPN 2N7002,215
R45: 2.2k; R_0402_1005Metric; MPN 0402WGF2201TCE
R46, R47: 100k; R_0402_1005Metric; MPN 0402WGF1003TCE
U11: RF-BM-2652P2; RFstar_RF-BM-2652P2; MPN RF-BM-2652P2

Connections:
+3V3: C49.1, C50.1, J8.1 (VCC), R45.1, R47.1, U11.13 (VCC); also elsewhere on the board
GND: C49.2, C50.2, J8.5 (GND), Q4.2 (S), R46.2, U11.14 (GND), U11.29 (GND); also elsewhere on the board
UART4_CTS: U11.19 (DIO18/RTS); also elsewhere on the board
UART4_RTS: U11.20 (DIO19/CTS); also elsewhere on the board
UART4_RX: U11.9 (DIO13/TX); also elsewhere on the board
UART4_TX: U11.8 (DIO12/RX); also elsewhere on the board
ZB_BOOT: R45.2, U11.16 (DIO15/BSL); also elsewhere on the board
ZB_NRST: J8.3 (~RESET), Q4.3 (D), R47.2, U11.10 (~RES)
ZB_RST: Q4.1 (G), R46.1; also elsewhere on the board
ZB_TCK: J8.4 (SWCLK), U11.12 (JTAG_TCKC); also elsewhere on the board
ZB_TDI: U11.18 (DIO17/TDI); also elsewhere on the board
ZB_TDO: J8.6 (SWO), U11.17 (DIO16/TDO); also elsewhere on the board
ZB_TMS: J8.2 (SWDIO), U11.11 (JTAG_TMSC); also elsewhere on the board

Notes on the sheet:
CC2652P network co-processor on CM4 UART4 (GPIO8-11) + ROM serial bootloader strap + JTAG
UART: DIO13 = module TX -> GPIO9 (RXD4), DIO12 = module RX <- GPIO8 (TXD4), DIO18 = module RTS -> GPIO10 (CTS4), DIO19 = module CTS <- GPIO11 (RTS4) [TI LAUNCHXL-CC1352P-2 assignment]. DIO15 = ROM bootloader backdoor, active low (GPIO25). Reset: GPIO24 HIGH pulls RES low (open drain). JTAG for reco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

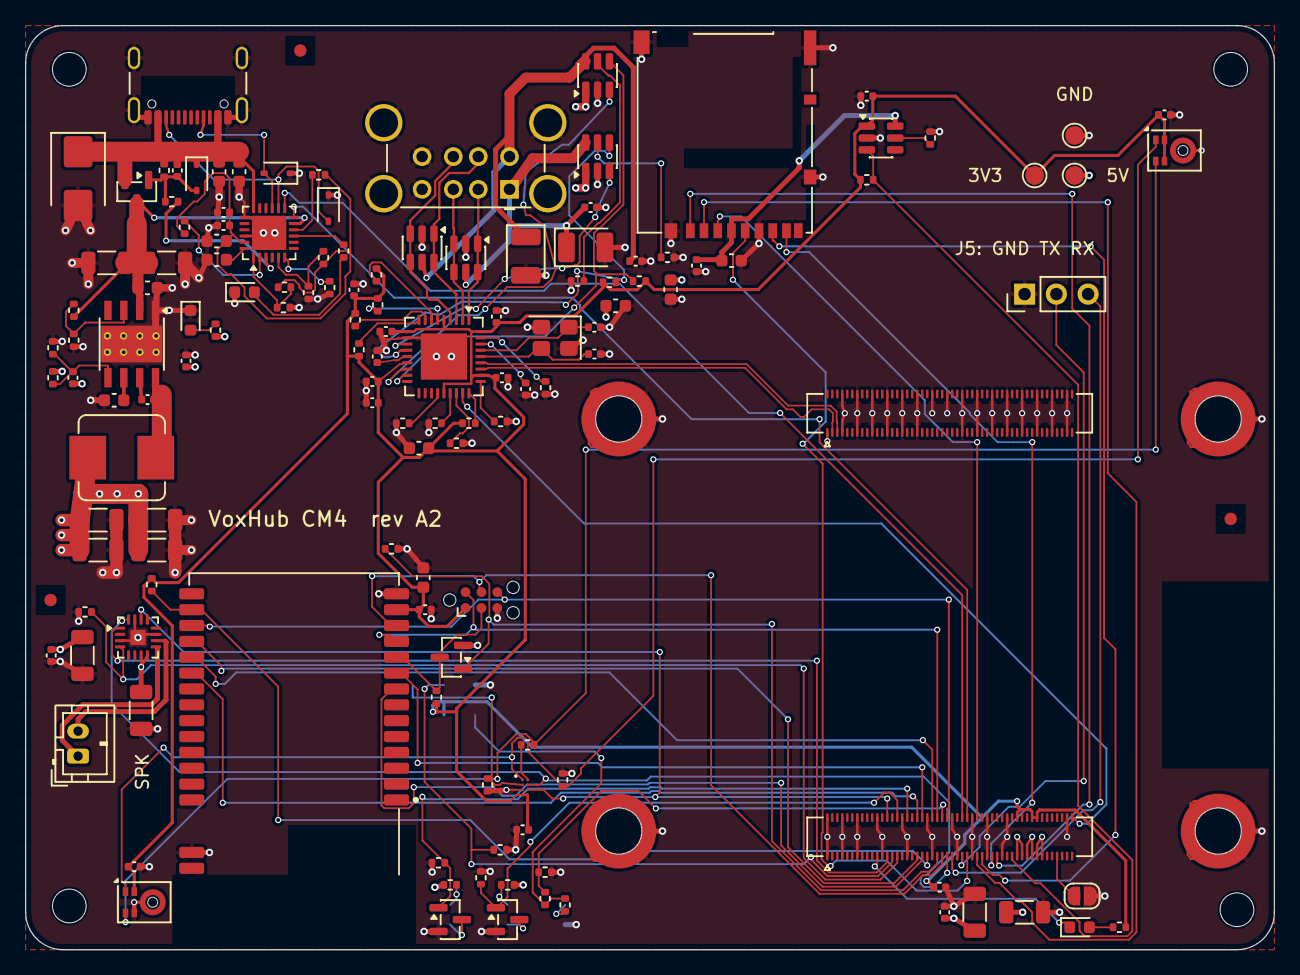
[picture p42: board voxhub.kicad_pcb from above]

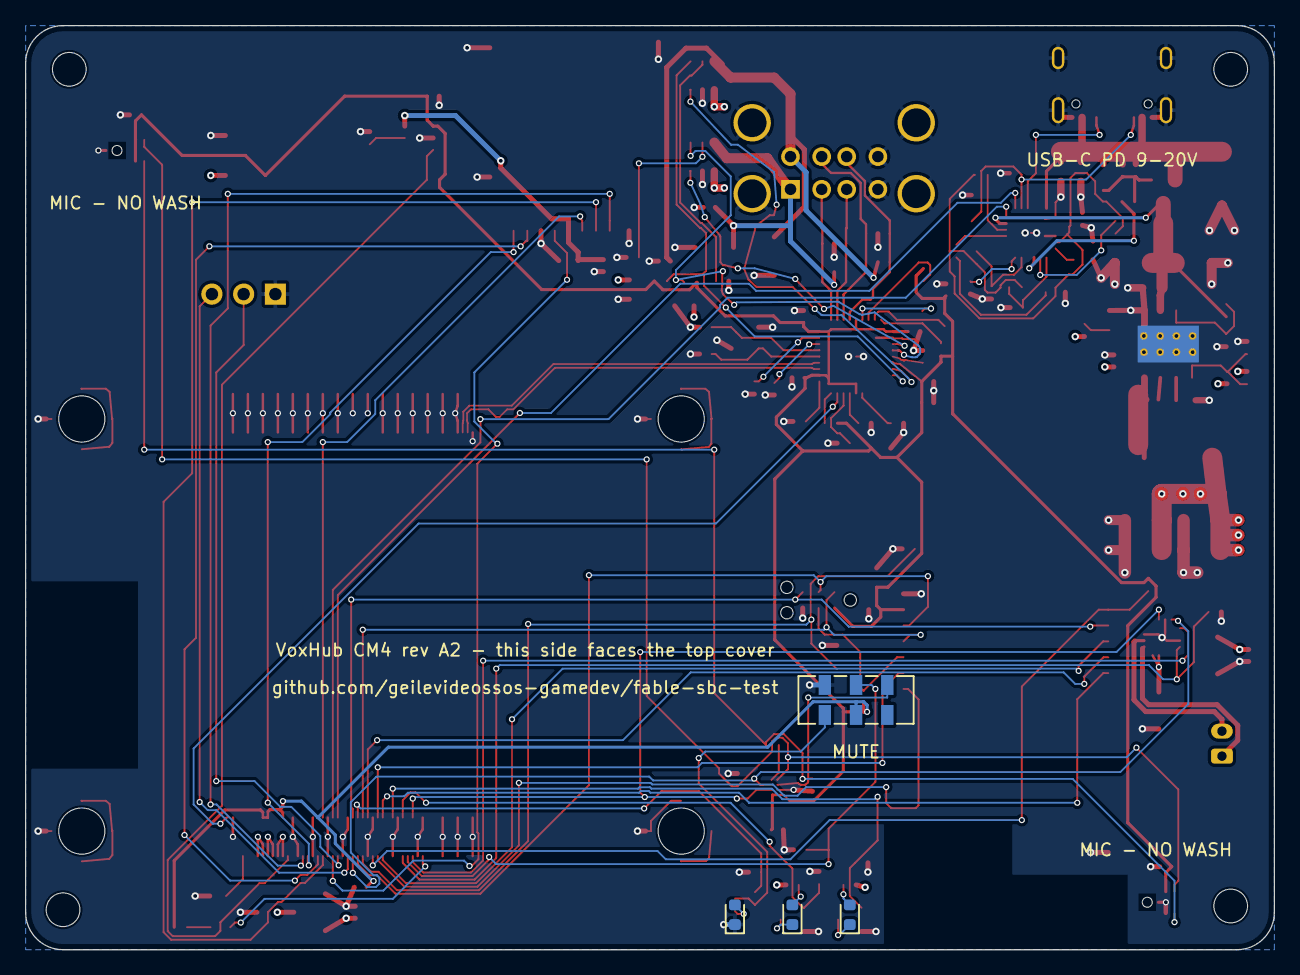
[picture p43: board voxhub.kicad_pcb from below]

Board: 4 copper layers, 100.0 x 74.0 mm, 150 parts (4 on the bottom side), 100 nets.
