geilevideossos-gamedev/fable-sbc-test/hardware/gen/build_pcb.py

#!/usr/bin/env python3
"""Build voxhub.kicad_pcb from the schematic netlist (run inside KiCad's python).

  build_pcb.py place   <netlist> <outdir>   -> placed, unrouted board + voxhub.dsn
  build_pcb.py finish  <outdir>             -> imports voxhub.ses, pours zones, saves

Placement = a table of fixed positions (connectors, ICs, mechanics) plus a greedy
"nearest free spot to the pad it talks to" placer for the small parts.
"""
import sys, os, json, math
sys.path.insert(0, os.path.dirname(os.path.abspath(__file__)))
import pcbnew
from sexpr import parse, find, first
import prewire

MM = pcbnew.FromMM
W, H = 100.0, 74.0            # board size
OX, OY = 100.0, 60.0          # board origin on the KiCad page
SYS_FP = "/usr/share/kicad/footprints"
POWER = ("GND", "+5V", "+3V3")
VIA_DRILL = 0.3

# ref -> (x, y, rot, side)  [board coordinates, mm, origin = rear-left corner, F.Cu view]
CM4_X0, CM4_Y0 = 95.5, 64.5   # CM4 mounting hole nearest front-right; module spans x 44..99, y 28..68
FIXED = {
    "J1": (13.0, 3.67, 180, "F"),      # USB-C PD input (rear edge)
    "J6": (38.75, 13.11, 180, "F"),    # stacked USB-A (rear edge)
    "J4": (56.0, 8.7, 180, "F"),       # microSD (rear edge; shield pads end 0.37 mm inside the edge)
    "U1": (19.5, 16.6, 90, "F"),
    "Q1": (8.9, 13.3, 270, "F"), "D1": (4.2, 12.25, 270, "F"),
    "R9": (11.1, 11.6, 270, "F"), "C7": (12.15, 11.6, 270, "F"), "D5": (13.7, 12.15, 270, "F"), "R10": (11.7, 14.1, 0, "F"),
    "C2": (15.5, 11.7, 270, "F"), "C1": (17.1, 11.7, 270, "F"),
    "C3": (15.3, 17.25, 180, "F"), "C5": (15.3, 18.75, 180, "F"), "C4": (15.85, 16.0, 180, "F"), "C6": (15.85, 14.96, 180, "F"),
    "U2": (8.5, 25.5, 270, "F"), "L1": (7.7, 34.6, 180, "F"),
    "C10": (9.77, 21.0, 0, "F"), "C8": (6.5, 19.0, 180, "F"), "C9": (11.3, 19.0, 0, "F"),
    "C12": (9.77, 29.95, 0, "F"), "C11": (7.09, 30.0, 180, "F"),
    "C14": (5.8, 39.6, 0, "F"), "C15": (10.5, 39.6, 0, "F"), "C16": (5.8, 42.0, 0, "F"), "C17": (10.5, 42.0, 0, "F"),
    # USB ESD parts (USBLC6-2SC6) between hub and connector, turned by 270 degrees: one pad row (4, 5, 6) faces the hub,
    # the other (3, 2, 1) the connector, D+ on the left and D- on the right in both rows - the same order as the hub
    # pins (x 34.0 .. 35.5: port 2 D+, D-, port 1 D+, D-) and the connector pins.  Port 2 (U8) left, port 1 (U7) right:
    # every line runs straight through its ESD part and no line has to cross another one.
    "U4": (33.5, 26.5, 270, "F"), "U7": (35.25, 18.6, 270, "F"), "U8": (31.75, 17.8, 270, "F"),
    "Y1": (42.4, 25.0, 180, "F"), "C26": (45.55, 24.15, 0, "F"), "C27": (45.55, 26.3, 0, "F"),
    "C30": (28.85, 24.5, 180, "F"), "C34": (38.15, 28.2, 0, "F"), "C35": (37.7, 23.3, 90, "F"),
    "C50": (32.0, 46.77, 0, "F"), "C49": (31.85, 44.2, 90, "F"), "U5": (45.8, 10.5, 90, "F"), "U6": (45.8, 4.0, 90, "F"),
    "U3": (68.5, 9.0, 0, "F"),
    "J2": (74.0, 64.96, 0, "F"), "J3": (74.0, 31.04, 0, "F"),
    "H5": (95.5, 64.5, 0, "F"), "H6": (95.5, 31.5, 0, "F"), "H7": (47.5, 64.5, 0, "F"), "H8": (47.5, 31.5, 0, "F"),
    "H1": (3.5, 3.5, 0, "F"), "H2": (96.5, 3.5, 0, "F"), "H3": (3.5, 70.5, 0, "F"), "H4": (97.0, 70.8, 0, "F"),
    "U9": (40.0, 61.0, 0, "F"), "MK1": (9.5, 70.2, 0, "F"), "MK2": (92.0, 10.0, 0, "F"),
    "U10": (9.0, 49.0, 0, "F"), "J7": (4.2, 58.5, 90, "F"),
    "U11": (21.5, 59.0, 180, "F"), "J8": (36.5, 46.0, 0, "F"),
    "SW1": (33.5, 54.0, 0, "B"),
    "J5": (80.0, 21.5, 90, "F"),
    "FID1": (22.0, 2.0, 0, "F"), "FID2": (96.5, 39.5, 0, "F"), "FID3": (2.0, 46.0, 0, "F"),
}
ANCHOR_PTS = {"TPZONE": (84.0, 12.0), "UI": (38.0, 66.0), "CM4CAP": (80.0, 71.0)}
# keep-out rectangles for the automatic placer (x1, y1, x2, y2)
ZB_ANT_KO = (11.75, 68.0, 31.25, 74.0)
ZB_ANT_KO2 = (21.0, 64.0, 31.25, 68.0)
NOGO_F = [(43.6, 27.6, 99.4, 68.4),          # under the CM4 module
          ZB_ANT_KO, ZB_ANT_KO2]
HOLES = [(3.5, 3.5), (96.5, 3.5), (3.5, 70.5), (97.0, 70.8)]

SILK_MIN_W = 0.15
CORNER_R = 3.0

def trim_silk(board):
    f = pcbnew.ToMM
    n = nw = 0
    for fp in sorted_fps(board):
        for g in list(fp.GraphicalItems()):
            if g.GetLayer() not in (pcbnew.F_SilkS, pcbnew.B_SilkS):
                continue
            b = g.GetBoundingBox()
            if f(b.GetLeft()) - OX < 0.3 or f(b.GetTop()) - OY < 0.3 or f(b.GetRight()) - OX > W - 0.3 or f(b.GetBottom()) - OY > H - 0.3:
                fp.Remove(g); _KEEP.append(g); n += 1
            elif 0 < g.GetWidth() < MM(SILK_MIN_W):
                g.SetWidth(MM(SILK_MIN_W)); nw += 1
        if fp.IsDNP():
            for pad in fp.Pads():
                ls = pad.GetLayerSet(); ls.RemoveLayer(pcbnew.F_Paste); ls.RemoveLayer(pcbnew.B_Paste); pad.SetLayerSet(ls)
    print("silkscreen items cut off at the board edge: %d, widened to %.2f mm: %d" % (n, SILK_MIN_W, nw))

class Legends:
    STEP = 0.25

    def __init__(self, board, pre):
        import numpy as np
        f = pcbnew.ToMM
        self.np = np
        self.board = board
        self.nx, self.ny = int(W / self.STEP) + 1, int(H / self.STEP) + 1
        self.occ = {pcbnew.F_SilkS: np.zeros((self.nx, self.ny), bool), pcbnew.B_SilkS: np.zeros((self.nx, self.ny), bool)}
        for fp in sorted_fps(board):
            front = not fp.IsFlipped()
            for p in fp.Pads():
                b = p.GetBoundingBox()
                bb = (f(b.GetLeft()) - OX, f(b.GetTop()) - OY, f(b.GetRight()) - OX, f(b.GetBottom()) - OY)
                th = p.GetAttribute() in (pcbnew.PAD_ATTRIB_PTH, pcbnew.PAD_ATTRIB_NPTH)
                for lay, cu in ((pcbnew.F_SilkS, pcbnew.F_Cu), (pcbnew.B_SilkS, pcbnew.B_Cu)):
                    if th or p.IsOnLayer(cu):
                        self.block(lay, bb, 0.5)
            bb = crt_bbox(fp)
            self.block(pcbnew.F_SilkS if front else pcbnew.B_SilkS, bb, 0.3)
            for g in fp.GraphicalItems():
                if g.GetLayer() in self.occ:
                    b = g.GetBoundingBox()
                    self.block(g.GetLayer(), (f(b.GetLeft()) - OX, f(b.GetTop()) - OY, f(b.GetRight()) - OX, f(b.GetBottom()) - OY), 0.3)
        for k in board_keepouts(board):
            self.block(pcbnew.F_SilkS, k[:4], 0.2); self.block(pcbnew.B_SilkS, k[:4], 0.2)
        for net, x, y, dia in pre["vias"]:
            self.block(pcbnew.F_SilkS, (x, y, x, y), dia / 2 + 0.2); self.block(pcbnew.B_SilkS, (x, y, x, y), dia / 2 + 0.2)
        for lay in self.occ:
            self.block(lay, (0, 0, W, 1.0), 0); self.block(lay, (0, H - 1.0, W, H), 0)
            self.block(lay, (0, 0, 1.0, H), 0); self.block(lay, (W - 1.0, 0, W, H), 0)

    def block(self, lay, bb, m):
        i0, i1 = max(0, int((bb[0] - m) / self.STEP)), min(self.nx, int(math.ceil((bb[2] + m) / self.STEP)) + 1)
        j0, j1 = max(0, int((bb[1] - m) / self.STEP)), min(self.ny, int(math.ceil((bb[3] + m) / self.STEP)) + 1)
        if i1 > i0 and j1 > j0:
            self.occ[lay][i0:i1, j0:j1] = True

    def put(self, s, layer, size, want, rots=(0,), reach=40.0):
        tx = pcbnew.PCB_TEXT(self.board); tx.SetText(s); tx.SetLayer(layer)
        tx.SetTextSize(pcbnew.VECTOR2I(MM(size), MM(size))); tx.SetTextThickness(MM(size * 0.15))
        if layer == pcbnew.B_SilkS: tx.SetMirrored(True)
        best = None
        for rot in rots:
            tx.SetTextAngle(pcbnew.EDA_ANGLE(rot, pcbnew.DEGREES_T)); tx.SetPosition(P(0, 0))
            b = tx.GetBoundingBox()
            x0, y0, x1, y1 = (pcbnew.ToMM(v) for v in (b.GetLeft(), b.GetTop(), b.GetRight(), b.GetBottom()))
            dx0, dy0, dx1, dy1 = x0 - OX, y0 - OY, x1 - OX, y1 - OY
            n = int(reach / self.STEP)
            offs = sorted(((i * self.STEP, j * self.STEP) for i in range(-n, n + 1) for j in range(-n, n + 1)), key=lambda o: (o[0] ** 2 + (2.0 * o[1]) ** 2, o))
            for ox, oy in offs:
                x, y = want[0] + ox, want[1] + oy
                bb = (x + dx0, y + dy0, x + dx1, y + dy1)
                if bb[0] < 1.2 or bb[1] < 1.2 or bb[2] > W - 1.2 or bb[3] > H - 1.2:
                    continue
                i0, i1 = int((bb[0] - 0.2) / self.STEP), int(math.ceil((bb[2] + 0.2) / self.STEP)) + 1
                j0, j1 = int((bb[1] - 0.2) / self.STEP), int(math.ceil((bb[3] + 0.2) / self.STEP)) + 1
                if not self.occ[layer][i0:i1, j0:j1].any():
                    d = math.hypot(ox, 2.0 * oy)
                    if best is None or d < best[0]:
                        best = (d, rot, x, y, bb)
                    break
        if best is None:
            raise RuntimeError("no free place for the legend '%s'" % s)
        _, rot, x, y, bb = best
        tx.SetTextAngle(pcbnew.EDA_ANGLE(rot, pcbnew.DEGREES_T)); tx.SetPosition(P(x, y))
        self.board.Add(tx)
        self.block(layer, bb, 0.3)
        print("legend %-52s at %6.2f %6.2f rot %d (wanted %.1f %.1f)" % (repr(s), x, y, rot, want[0], want[1]))

STACKUP = prewire.STACKUP

def write_stackup(path):
    pp, co = STACKUP["prepreg"], STACKUP["core"]
    rows = [('"F.SilkS"', '(type "Top Silk Screen")'), ('"F.Paste"', '(type "Top Solder Paste")'),
            ('"F.Mask"', '(type "Top Solder Mask") (thickness %g)' % STACKUP["mask"]),
            ('"F.Cu"', '(type "copper") (thickness %g)' % STACKUP["outer_cu"]),
            ('"dielectric 1"', '(type "prepreg") (thickness %g) (material "%s") (epsilon_r %g) (loss_tangent 0.02)' % (pp[1], pp[0], pp[2])),
            ('"In1.Cu"', '(type "copper") (thickness %g)' % STACKUP["inner_cu"]),
            ('"dielectric 2"', '(type "core") (thickness %g) (material "%s") (epsilon_r %g) (loss_tangent 0.02)' % (co[1], co[0], co[2])),
            ('"In2.Cu"', '(type "copper") (thickness %g)' % STACKUP["inner_cu"]),
            ('"dielectric 3"', '(type "prepreg") (thickness %g) (material "%s") (epsilon_r %g) (loss_tangent 0.02)' % (pp[1], pp[0], pp[2])),
            ('"B.Cu"', '(type "copper") (thickness %g)' % STACKUP["outer_cu"]),
            ('"B.Mask"', '(type "Bottom Solder Mask") (thickness %g)' % STACKUP["mask"]),
            ('"B.Paste"', '(type "Bottom Solder Paste")'), ('"B.SilkS"', '(type "Bottom Silk Screen")')]
    block = "\t\t(stackup\n" + "".join("\t\t\t(layer %s %s)\n" % r for r in rows)
    block += '\t\t\t(copper_finish "%s")\n\t\t\t(dielectric_constraints yes)\n\t\t)\n' % STACKUP["finish"]
    txt = open(path).read()
    if "(stackup" in txt:
        return
    i = txt.index("\t(setup\n") + len("\t(setup\n")
    open(path, "w").write(txt[:i] + block + txt[i:])

def write_project(outdir):
    """pcbnew's Save() rewrites voxhub.kicad_pro with default rules - put ours back."""
    import shutil
    shutil.copyfile(os.path.join(os.path.dirname(os.path.abspath(__file__)), "project_settings.json"),
                    os.path.join(outdir, "voxhub.kicad_pro"))

def sorted_tracks(board):
    """Tracks/vias in a canonical order.  KiCad orders items by their (random) UUIDs when saving, so
    without this the patch router would see a different order - and take different decisions - on every run."""
    def key(tr):
        if tr.Type() == pcbnew.PCB_VIA_T:
            q = tr.GetPosition(); return (tr.GetNetname(), 1, 0, q.x, q.y, q.x, q.y, tr.GetWidth(pcbnew.F_Cu))
        a, e = tr.GetStart(), tr.GetEnd()
        if (a.x, a.y) > (e.x, e.y): a, e = e, a
        return (tr.GetNetname(), 0, tr.GetLayer(), a.x, a.y, e.x, e.y, tr.GetWidth())
    return sorted(board.GetTracks(), key=key)

def sorted_fps(board):
    return sorted(board.GetFootprints(), key=lambda fp: fp.GetReference())

def P(x, y):
    return pcbnew.VECTOR2I(MM(OX + x), MM(OY + y))

def load_netlist(path):
    t = parse(open(path).read())
    comps = {}
    for c in find(first(t, "components"), "comp"):
        ref = first(c, "ref")[1]
        props = {}
        for p in find(c, "property"):
            nm = first(p, "name"); vl = first(p, "value")
            if nm: props[nm[1]] = vl[1] if vl and len(vl) > 1 else ""
        fields = {}
        for f in find(first(c, "fields", []), "field"):
            nm = first(f, "name")
            if nm: fields[nm[1]] = f[2] if len(f) > 2 and not isinstance(f[2], list) else ""
        sp = first(c, "sheetpath")
        comps[ref] = dict(ref=ref, value=first(c, "value")[1], footprint=first(c, "footprint")[1],
                          tstamp=first(c, "tstamps")[1], sheet_tstamps=first(sp, "tstamps")[1],
                          sheet_name=first(sp, "names")[1], props=props, fields=fields, pins={})
    for n in find(first(t, "nets"), "net"):
        name = first(n, "name")[1]
        for nd in find(n, "node"):
            comps[first(nd, "ref")[1]]["pins"][first(nd, "pin")[1]] = name
    return comps

def crt_bbox(fp):
    """Courtyard bounding box (mm, board coords); falls back to pads."""
    xs, ys = [], []
    for g in fp.GraphicalItems():
        if g.GetLayer() in (pcbnew.F_CrtYd, pcbnew.B_CrtYd):
            b = g.GetBoundingBox()
            xs += [b.GetLeft(), b.GetRight()]; ys += [b.GetTop(), b.GetBottom()]
    if not xs:
        for p in fp.Pads():
            b = p.GetBoundingBox()
            xs += [b.GetLeft(), b.GetRight()]; ys += [b.GetTop(), b.GetBottom()]
    if not xs:
        b = fp.GetBoundingBox(False)
        xs += [b.GetLeft(), b.GetRight()]; ys += [b.GetTop(), b.GetBottom()]
    f = pcbnew.ToMM
    return (f(min(xs)) - OX, f(min(ys)) - OY, f(max(xs)) - OX, f(max(ys)) - OY)

def overlap(a, b, m=0.0):
    return not (a[2] + m <= b[0] or b[2] + m <= a[0] or a[3] + m <= b[1] or b[3] + m <= a[1])

def place(netlist, outdir):
    comps = load_netlist(netlist)
    model = json.load(open(os.path.join(os.path.dirname(os.path.abspath(__file__)), "model_netlist.json")))
    board = pcbnew.CreateEmptyBoard()
    board.SetCopperLayerCount(4)
    board.SetFileName(os.path.join(outdir, "voxhub.kicad_pcb"))
    nets = {}
    def net(name):
        if name not in nets:
            ni = pcbnew.NETINFO_ITEM(board, name)
            board.Add(ni); nets[name] = ni
        return nets[name]
    fps = {}
    for ref in sorted(comps):
        c = comps[ref]
        lib, name = c["footprint"].split(":")
        libdir = os.path.join(outdir, "voxhub.pretty") if lib == "voxhub" else os.path.join(SYS_FP, lib + ".pretty")
        fp = pcbnew.FootprintLoad(libdir, name)
        if fp is None:
            raise RuntimeError("footprint not found: " + c["footprint"])
        fp.SetFPID(pcbnew.LIB_ID(lib, name))
        fp.SetReference(ref); fp.SetValue(c["value"])
        fp.SetPath(pcbnew.KIID_PATH(c["sheet_tstamps"].rstrip("/") + "/" + c["tstamp"]))
        fp.SetSheetname(c["sheet_name"]); fp.SetSheetfile(c["props"].get("Sheetfile", ""))
        for k in ("MPN", "Manufacturer", "PartDescription"):
            v = c["fields"].get(k) or model.get(ref, {}).get("fields", {}).get(k, "")
            if v:
                fp.SetField(k, v)
                fp.GetFieldByName(k).SetVisible(False)
        m = model.get(ref, {})
        if m.get("dnp"):
            fp.SetDNP(True)
        attrs = fp.GetAttributes()
        if not m.get("in_bom", True):
            attrs |= pcbnew.FP_EXCLUDE_FROM_BOM | pcbnew.FP_EXCLUDE_FROM_POS_FILES
        fp.SetAttributes(attrs)
        ep = max((q.GetNumber() for q in fp.Pads() if q.GetNumber().isdigit()), key=int, default="") if ref.startswith("U") else ""
        for pad in fp.Pads():
            n = c["pins"].get(pad.GetNumber())
            if n and pad.GetNumber():
                pad.SetNet(net(n))
            if ep and pad.GetNumber() in SOLID_PADS.get(ref, (ep,)) and n == "GND":
                pad.SetLocalZoneConnection(pcbnew.ZONE_CONNECTION_FULL)
        # 3D models: use the copies / stand-ins shipped in hardware/3dmodels (the KiCad docker image has none)
        mdls = [m_ for m_ in fp.Models()]
        fp.Models().clear()
        for mdl in mdls:               # (Models() hands out copies - rebuild the list)
            fn = mdl.m_Filename.replace("${KICAD9_3DMODEL_DIR}/", "").replace(".wrl", ".step")
            if not fn.startswith("${KIPRJMOD}"):
                mdl.m_Filename = "${KIPRJMOD}/3dmodels/" + fn
            fp.Models().push_back(mdl)
        if ref == "J2":      # the CM4 itself (module + heat sink) rides on its socket footprint
            m3 = pcbnew.FP_3DMODEL()
            m3.m_Filename = "${KIPRJMOD}/3dmodels/RaspberryPi_CM4_with_heatsink.step"
            m3.m_Offset = pcbnew.VECTOR3D(71.5 - 74.0, 64.96 - 48.0, 0.0)
            fp.Models().push_back(m3)
        fp.Reference().SetVisible(True)
        fp.Reference().SetLayer(pcbnew.F_Fab)
        for fld in (fp.Reference(), fp.Value()):
            fld.SetTextSize(pcbnew.VECTOR2I(MM(0.7), MM(0.7))); fld.SetTextThickness(MM(0.1))
        board.Add(fp)
        fps[ref] = fp

    def put(ref, x, y, rot, side):
        fp = fps[ref]
        if side == "B" and not fp.IsFlipped():
            fp.SetPosition(P(x, y))
            fp.Flip(P(x, y), pcbnew.FLIP_DIRECTION_LEFT_RIGHT)
        fp.SetPosition(P(x, y))
        fp.SetOrientationDegrees(rot)

    placed = {"F": [], "B": []}       # courtyard boxes
    def commit(ref, side):
        bb = crt_bbox(fps[ref])
        tht = any(p.GetAttribute() in (pcbnew.PAD_ATTRIB_PTH, pcbnew.PAD_ATTRIB_NPTH) for p in fps[ref].Pads())
        if ref[0] == "U" or ref in ("Q1", "L1", "Y1"):       # leave a routing channel around ICs
            g_ = 1.3 if ref == "U9" else 0.6                 # (the WLCSP needs room for its escape pattern)
            bb = (bb[0] - g_, bb[1] - g_, bb[2] + g_, bb[3] + g_)
        placed[side].append(bb)
        if tht and ref not in ("MK1", "MK2") and not ref.startswith("D"):
            placed["B" if side == "F" else "F"].append(bb)

    for ref, m in model.items():
        if m.get("pos"):
            FIXED[ref] = tuple(m["pos"])
    for ref, (x, y, rot, side) in FIXED.items():
        put(ref, x, y, rot, side); commit(ref, side)

    def pad_xy(ref, num):
        for p in fps[ref].Pads():
            if p.GetNumber() == num:
                q = p.GetPosition()
                return (pcbnew.ToMM(q.x) - OX, pcbnew.ToMM(q.y) - OY)
        raise RuntimeError("no pad %s.%s" % (ref, num))
    pre = prewire.plan(pad_xy)
    placed["F"].extend(prewire.boxes(pre))

    def padpos(ref, netname=None):
        out = []
        for p in fps[ref].Pads():
            if netname is None or p.GetNetname() == netname:
                q = p.GetPosition()
                out.append((pcbnew.ToMM(q.x) - OX, pcbnew.ToMM(q.y) - OY, p))
        return out

    done = set(FIXED)
    used_pwr = {}
    todo = [r for r in comps if r not in done]
    def prio(r):
        c = comps[r]
        sig = [n for n in c["pins"].values() if n not in POWER]
        big = crt_bbox(fps[r]); area = (big[2] - big[0]) * (big[3] - big[1])
        return (0 if r[0] in "QYL" else 1, -area if area > 6 else 0, 0 if sig else 1, r)
    # ICs' own decoupling first is handled by the per-pad balancing below
    for ref in sorted(todo, key=prio):
        c = comps[ref]; m = model.get(ref, {})
        near = m.get("near")
        mynets = list(dict.fromkeys(c["pins"].values()))
        sig = [n for n in mynets if n not in POWER and not n.startswith("unconnected")]
        target = None; tnet = None
        if near in fps and near in done:
            for n in sig:
                pp = padpos(near, n)
                if pp:
                    target = pp[0][:2]; tnet = n; break
            if target is None:
                for n in [x for x in mynets if x in ("+5V", "+3V3")] + [x for x in mynets if x == "GND"]:
                    pp = padpos(near, n)
                    if pp:
                        pp.sort(key=lambda q: used_pwr.get((near, q[2].GetNumber()), 0))
                        used_pwr[(near, pp[0][2].GetNumber())] = used_pwr.get((near, pp[0][2].GetNumber()), 0) + 1
                        target = pp[0][:2]; tnet = n; break
            if target is None:
                q = fps[near].GetPosition(); target = (pcbnew.ToMM(q.x) - OX, pcbnew.ToMM(q.y) - OY)
        elif near in ANCHOR_PTS:
            target = ANCHOR_PTS[near]
        if target is None or (tnet is None and sig):
            # any already placed pad on one of my signal nets
            best = None
            for n in sig:
                for r2 in done:
                    for q in padpos(r2, n):
                        dd = 0 if target is None else math.hypot(q[0] - target[0], q[1] - target[1])
                        if best is None or dd < best[0]:
                            best = (dd, q[:2], n)
            if best and (target is None or best[0] < 12):
                target, tnet = best[1], best[2]
        if target is None:
            target = (50.0, 20.0)
        fp = fps[ref]
        found = None
        offs = sorted(((dx * 0.4, dy * 0.4) for dx in range(-70, 71) for dy in range(-70, 71)),
                      key=lambda o: o[0] ** 2 + o[1] ** 2)
        for dx, dy in offs:
            x, y = round(target[0] + dx, 2), round(target[1] + dy, 2)
            if not (1.0 < x < W - 1.0 and 1.0 < y < H - 1.0):
                continue
            cand = None
            for rot in (0, 90, 180, 270):
                put(ref, x, y, rot, "F")
                bb = crt_bbox(fp)
                if bb[0] < 0.6 or bb[1] < 0.6 or bb[2] > W - 0.6 or bb[3] > H - 0.6:
                    continue
                if any(overlap(bb, b, 0.45) for b in placed["F"]) or any(overlap(bb, b) for b in NOGO_F):
                    continue
                if any(overlap(bb, (hx - 3.3, hy - 3.3, hx + 3.3, hy + 3.3)) for hx, hy in HOLES):
                    continue
                cost = 0.0
                if tnet:
                    pp = padpos(ref, tnet)
                    if pp:
                        cost = min(math.hypot(q[0] - target[0], q[1] - target[1]) for q in pp)
                if cand is None or cost < cand[0]:
                    cand = (cost, rot)
            if cand:
                found = (x, y, cand[1]); break
        if not found:
            raise RuntimeError("no room for " + ref)
        put(ref, found[0], found[1], found[2], "F"); commit(ref, "F"); done.add(ref)

    # ---- board outline (3 mm corner radius) ---------------------------------
    r = 3.0
    def seg(x1, y1, x2, y2):
        s = pcbnew.PCB_SHAPE(board); s.SetShape(pcbnew.SHAPE_T_SEGMENT); s.SetLayer(pcbnew.Edge_Cuts)
        s.SetStart(P(x1, y1)); s.SetEnd(P(x2, y2)); s.SetWidth(MM(0.1)); board.Add(s)
    def arc(cx, cy, sx, sy, ang):
        s = pcbnew.PCB_SHAPE(board); s.SetShape(pcbnew.SHAPE_T_ARC); s.SetLayer(pcbnew.Edge_Cuts)
        s.SetCenter(P(cx, cy)); s.SetStart(P(sx, sy)); s.SetArcAngleAndEnd(pcbnew.EDA_ANGLE(ang, pcbnew.DEGREES_T))
        s.SetWidth(MM(0.1)); board.Add(s)
    seg(r, 0, W - r, 0); seg(W, r, W, H - r); seg(W - r, H, r, H); seg(0, H - r, 0, r)
    arc(r, r, 0, r, 90); arc(W - r, r, W - r, 0, 90); arc(W - r, H - r, W, H - r, 90); arc(r, H - r, r, H, 90)
    def text(s, x, y, layer, size=1.0, rot=0):
        tx = pcbnew.PCB_TEXT(board); tx.SetText(s); tx.SetPosition(P(x, y)); tx.SetLayer(layer)
        tx.SetTextSize(pcbnew.VECTOR2I(MM(size), MM(size))); tx.SetTextThickness(MM(size * 0.15))
        tx.SetTextAngle(pcbnew.EDA_ANGLE(rot, pcbnew.DEGREES_T))
        if layer == pcbnew.B_SilkS: tx.SetMirrored(True)
        board.Add(tx)
    add_rule_areas(board)
    trim_silk(board)
    legends = Legends(board, pre)
    legends.put("VoxHub CM4  rev A2", pcbnew.F_SilkS, 1.2, (22.0, 41.0))
    legends.put("USB-C PD 9-20V", pcbnew.B_SilkS, 1.0, (13.0, 10.5))
    legends.put("SPK", pcbnew.F_SilkS, 1.0, (8.6, 58.5), rots=(90, 0))
    legends.put("J5: GND TX RX", pcbnew.F_SilkS, 1.0, (80.0, 18.6))
    legends.put("VoxHub CM4 rev A2 - this side faces the top cover", pcbnew.B_SilkS, 1.0, (60.0, 50.0))
    legends.put("github.com/geilevideossos-gamedev/fable-sbc-test", pcbnew.B_SilkS, 1.0, (60.0, 53.0))
    legends.put("MUTE", pcbnew.B_SilkS, 1.0, (33.5, 57.4))
    tps = sorted((pcbnew.ToMM(fps[r].GetPosition().x) - OX, pcbnew.ToMM(fps[r].GetPosition().y) - OY, r) for r in fps if r.startswith("TP"))
    for x, y, ref in tps:
        side = -1 if x < tps[-1][0] - 0.1 else 1
        top = any(abs(x2 - x) < 0.1 and y2 > y + 0.1 for x2, y2, _ in tps)
        legends.put(fps[ref].GetValue().replace("+", ""), pcbnew.F_SilkS, 1.0, (x, y - 2.3) if top else (x + side * 3.2, y), reach=8.0)
    for mk in ("MK1", "MK2"):
        q = fps[mk].GetPosition()
        legends.put("MIC - NO WASH", pcbnew.B_SilkS, 1.0, (pcbnew.ToMM(q.x) - OX, pcbnew.ToMM(q.y) - OY + (-4.2 if mk == "MK1" else 4.2)), reach=14.0)
    # ---- mechanical drawing layer (exported to DXF): holes, ports, connector envelopes -----
    mech = [("feature", "ref", "x_mm", "y_mm", "detail")]
    def circle(x, y, d):
        s = pcbnew.PCB_SHAPE(board); s.SetShape(pcbnew.SHAPE_T_CIRCLE); s.SetLayer(pcbnew.Dwgs_User)
        s.SetCenter(P(x, y)); s.SetEnd(P(x + d / 2, y)); s.SetWidth(MM(0.1)); board.Add(s)
    def boxd(bb):
        s = pcbnew.PCB_SHAPE(board); s.SetShape(pcbnew.SHAPE_T_RECT); s.SetLayer(pcbnew.Dwgs_User)
        s.SetStart(P(bb[0], bb[1])); s.SetEnd(P(bb[2], bb[3])); s.SetWidth(MM(0.1)); board.Add(s)
    fmm = pcbnew.ToMM
    for ref in sorted(fps):
        fp = fps[ref]; q = fp.GetPosition(); x, y = fmm(q.x) - OX, fmm(q.y) - OY
        if ref in ("H1", "H2", "H3", "H4"):
            circle(x, y, 2.7); text(ref, x, y - 2.2, pcbnew.Dwgs_User, 0.8); mech.append(("PCB mounting hole", ref, x, y, "2.7 mm NPTH (M2.5)"))
        elif ref in ("H5", "H6", "H7", "H8"):
            circle(x, y, 2.7); circle(x, y, 5.1); mech.append(("CM4 spacer", ref, x, y, "M2.5 SMT spacer, 1.5 mm high, hole 3.7 mm"))
        elif ref in ("J1", "J4", "J6", "J7", "J5", "SW1", "U11"):
            bb = crt_bbox(fp); boxd(bb); text(ref, (bb[0] + bb[2]) / 2, (bb[1] + bb[3]) / 2, pcbnew.Dwgs_User, 0.8)
            mech.append(("connector/part envelope", ref, x, y, "courtyard %.2f,%.2f .. %.2f,%.2f; side %s" % (bb[0], bb[1], bb[2], bb[3], "B" if fp.IsFlipped() else "F")))
        for pad in fp.Pads():
            if pad.GetAttribute() == pcbnew.PAD_ATTRIB_NPTH and (ref.startswith("MK") or ref.startswith("D")):
                pq = pad.GetPosition(); px, py = fmm(pq.x) - OX, fmm(pq.y) - OY
                if ref.startswith("MK"):
                    circle(px, py, 0.8); circle(px, py, 5.0); mech.append(("microphone port", ref, px, py, "0.8 mm hole through PCB, sound enters from the side opposite the components"))
                else:
                    circle(px, py, 3.0); mech.append(("LED light slot", ref, px, py, "1.8 x 2.4 mm slot, reverse-mount LED shines to the side opposite the components"))
    boxd((CM4_X0 - 51.5, CM4_Y0 - 36.5, CM4_X0 + 3.5, CM4_Y0 + 3.5)); text("CM4 module outline", 71.5, 48.0, pcbnew.Dwgs_User, 1.2)
    mech.append(("CM4 module outline", "J2/J3", 71.5, 48.0, "55 x 40 mm, x 44..99, y 28..68, 1.5 mm above the PCB"))
    mech.append(("board outline", "-", 0.0, 0.0, "100 x 74 mm, origin = rear-left corner seen from the component side, 3 mm corner radius; KiCad page offset %.0f/%.0f mm" % (OX, OY)))
    import csv as _csv
    os.makedirs(os.path.join(outdir, "outputs"), exist_ok=True)
    with open(os.path.join(outdir, "outputs", "mechanical_positions.csv"), "w", newline="") as fh:
        w_ = _csv.writer(fh)
        for row in mech:
            w_.writerow([("%.3f" % v) if isinstance(v, float) else v for v in row])
    lay_prewire(board, pre)
    fanout(board, pre)
    add_df40_strips(board)
    board.BuildConnectivity()
    board.Save(board.GetFileName()); write_project(outdir)
    write_stackup(board.GetFileName())
    json.dump({r: [round(pcbnew.ToMM(f.GetPosition().x) - OX, 3), round(pcbnew.ToMM(f.GetPosition().y) - OY, 3),
                   f.GetOrientationDegrees(), "B" if f.IsFlipped() else "F"] for r, f in fps.items()},
              open(os.path.join(outdir, "gen", "placement.json"), "w"), indent=0, sort_keys=True)
    print("placed", len(fps), "footprints")


# ---------------------------------------------------------------------------------------
# Power fan-out: every SMD pad on a plane net (GND -> In1, +5V -> In2) gets a short stub and
# a via (or shares a neighbour's via).  Done before autorouting so the router only has to
# deal with signals; the stubs/vias are locked and exported as fixed wiring.
# ---------------------------------------------------------------------------------------
PLANE_NETS = ("GND", "+5V")
SOLID_PADS = {"U2": ("9", "1")}
RING_PADS = {"H5": "1", "H6": "1", "H7": "1", "H8": "1", "MK1": "5", "MK2": "5"}
RING_START, RING_OVERLAP = 0.05, 0.15
U9_ESCAPE = {"A1": [(-0.7, -0.6), (-1.2, -1.1)], "B1": [(-1.2, -0.2)], "C1": [(-1.5, 0.2)], "D1": [(-0.7, 0.6), (-1.2, 1.1)],
             "A2": [(0.7, -0.6), (1.2, -1.1)], "B2": [(1.0, -0.2)], "C2": [(1.5, 0.2)], "D2": [(0.7, 0.6), (1.2, 1.1)]}

def prune_escapes(board, tracks):
    f = pcbnew.ToMM
    def xy(v): return (f(v.x) - OX, f(v.y) - OY)
    def near(a, b, tol=0.02): return abs(a[0] - b[0]) < tol and abs(a[1] - b[1]) < tol
    pruned = 0
    for fp in sorted_fps(board):
        if fp.GetReference() != "U9":
            continue
        ux, uy = xy(fp.GetPosition())
        for pad in fp.Pads():
            e = U9_ESCAPE.get(pad.GetNumber())
            if not e or pad.GetNetname() in PLANE_NETS:
                continue
            net = pad.GetNetname()
            pts = [xy(pad.GetPosition())] + [(ux + ex, uy + ey) for ex, ey in e]
            for k in range(len(pts) - 1, 0, -1):
                a, b = pts[k - 1], pts[k]
                seg = [i for i, tr in enumerate(tracks) if tr is not None and tr.Type() != pcbnew.PCB_VIA_T and tr.GetNetname() == net
                       and ((near(xy(tr.GetStart()), a) and near(xy(tr.GetEnd()), b)) or (near(xy(tr.GetStart()), b) and near(xy(tr.GetEnd()), a)))]
                if not seg:
                    continue
                used = any(tr is not None and i not in seg and tr.GetNetname() == net and
                           (near(xy(tr.GetPosition()), b) if tr.Type() == pcbnew.PCB_VIA_T else (near(xy(tr.GetStart()), b) or near(xy(tr.GetEnd()), b)))
                           for i, tr in enumerate(tracks))
                if used:
                    break
                for i in seg:
                    board.Remove(tracks[i]); _KEEP.append(tracks[i]); tracks[i] = None; pruned += 1
    return pruned

def neck_at_pads(board, tracks):
    f = pcbnew.ToMM
    pads = [p for fp in sorted_fps(board) for p in fp.Pads() if p.GetAttribute() == pcbnew.PAD_ATTRIB_SMD and p.GetNetname()]
    n = 0
    for i, tr in enumerate(list(tracks)):
        if tr is None or tr.Type() == pcbnew.PCB_VIA_T or tr.IsLocked():
            continue
        for p in pads:
            if p.GetNetname() != tr.GetNetname() or not p.IsOnLayer(tr.GetLayer()):
                continue
            s = p.GetSize(pcbnew.F_Cu); pw = min(s.x, s.y)
            if tr.GetWidth() <= pw + MM(0.005):
                continue
            for end, other in ((tr.GetEnd(), tr.GetStart()), (tr.GetStart(), tr.GetEnd())):
                if not p.HitTest(end):
                    continue
                L = f(tr.GetLength()); reach = f(max(s.x, s.y)) / 2 + 0.3
                if L > reach + 0.05:
                    k = reach / L
                    mid = pcbnew.VECTOR2I(int(end.x + (other.x - end.x) * k), int(end.y + (other.y - end.y) * k))
                    nt = pcbnew.PCB_TRACK(board); nt.SetLayer(tr.GetLayer()); nt.SetNetCode(tr.GetNetCode())
                    nt.SetStart(mid); nt.SetEnd(end); nt.SetWidth(pw); board.Add(nt); tracks.append(nt)
                    if end == tr.GetEnd(): tr.SetEnd(mid)
                    else: tr.SetStart(mid)
                else:
                    tr.SetWidth(pw)
                n += 1
                break
    return n

def tidy_fanout(board, tracks):
    f = pcbnew.ToMM
    def xy(v): return (f(v.x) - OX, f(v.y) - OY)
    def near(a, b, tol=0.002): return abs(a[0] - b[0]) < tol and abs(a[1] - b[1]) < tol
    moved = 0
    for fp in sorted_fps(board):
        ref = fp.GetReference()
        if ref in RING_PADS:
            cand = [q for q in fp.Pads() if q.GetNumber() == RING_PADS[ref] and q.IsOnLayer(pcbnew.F_Cu)]
            pad = max(cand, key=lambda q: q.GetBoundingBox().GetWidth())
            b = pad.GetBoundingBox()
            cx, cy = f(b.GetCenter().x) - OX, f(b.GetCenter().y) - OY
            r = f(b.GetWidth()) / 2
            for tr in tracks:
                if tr is None or tr.Type() == pcbnew.PCB_VIA_T or not tr.IsLocked() or tr.GetNetname() != pad.GetNetname():
                    continue
                for get, put in ((tr.GetStart, tr.SetStart), (tr.GetEnd, tr.SetEnd)):
                    x, y = xy(get())
                    d = math.hypot(x - cx, y - cy)
                    if abs(d - (r - RING_START)) < 0.005:
                        k = (r - RING_OVERLAP) / d
                        put(P(cx + (x - cx) * k, cy + (y - cy) * k)); moved += 1
    pruned = prune_escapes(board, tracks)
    necked = neck_at_pads(board, tracks)
    print("fan-out tidied: %d ring stubs moved into their pad, %d unused escape tails removed, %d track ends necked to the pad width" % (moved, pruned, necked))
    return [t for t in tracks if t is not None]

def _pt_rect(px, py, r):
    dx = max(r[0] - px, 0.0, px - r[2]); dy = max(r[1] - py, 0.0, py - r[3])
    return math.hypot(dx, dy)

def _seg_rect(x1, y1, x2, y2, r):
    n = max(2, int(math.hypot(x2 - x1, y2 - y1) / 0.05) + 1)
    return min(_pt_rect(x1 + (x2 - x1) * i / n, y1 + (y2 - y1) * i / n, r) for i in range(n + 1))

def lay_prewire(board, pre):
    for net, x, y, dia in pre["vias"]:
        v = pcbnew.PCB_VIA(board); v.SetPosition(P(x, y)); v.SetWidth(pcbnew.F_Cu, MM(dia))
        v.SetDrill(MM(VIA_DRILL)); v.SetViaType(pcbnew.VIATYPE_THROUGH)
        v.SetLayerPair(pcbnew.F_Cu, pcbnew.B_Cu); v.SetNetCode(board.GetNetcodeFromNetname(net)); v.SetLocked(True)
        board.Add(v)
    for lock, key in ((True, "tracks"), (False, "usb")):
        for net, lay, x1, y1, x2, y2, w in pre[key]:
            s = pcbnew.PCB_TRACK(board); s.SetStart(P(x1, y1)); s.SetEnd(P(x2, y2)); s.SetWidth(MM(w))
            s.SetLayer(pcbnew.F_Cu if lay == "F" else pcbnew.B_Cu); s.SetNetCode(board.GetNetcodeFromNetname(net)); s.SetLocked(lock)
            board.Add(s)
    print("prewire: %d power / fixed tracks, %d USB tracks, %d vias" % (len(pre["tracks"]), len(pre["usb"]), len(pre["vias"])))

def lock_usb(outdir):
    board = pcbnew.LoadBoard(os.path.join(outdir, "voxhub.kicad_pcb"))
    n = 0
    for tr in board.GetTracks():
        if tr.GetNetname() in prewire.USB_NETS and not tr.IsLocked():
            tr.SetLocked(True); n += 1
    board.Save(board.GetFileName()); write_project(outdir)
    print("USB tracks locked:", n)

def fanout(board, pre=None):
    f = pcbnew.ToMM
    pads = []      # (net, layers 'F'/'B'/'*', bbox, pad)
    for fp in sorted_fps(board):
        for p in fp.Pads():
            b = p.GetBoundingBox()
            bb = (f(b.GetLeft()) - OX, f(b.GetTop()) - OY, f(b.GetRight()) - OX, f(b.GetBottom()) - OY)
            th = p.GetAttribute() in (pcbnew.PAD_ATTRIB_PTH, pcbnew.PAD_ATTRIB_NPTH)
            if not th and not (p.IsOnLayer(pcbnew.F_Cu) or p.IsOnLayer(pcbnew.B_Cu)):
                continue                                       # paste-only apertures
            lay = "*" if th else ("F" if p.IsOnLayer(pcbnew.F_Cu) else "B")
            pads.append((p.GetNetname(), lay, bb, p))
    kos = board_keepouts(board)
    vias = []      # (net, x, y, dia)
    segs = []      # (net, layer, x1, y1, x2, y2, w)
    if pre:
        vias += list(pre["vias"]); segs += list(pre["tracks"]) + list(pre["usb"])
    n_pre_v, n_pre_s = len(vias), len(segs)
    stats = dict(center=0, shared=0, new=0, failed=[])
    def prewired(net, lay, bb):
        for n2, l2, x1, y1, x2, y2, w in segs[:n_pre_s]:
            if n2 == net and l2 == lay and any(bb[0] - 0.01 <= x <= bb[2] + 0.01 and bb[1] - 0.01 <= y <= bb[3] + 0.01 for x, y in ((x1, y1), (x2, y2))):
                return True
        return False

    def via_ok(net, x, y, dia, own):
        if not (0.7 < x < W - 0.7 and 0.7 < y < H - 0.7):
            return False
        if any(k[0] - dia / 2 - 0.1 < x < k[2] + dia / 2 + 0.1 and k[1] - dia / 2 - 0.1 < y < k[3] + dia / 2 + 0.1 for k in kos):
            return False
        for n2, lay, bb, p in pads:
            if p is own:
                continue
            if abs((bb[0] + bb[2]) / 2 - x) > 6 or abs((bb[1] + bb[3]) / 2 - y) > 6:
                continue
            d = _pt_rect(x, y, bb) - dia / 2
            if n2 == net and lay != "*":
                big = (bb[2] - bb[0]) * (bb[3] - bb[1]) >= 1.4 and p.GetParentFootprint().GetReference().startswith("U")
                if d < (-dia * 0.25 if big else 0.1):        # do not sit half on a neighbouring same-net pad
                    return False
                continue
            if d < (0.25 if lay == "*" else 0.2):
                return False
        for n2, vx, vy, vd in vias:
            dd = math.hypot(vx - x, vy - y)
            if dd < (0.62 if n2 == net else (vd + dia) / 2 + 0.2):
                return False
        for n2, lay, x1, y1, x2, y2, w in segs:
            if n2 != net and _seg_rect(x1, y1, x2, y2, (x, y, x, y)) < dia / 2 + w / 2 + 0.15:
                return False
        return True

    def seg_ok(net, lay, x1, y1, x2, y2, w, own):
        if any(lay in k[4] and _seg_rect(x1, y1, x2, y2, k) < w / 2 + 0.1 and _pt_rect(x1, y1, k) > 0.05 for k in kos):
            return False
        for n2, l2, bb, p in pads:
            if p is own or n2 == net:
                continue
            if l2 not in ("*", lay):
                continue
            if abs((bb[0] + bb[2]) / 2 - x1) > 8 or abs((bb[1] + bb[3]) / 2 - y1) > 8:
                continue
            if _seg_rect(x1, y1, x2, y2, bb) < w / 2 + 0.15:
                return False
        for n2, vx, vy, vd in vias:
            if n2 != net and _seg_rect(x1, y1, x2, y2, (vx, vy, vx, vy)) < vd / 2 + w / 2 + 0.15:
                return False
        for n2, l2, a1, b1, a2, b2, w2 in segs:
            if n2 == net or l2 != lay:
                continue
            n = max(2, int(math.hypot(a2 - a1, b2 - b1) / 0.1) + 1)
            if min(_seg_rect(x1, y1, x2, y2, (a1 + (a2 - a1) * i / n,) * 1 + (b1 + (b2 - b1) * i / n,) +
                             (a1 + (a2 - a1) * i / n, b1 + (b2 - b1) * i / n)) for i in range(n + 1)) < (w + w2) / 2 + 0.15:
                return False
        return True

    for fp in sorted_fps(board):
        if fp.GetReference() != "U9":
            continue
        q0 = fp.GetPosition(); ux, uy = f(q0.x) - OX, f(q0.y) - OY
        esc = U9_ESCAPE
        for pad in fp.Pads():
            if pad.GetNumber() not in esc:
                continue
            qp = pad.GetPosition(); last = (f(qp.x) - OX, f(qp.y) - OY)
            for ex, ey in esc[pad.GetNumber()]:
                segs.append((pad.GetNetname(), "F", last[0], last[1], ux + ex, uy + ey, 0.15)); last = (ux + ex, uy + ey)
            if pad.GetNetname() in PLANE_NETS:
                vias.append((pad.GetNetname(), last[0], last[1], 0.5))
    def ring(q):
        return RING_PADS.get(q.GetParentFootprint().GetReference()) == q.GetNumber()
    rings = {}
    for q in pads:
        if ring(q[3]) and q[0] in PLANE_NETS and q[1] in ("F", "B"):
            k = q[3].GetParentFootprint().GetReference()
            if k not in rings or q[2][2] - q[2][0] > rings[k][2][2] - rings[k][2][0]:
                rings[k] = q
    for k in sorted(rings):
        net, lay, bb, p = rings[k]
        if True:
            cx, cy = (bb[0] + bb[2]) / 2, (bb[1] + bb[3]) / 2
            r = (bb[2] - bb[0]) / 2
            dia, tw = (0.6, 0.4) if r > 2 else (0.5, 0.25)
            for dx, dy in ((1, 0), (-1, 0), (0, 1), (0, -1)):
                sx, sy, vx, vy = cx + dx * (r - RING_START), cy + dy * (r - RING_START), cx + dx * (r + dia / 2 + 0.2), cy + dy * (r + dia / 2 + 0.2)
                if via_ok(net, vx, vy, dia, p) and seg_ok(net, lay, sx, sy, vx, vy, tw, p):
                    vias.append((net, vx, vy, dia)); segs.append((net, lay, sx, sy, vx, vy, tw)); break
            else:
                stats["failed"].append("%s.%s(%s)" % (p.GetParentFootprint().GetReference(), p.GetNumber(), net))
    todo = [q for q in pads if q[0] in PLANE_NETS and q[1] in ("F", "B") and q[3].GetParentFootprint().GetReference() != "U9"
            and not ring(q[3]) and not prewired(q[0], q[1], q[2])]
    todo.sort(key=lambda q: (q[2][2] - q[2][0]) * (q[2][3] - q[2][1]))      # tightest pads first
    for net, lay, bb, p in todo:
        cx, cy = (bb[0] + bb[2]) / 2, (bb[1] + bb[3]) / 2
        w_, h_ = bb[2] - bb[0], bb[3] - bb[1]
        small = min(w_, h_) < 0.35
        dia, drill, tw = (0.5, 0.25, min(0.2, min(w_, h_))) if small else (0.6, 0.3, min(0.4, max(0.2, min(w_, h_) * 0.8)))
        fpr = p.GetParentFootprint()
        is_ep = fpr.GetReference().startswith("U") and p.GetNumber() == max(
            (q.GetNumber() for q in fpr.Pads() if q.GetNumber().isdigit()), key=int, default="")
        if is_ep and w_ * h_ >= 1.4:
            # large pad (exposed pad, bulk cap, inductor): via(s) in the pad
            n_v = 1 if w_ * h_ < 6 else 2
            for k in range(n_v):
                ox = (k - (n_v - 1) / 2) * min(1.2, w_ / 3) if w_ >= h_ else 0.0
                oy = (k - (n_v - 1) / 2) * min(1.2, h_ / 3) if h_ > w_ else 0.0
                if via_ok(net, cx + ox, cy + oy, 0.6, p):
                    vias.append((net, cx + ox, cy + oy, 0.6))
            stats["center"] += 1
            continue
        best = None
        ep = None
        if small and net == "GND" and fpr.GetReference() not in ("J2", "J3"):
            for q in fpr.Pads():
                qb = q.GetBoundingBox()
                if q.GetNetname() == net and q is not p and f(qb.GetWidth()) * f(qb.GetHeight()) >= 1.4 and q.IsOnLayer(pcbnew.F_Cu if lay == "F" else pcbnew.B_Cu):
                    ep = (f(qb.GetLeft()) - OX, f(qb.GetTop()) - OY, f(qb.GetRight()) - OX, f(qb.GetBottom()) - OY)
        if ep is not None:
            ex = min(max(cx, ep[0] + 0.25), ep[2] - 0.25); ey = min(max(cy, ep[1] + 0.25), ep[3] - 0.25)
            if seg_ok(net, lay, cx, cy, ex, ey, tw, p):
                segs.append((net, lay, cx, cy, ex, ey, tw)); stats["shared"] += 1
                continue
        via_path = None
        if fpr.GetReference() in ("J2", "J3"):
            q0 = fpr.GetPosition(); ccy = f(q0.y) - OY
            jy = ccy + math.copysign(DF40_JOG, cy - ccy)
            for dxv in (0.0, 0.2, -0.2, 0.4, -0.4, 0.6, -0.6):
                pts = [(cx, cy), (cx, jy), (cx + dxv, ccy)] if dxv else [(cx, cy), (cx, ccy)]
                if not all(seg_ok(net, lay, a[0], a[1], b[0], b[1], tw, p) for a, b in zip(pts, pts[1:])):
                    continue
                shared = any(n2 == net and abs(vy - ccy) < 0.01 and abs(vx - (cx + dxv)) < 0.01 for n2, vx, vy, vd in vias)
                if shared or via_ok(net, cx + dxv, ccy, 0.5, p):
                    best = (0.0, cx + dxv, ccy, None if shared else 0.5); via_path = pts; break
        # 1) share an existing via of the same net
        for n2, vx, vy, vd in (vias if best is None and fpr.GetReference() not in ("J2", "J3") else []):
            if n2 == net and math.hypot(vx - cx, vy - cy) < 2.2 and seg_ok(net, lay, cx, cy, vx, vy, tw, p):
                d = math.hypot(vx - cx, vy - cy)
                if best is None or d < best[0]:
                    best = (d, vx, vy, None)
        if best is None:
            # 2) new via: scan outwards
            rmin = max(w_, h_) / 2 + dia / 2 + 0.12 if not small else min(w_, h_) / 2 + 0.2
            q0 = fpr.GetPosition(); fx, fy = f(q0.x) - OX, f(q0.y) - OY
            def outside(x, y):
                if _pt_rect(x, y, bb) < dia / 2 + 0.1:
                    return False
                if not small:
                    return True
                if w_ >= h_:
                    return (x - fx) * (cx - fx) > 0 and abs(x - fx) >= max(abs(bb[0] - fx), abs(bb[2] - fx)) + dia / 2 + 0.1
                return (y - fy) * (cy - fy) > 0 and abs(y - fy) >= max(abs(bb[1] - fy), abs(bb[3] - fy)) + dia / 2 + 0.1
            for r in [rmin + 0.2 * i for i in range(0, 30)]:
                for a in range(0, 360, 15):
                    x, y = cx + r * math.cos(math.radians(a)), cy + r * math.sin(math.radians(a))
                    if outside(x, y) and via_ok(net, x, y, dia, p) and seg_ok(net, lay, cx, cy, x, y, tw, p):
                        # prefer leaving a fine-pitch pad along its long axis
                        pen = 0.0
                        if small:
                            pen = abs(math.sin(math.radians(a))) if w_ > h_ else abs(math.cos(math.radians(a)))
                        if best is None or r + pen < best[0]:
                            best = (r + pen, x, y, dia)
                if best is not None:
                    break
        if best is None:
            stats["failed"].append("%s.%s(%s)" % (p.GetParentFootprint().GetReference(), p.GetNumber(), net))
            continue
        _, x, y, vd = best
        if vd:
            vias.append((net, x, y, vd)); stats["new"] += 1
        else:
            stats["shared"] += 1
        if via_path:
            segs.extend((net, lay, a[0], a[1], b[0], b[1], tw) for a, b in zip(via_path, via_path[1:]))
        else:
            segs.append((net, lay, cx, cy, x, y, tw))

    for net, x, y, dia in vias[n_pre_v:]:
        v = pcbnew.PCB_VIA(board); v.SetPosition(P(x, y)); v.SetWidth(pcbnew.F_Cu, MM(dia)) if hasattr(v, "SetWidth") else None
        v.SetDrill(MM(VIA_DRILL)); v.SetViaType(pcbnew.VIATYPE_THROUGH)
        v.SetLayerPair(pcbnew.F_Cu, pcbnew.B_Cu); v.SetNetCode(board.GetNetcodeFromNetname(net)); v.SetLocked(True)
        board.Add(v)
    for net, lay, x1, y1, x2, y2, w in segs[n_pre_s:]:
        s = pcbnew.PCB_TRACK(board); s.SetStart(P(x1, y1)); s.SetEnd(P(x2, y2)); s.SetWidth(MM(w))
        s.SetLayer(pcbnew.F_Cu if lay == "F" else pcbnew.B_Cu); s.SetNetCode(board.GetNetcodeFromNetname(net)); s.SetLocked(True)
        board.Add(s)
    print("fanout: %d pads, %d vias (%d in-pad groups, %d shared stubs), failed: %s" %
          (len(todo), len(vias) - n_pre_v, stats["center"], stats["shared"], stats["failed"]))

def poly_zone(board, pts, layers, netname=None, keepout=False, name="", prio=0, clearance=0.25, minw=0.2):
    z = pcbnew.ZONE(board)
    ls = pcbnew.LSET()
    for l in layers: ls.AddLayer(l)
    z.SetLayerSet(ls)
    o = z.Outline(); o.NewOutline()
    for x, y in pts: o.Append(MM(OX + x), MM(OY + y))
    z.SetZoneName(name)
    if keepout:
        z.SetIsRuleArea(True)
        z.SetDoNotAllowCopperPour(True); z.SetDoNotAllowTracks(True); z.SetDoNotAllowVias(True)
        z.SetDoNotAllowPads(False); z.SetDoNotAllowFootprints(False)
    else:
        z.SetNetCode(board.GetNetcodeFromNetname(netname))
        z.SetAssignedPriority(prio)
        z.SetLocalClearance(MM(clearance)); z.SetMinThickness(MM(minw))
        z.SetPadConnection(pcbnew.ZONE_CONNECTION_THERMAL)
        z.SetThermalReliefGap(MM(0.25)); z.SetThermalReliefSpokeWidth(MM(0.3))
        z.SetIslandRemovalMode(pcbnew.ISLAND_REMOVAL_MODE_ALWAYS)
    board.Add(z)
    return z

ALL_CU = (pcbnew.F_Cu, pcbnew.In1_Cu, pcbnew.In2_Cu, pcbnew.B_Cu)
def rect(x1, y1, x2, y2):
    return [(x1, y1), (x2, y1), (x2, y2), (x1, y2)]

def add_rule_areas(board):
    f = pcbnew.ToMM
    poly_zone(board, rect(*ZB_ANT_KO), ALL_CU, keepout=True, name="KO_ZIGBEE_ANT")
    poly_zone(board, rect(*ZB_ANT_KO2), ALL_CU, keepout=True, name="KO_ZIGBEE_ANT_END")
    # CM4 on-board WiFi/BT antenna: CM4 datasheet fig. 4 "Wireless Cutout" = 6.5 x 11 mm on the short edge at the
    # pin 99/199 end, 10.5..21.5 mm from the long edge of the pin 1-100 connector -> board x 92.5..99.0, y 46.5..57.5.
    # "minimum 6.5 x 11 mm, ideally at least 8 x 15 mm": no copper on any layer in 9 x 15 mm, out to the board edge.
    poly_zone(board, rect(91.0, 44.5, 100.0, 59.5), ALL_CU, keepout=True, name="KO_CM4_ANT")
    # keep routed copper 0.45 mm away from the board edge (pads of edge connectors are still allowed)
    e = 0.45
    for i, r_ in enumerate((rect(0, 0, W, e), rect(0, H - e, W, H), rect(0, 0, e, H), rect(W - e, 0, W, H))):
        poly_zone(board, r_, ALL_CU, keepout=True, name="KO_EDGE%d" % i)
    u4 = [fp for fp in sorted_fps(board) if fp.GetReference() == "U4"]
    if u4:
        q = u4[0].GetPosition(); hx, hy = f(q.x) - OX, f(q.y) - OY
        for i, (x1, y1, x2, y2) in enumerate(((-2.52, -1.25, -1.86, 2.52), (-1.86, 1.86, -0.15, 2.52))):
            poly_zone(board, rect(hx + x1, hy + y1, hx + x2, hy + y2), (pcbnew.F_Cu,), keepout=True, name="KO_U4_CHANNEL%d" % i)
    rc = CORNER_R
    for i, (cx, cy, sx, sy) in enumerate(((rc, rc, -1, -1), (W - rc, rc, 1, -1), (W - rc, H - rc, 1, 1), (rc, H - rc, -1, 1))):
        arc = [(cx + sx * (rc - e) * math.cos(math.radians(a)), cy + sy * (rc - e) * math.sin(math.radians(a))) for a in range(0, 91, 10)]
        poly_zone(board, [(cx + sx * rc, cy), (cx + sx * rc, cy + sy * rc), (cx, cy + sy * rc)] + arc[::-1],
                  ALL_CU, keepout=True, name="KO_CORNER%d" % i)
    for fp in sorted_fps(board):
        ref = fp.GetReference()
        q = fp.GetPosition(); x, y = f(q.x) - OX, f(q.y) - OY
        if ref == "J1":
            poly_zone(board, rect(x - 3.75, y + 0.35, x + 3.75, y + 3.0), (pcbnew.F_Cu,), keepout=True, name="KO_J1_SHELL")
        if ref.startswith("FID"):          # fiducial: 2 mm mask opening must stay free of other copper
            poly_zone(board, rect(x - 1.2, y - 1.2, x + 1.2, y + 1.2), (pcbnew.F_Cu,), keepout=True, name="KO_" + ref)
        for pad in fp.Pads():              # non-plated slots/holes inside parts (LED light slots, mic ports)
            if pad.GetAttribute() == pcbnew.PAD_ATTRIB_NPTH and (ref.startswith("D") or ref.startswith("MK")):
                b = pad.GetBoundingBox()
                poly_zone(board, rect(f(b.GetLeft()) - OX - 0.3, f(b.GetTop()) - OY - 0.3, f(b.GetRight()) - OX + 0.3, f(b.GetBottom()) - OY + 0.3),
                          ALL_CU, keepout=True, name="KO_HOLE_" + ref)

def board_keepouts(board):
    f = pcbnew.ToMM
    out = []
    for z in list(board.Zones()) + [z for fp in sorted_fps(board) for z in fp.Zones()]:
        if z.GetIsRuleArea():
            b = z.GetBoundingBox()
            lays = ("F" if z.IsOnLayer(pcbnew.F_Cu) else "") + ("B" if z.IsOnLayer(pcbnew.B_Cu) else "")
            out.append((f(b.GetLeft()) - OX, f(b.GetTop()) - OY, f(b.GetRight()) - OX, f(b.GetBottom()) - OY, lays))
    return out

DF40_JOG, DF40_IN, DF40_OUT, DF40_HALF = 0.6, 0.75, 1.19, 0.1

def add_df40_strips(board):
    f = pcbnew.ToMM
    n_ko = n_own = 0
    for fp in sorted_fps(board):
        if "DF40C" not in str(fp.GetFPID().GetLibItemName()):
            continue
        if fp.GetOrientationDegrees() % 180 or fp.IsFlipped():
            raise SystemExit("add_df40_strips expects the CM4 sockets on the front side, unrotated")
        ref = fp.GetReference(); q0 = fp.GetPosition(); ccy = f(q0.y) - OY
        own = [(t.GetNetname(), f(t.GetStart().x) - OX, f(t.GetStart().y) - OY, f(t.GetEnd().x) - OX, f(t.GetEnd().y) - OY, f(t.GetWidth()))
               for t in board.GetTracks() if t.Type() != pcbnew.PCB_VIA_T and t.GetLayer() == pcbnew.F_Cu]
        for sgn in (-1, 1):
            row = sorted((f(p.GetPosition().x) - OX, p) for p in fp.Pads() if (f(p.GetPosition().y) - OY - ccy) * sgn > 0)
            y0, y1 = sorted((ccy + sgn * DF40_IN, ccy + sgn * DF40_OUT))
            run = []
            def flush():
                nonlocal n_ko
                if run:
                    poly_zone(board, rect(run[0] - DF40_HALF, y0, run[-1] + DF40_HALF, y1), (pcbnew.F_Cu,), keepout=True,
                              name="KO_DF40_%s_%d" % (ref, n_ko)); n_ko += 1
                    del run[:]
            for px, p in row:
                r_ = (px - DF40_HALF, y0, px + DF40_HALF, y1)
                if any(n == p.GetNetname() and _seg_rect(a, b, c, d, r_) < w / 2 for n, a, b, c, d, w in own):
                    n_own += 1; flush()
                else:
                    if run and px - run[-1] > 0.45: flush()
                    run.append(px)
            flush()
    print("DF40 strips: %d keep-out areas, %d strips used by the pad's own net" % (n_ko, n_own))

def add_planes(board):
    full = rect(0, 0, W, H)
    poly_zone(board, full, (pcbnew.In1_Cu,), "GND", name="GND_PLANE")
    poly_zone(board, full, (pcbnew.In2_Cu,), "+5V", name="5V_PLANE")
    poly_zone(board, full, (pcbnew.F_Cu,), "GND", name="GND_F")
    poly_zone(board, full, (pcbnew.B_Cu,), "GND", name="GND_B")

def finish(outdir):
    board = pcbnew.LoadBoard(os.path.join(outdir, "voxhub.kicad_pcb"))
    ses = os.path.join(outdir, "gen", "work", "voxhub.ses")
    if os.path.exists(ses):
        ok = pcbnew.ImportSpecctraSES(board, ses)
        print("SES import:", ok)
        if not ok:
            raise SystemExit("the autorouter session gen/work/voxhub.ses could not be imported")
    tracks = sorted_tracks(board); _KEEP.append(tracks)
    # the USB data lines are laid pad to pad through the ESD parts by the patch router (USB rules in patch());
    # whatever the autorouter drew for them is discarded
    n_usb = 0
    for i_, tr in enumerate(tracks):
        if tr.GetNetname() in NETCLASSES["USB"][2] and not tr.IsLocked():
            board.Remove(tr); _KEEP.append(tr); tracks[i_] = None; n_usb += 1
    tracks = [t for t in tracks if t is not None]
    print("autorouted USB items discarded:", n_usb)
    tracks = tidy_fanout(board, tracks)
    for tr in tracks:
        if tr.Type() != pcbnew.PCB_VIA_T and tr.GetWidth() < MM(0.1):
            tr.SetWidth(MM(0.1))
    print("dangling items removed:", cleanup(board, tracks))
    if not [z for z in board.Zones() if not z.GetIsRuleArea()]:
        add_planes(board)
    pcbnew.ZONE_FILLER(board).Fill(board.Zones())
    board.BuildConnectivity()
    board.Save(board.GetFileName()); write_project(outdir)
    print("unconnected:", board.GetConnectivity().GetUnconnectedCount(True))


# ---------------------------------------------------------------------------------------
# Patch router: completes whatever the autorouter left open.  For every net it computes the
# connected components (pads / tracks / vias; plane nets are joined through their vias) and
# joins them one by one with an A* search on a 0.05 mm grid (two layers, obstacles inflated
# by clearance).  If no free path exists it may rip up other routed tracks; the nets it
# breaks are re-joined in a later iteration.
# ---------------------------------------------------------------------------------------
def _geom(board, tracks):
    f = pcbnew.ToMM
    pads = []
    for fp in sorted_fps(board):
        for p in fp.Pads():
            th = p.GetAttribute() in (pcbnew.PAD_ATTRIB_PTH, pcbnew.PAD_ATTRIB_NPTH)
            if not th and not (p.IsOnLayer(pcbnew.F_Cu) or p.IsOnLayer(pcbnew.B_Cu)):
                continue
            b = p.GetBoundingBox(); q = p.GetPosition()
            pads.append(dict(net=p.GetNetname(), lay="*" if th else ("F" if p.IsOnLayer(pcbnew.F_Cu) else "B"),
                             bb=(f(b.GetLeft()) - OX, f(b.GetTop()) - OY, f(b.GetRight()) - OX, f(b.GetBottom()) - OY),
                             x=f(q.x) - OX, y=f(q.y) - OY, npth=p.GetAttribute() == pcbnew.PAD_ATTRIB_NPTH,
                             name=fp.GetReference() + "." + p.GetNumber()))
    items = []
    for i, tr in enumerate(tracks):
        if tr is None:
            continue
        fixed = tr.IsLocked() or tr.GetNetname() in PLANE_NETS
        if tr.Type() == pcbnew.PCB_VIA_T:
            q = tr.GetPosition()
            items.append(dict(i=i, kind="via", net=tr.GetNetname(), x=f(q.x) - OX, y=f(q.y) - OY, r=f(tr.GetWidth(pcbnew.F_Cu)) / 2, fixed=fixed))
        else:
            a, e = tr.GetStart(), tr.GetEnd()
            lay = "F" if tr.GetLayer() == pcbnew.F_Cu else ("B" if tr.GetLayer() == pcbnew.B_Cu else "?")
            items.append(dict(i=i, kind="seg", net=tr.GetNetname(), x1=f(a.x) - OX, y1=f(a.y) - OY, x2=f(e.x) - OX, y2=f(e.y) - OY,
                              hw=f(tr.GetWidth()) / 2, lay=lay, fixed=fixed))
    return pads, items

def _pt_seg(x, y, o):
    dx, dy = o["x2"] - o["x1"], o["y2"] - o["y1"]; L2 = dx * dx + dy * dy
    tt = 0.0 if L2 == 0 else min(1.0, max(0.0, ((x - o["x1"]) * dx + (y - o["y1"]) * dy) / L2))
    return math.hypot(x - (o["x1"] + tt * dx), y - (o["y1"] + tt * dy))

def _components(net, pads, items):
    """Union-find over the pads / segments / vias of one net.  Returns list of components,
    each a dict(pads=[...], pts=[(x, y, lay)...])."""
    np_ = [p for p in pads if p["net"] == net and not p["npth"]]
    ni = [o for o in items if o["net"] == net]
    n = len(np_) + len(ni)
    par = list(range(n))
    def find(a):
        while par[a] != a:
            par[a] = par[par[a]]; a = par[a]
        return a
    def uni(a, b): par[find(a)] = find(b)
    T = 0.005
    def inpad(p, x, y, lay): return p["lay"] in ("*", lay) and p["bb"][0] - T <= x <= p["bb"][2] + T and p["bb"][1] - T <= y <= p["bb"][3] + T
    plane = None
    for k, o in enumerate(ni):
        ko = len(np_) + k
        ends = [(o["x"], o["y"], "F"), (o["x"], o["y"], "B")] if o["kind"] == "via" else [(o["x1"], o["y1"], o["lay"]), (o["x2"], o["y2"], o["lay"])]
        for (x, y, lay) in ends:
            for j, p in enumerate(np_):
                if inpad(p, x, y, lay): uni(ko, j)
            for k2, o2 in enumerate(ni):
                if k2 == k: continue
                if o2["kind"] == "via":
                    if math.hypot(o2["x"] - x, o2["y"] - y) <= o2["r"] + T: uni(ko, len(np_) + k2)
                elif o2["lay"] == lay and _pt_seg(x, y, o2) <= o2["hw"] + T:
                    uni(ko, len(np_) + k2)
        if net in PLANE_NETS and o["kind"] == "via":       # all vias of a plane net meet in the plane
            if plane is None: plane = ko
            else: uni(ko, plane)
    if net in PLANE_NETS:
        for j, p in enumerate(np_):
            if p["lay"] == "*":
                if plane is None: plane = j
                else: uni(j, plane)
    comps = {}
    for j, p in enumerate(np_):
        c = comps.setdefault(find(j), dict(pads=[], pts=[], plane=False))
        c["pads"].append(p)
        for lay in (("F", "B") if p["lay"] == "*" else (p["lay"],)):
            c["pts"].append((p["x"], p["y"], lay))
    for k, o in enumerate(ni):
        r = find(len(np_) + k)
        if r not in comps: continue          # stray copper without a pad (cleanup removes it)
        c = comps[r]
        if o["kind"] == "via": c["pts"] += [(o["x"], o["y"], "F"), (o["x"], o["y"], "B")]
        else: c["pts"] += [(o["x1"], o["y1"], o["lay"]), (o["x2"], o["y2"], o["lay"])]
    if plane is not None and find(plane) in comps:
        comps[find(plane)]["plane"] = True
    return list(comps.values())

def patch(outdir, report=None, max_jobs=400, reroute=()):
    import heapq
    import numpy as np
    board = pcbnew.LoadBoard(os.path.join(outdir, "voxhub.kicad_pcb"))
    tracks = sorted_tracks(board); _KEEP.append(tracks)
    if reroute:          # rip the given nets completely; they are then re-joined below by shortest paths
        n_rip = 0
        for i_, tr in enumerate(tracks):
            if tr is not None and tr.GetNetname() in reroute and not tr.IsLocked():
                board.Remove(tr); _KEEP.append(tr); tracks[i_] = None; n_rip += 1
        print("  ripped %d items of %s for re-routing" % (n_rip, list(reroute)))
    cleanup(board, tracks)
    kos = board_keepouts(board)
    G = 0.05; VR = 0.25
    nets = sorted({p.GetNetname() for fp in sorted_fps(board) for p in fp.Pads() if p.GetNetname() and not p.GetNetname().startswith("unconnected-")})
    usb = set(NETCLASSES["USB"][2])
    # USB data lines first (they are the most constrained and nothing may rip them up later), then everything else
    queue = [n_ for n_ in reroute if n_ in nets] + [n_ for n_ in nets if n_ in usb and n_ not in reroute] \
          + [n_ for n_ in nets if n_ not in usb and n_ not in reroute]
    usb_started = set(reroute)      # USB nets whose remaining copper was already discarded in this run
    stats = dict(joined=0, failed=[], ripped=0)
    tries = {}
    jobs = 0
    protect = {}      # track index -> job number until which it may not be ripped up (stops A-rips-B-rips-A loops)
    while queue and jobs < max_jobs:
        net = queue.pop(0)
        pads, items = _geom(board, tracks)
        comps = _components(net, pads, items)
        if len(comps) < 2:
            continue
        jobs += 1
        # join the component with the fewest pads to its nearest neighbour
        # (USB: the hub side first - its way to the ESD pad is the tight one)
        comps.sort(key=lambda c: (c["plane"], len(c["pads"]),
                                  0 if net in usb and any(p_["name"].split(".")[0] == USB_HUB for p_ in c["pads"]) else 1))
        A = comps[0]
        def cdist(c):
            return min(math.hypot(a[0] - b[0], a[1] - b[1]) for a in A["pts"][:60] for b in c["pts"][:400])
        Bc = min(comps[1:], key=cdist)
        ap = A["pts"]
        # goals: the points of B closest to A (bounded), sources: all points of A
        bp = sorted(Bc["pts"], key=lambda b: min(math.hypot(a[0] - b[0], a[1] - b[1]) for a in ap[:60]))[:40]
        usb_ends = None      # USB data line: names of the only pads this join may touch
        if net in usb and net not in usb_started:
            # a broken USB line is laid again from scratch: joining on to left-over copper would create a stub
            usb_started.add(net)
            n_rip = 0
            for o in items:
                if o["net"] == net and not tracks[o["i"]].IsLocked():
                    board.Remove(tracks[o["i"]]); _KEEP.append(tracks[o["i"]]); tracks[o["i"]] = None; n_rip += 1
            if n_rip:
                print("  %s: %d left-over items discarded, line is laid again" % (net, n_rip))
                queue.insert(0, net); jobs -= 1
                continue
        if net in usb:
            # USB data lines are chained pad to pad: connector pin -> ESD pad -> (flow-through link) -> other ESD pad
            # -> hub pin, each side on its own ESD pad (ESD_ROLE).  Ending a track on an existing one, wiring hub and
            # connector to the same pad, or crossing the line's own copper would leave a stub or a loop and falsify
            # the length matching - such a join is refused instead.
            def is_esd(p_): return p_["name"].split(".")[0] in ESD_LINKS
            def padpts(pl):
                return [(p_["x"], p_["y"], l_) for p_ in pl for l_ in (("F", "B") if p_["lay"] == "*" else (p_["lay"],))]
            def used(p_):          # a routed (not locked) track of this net leaves the pad
                bb = p_["bb"]
                def inside(x, y): return bb[0] - 0.02 <= x <= bb[2] + 0.02 and bb[1] - 0.02 <= y <= bb[3] + 0.02
                for o in items:
                    if o["net"] != net or o["kind"] != "seg" or o["fixed"]: continue
                    if inside(o["x1"], o["y1"]) != inside(o["x2"], o["y2"]): return True
                return False
            goal_pads = Bc["pads"]; usb_fail = None
            if not any(is_esd(p_) for p_ in A["pads"]):
                with_esd = [c for c in comps[1:] if any(is_esd(p_) for p_ in c["pads"])]
                if with_esd:
                    Bc = min(with_esd, key=cdist)
                    role = "hub" if any(p_["name"].split(".")[0] == USB_HUB for p_ in A["pads"]) else "con"
                    goal_pads = [p_ for p_ in Bc["pads"] if is_esd(p_) and p_["name"].split(".")[1] in ESD_ROLE[p_["name"].split(".")[0]][role]]
                    if not goal_pads or any(used(p_) for p_ in goal_pads):
                        usb_fail = "%s-side ESD pad not available" % role
            elif len(A["pads"]) > 1:
                usb_fail = "open end is not a single pad"
            if usb_fail or not padpts(A["pads"]) or not padpts(goal_pads):
                tries[net] = 3; stats["failed"].append(net)
                print("  FAILED %s %s: %s" % (net, A["pads"][0]["name"] if A["pads"] else "?", usb_fail or "no pad to join"))
                continue
            ap = padpts(A["pads"])
            bp = sorted(padpts(goal_pads), key=lambda b: min(math.hypot(a[0] - b[0], a[1] - b[1]) for a in ap))
            usb_ends = {p_["name"] for p_ in A["pads"]} | {p_["name"] for p_ in goal_pads}
        power = net in NETCLASSES["Power"][2]
        done = False
        # (track width, clearance used for the search); the last entry is the tightest the board rules allow
        if net in usb:      # USB 2.0 data: 0.2 mm (about 45 ohm to the plane 0.1 mm below), stay on one layer if at all possible
            variants = ((0.2, 0.16), (0.2, 0.13))
        elif net in NETCLASSES["HV"][2]:
            variants = ((0.25, 0.23), (0.25, 0.21))
        elif power:
            variants = ((0.3, 0.18), (0.15, 0.18), (0.12, 0.165))
        else:
            variants = ((0.15, 0.15), (0.12, 0.13))
        via_cost = 400 if net in usb else 50
        for width, clr in variants:
            xs = [q[0] for q in ap + bp]; ys = [q[1] for q in ap + bp]
            m = 4.0 + 2.0 * tries.get(net, 0)
            x0, y0, x1, y1 = max(0.4, min(xs) - m), max(0.4, min(ys) - m), min(W - 0.4, max(xs) + m), min(H - 0.4, max(ys) + m)
            nx, ny = int((x1 - x0) / G) + 1, int((y1 - y0) / G) + 1
            XX, YY = np.meshgrid(x0 + np.arange(nx) * G, y0 + np.arange(ny) * G, indexing="ij")
            hard = [np.zeros((nx, ny), bool), np.zeros((nx, ny), bool)]
            hardv = np.zeros((nx, ny), bool)
            soft = [np.zeros((nx, ny), bool), np.zeros((nx, ny), bool)]
            softv = np.zeros((nx, ny), bool)
            free = [np.zeros((nx, ny), bool), np.zeros((nx, ny), bool)]
            own = [np.zeros((nx, ny), bool), np.zeros((nx, ny), bool)]      # USB only: the line's own copper (obstacle outside the end pads)
            absh = [np.zeros((nx, ny), bool), np.zeros((nx, ny), bool)]     # holes / keep-outs: never passable, even inside our own pad
            LI = {"F": 0, "B": 1}
            def box_idx(bx0, by0, bx1, by1):
                i0, i1 = max(0, int(math.ceil((bx0 - x0) / G))), min(nx, int(math.floor((bx1 - x0) / G)) + 1)
                j0, j1 = max(0, int(math.ceil((by0 - y0) / G))), min(ny, int(math.floor((by1 - y0) / G)) + 1)
                if i1 <= i0 or j1 <= j0:
                    return 0, 0, 0, 0            # empty (never let a negative stop index wrap around)
                return i0, i1, j0, j1
            for pd in pads:
                bb = pd["bb"]
                if bb[2] < x0 - 1 or bb[0] > x1 + 1 or bb[3] < y0 - 1 or bb[1] > y1 + 1: continue
                lays = (0, 1) if pd["lay"] == "*" else (LI[pd["lay"]],)
                if pd["net"] == net and not pd["npth"] and (usb_ends is None or pd["name"] in usb_ends):
                    i0, i1, j0, j1 = box_idx(*bb)
                    for L in lays: free[L][i0:i1, j0:j1] = True
                    if pd["lay"] != "*":                                  # no via in / half on our own SMD pad
                        i0, i1, j0, j1 = box_idx(bb[0] - VR, bb[1] - VR, bb[2] + VR, bb[3] + VR); hardv[i0:i1, j0:j1] = True
                    continue
                mrg = (0.3 if pd["npth"] else clr) + width / 2
                if usb_ends is not None and pd["net"] in usb and pd["name"].split(".")[0] in ESD_LINKS:
                    mrg += 0.45        # leave a lane next to the ESD pads this join does not use (partner line, other side)
                i0, i1, j0, j1 = box_idx(bb[0] - mrg, bb[1] - mrg, bb[2] + mrg, bb[3] + mrg)
                for L in lays: hard[L][i0:i1, j0:j1] = True
                if pd["npth"]:
                    for L in lays: absh[L][i0:i1, j0:j1] = True
                mv = (0.3 if pd["npth"] else 0.2) + VR
                i0, i1, j0, j1 = box_idx(bb[0] - mv, bb[1] - mv, bb[2] + mv, bb[3] + mv); hardv[i0:i1, j0:j1] = True
            for k in kos:
                i0, i1, j0, j1 = box_idx(k[0] - width / 2, k[1] - width / 2, k[2] + width / 2, k[3] + width / 2)
                for L in [LI[c] for c in k[4]]:
                    hard[L][i0:i1, j0:j1] = True; absh[L][i0:i1, j0:j1] = True
                i0, i1, j0, j1 = box_idx(k[0] - VR, k[1] - VR, k[2] + VR, k[3] + VR); hardv[i0:i1, j0:j1] = True
            for o in items:
                if o["kind"] == "via": ax, ay, bx, by, hw, lays = o["x"], o["y"], o["x"], o["y"], o["r"], (0, 1)
                else:
                    if o["lay"] not in LI: continue
                    ax, ay, bx, by, hw, lays = o["x1"], o["y1"], o["x2"], o["y2"], o["hw"], (LI[o["lay"]],)
                rr = hw + 0.2 + VR + 0.05
                if max(ax, bx) < x0 - rr or min(ax, bx) > x1 + rr or max(ay, by) < y0 - rr or min(ay, by) > y1 + rr: continue
                i0, i1, j0, j1 = box_idx(min(ax, bx) - rr, min(ay, by) - rr, max(ax, bx) + rr, max(ay, by) + rr)
                if i0 >= i1 or j0 >= j1: continue
                X_, Y_ = XX[i0:i1, j0:j1], YY[i0:i1, j0:j1]
                dx, dy = bx - ax, by - ay; L2 = dx * dx + dy * dy
                tt = np.clip(((X_ - ax) * dx + (Y_ - ay) * dy) / L2, 0, 1) if L2 > 0 else 0.0
                dist = np.hypot(X_ - (ax + tt * dx), Y_ - (ay + tt * dy))
                if o["net"] == net:
                    if usb_ends is not None:       # a USB line may meet its own copper only inside the two end pads
                        for L in lays: own[L][i0:i1, j0:j1] |= dist < hw + clr + width / 2
                        hardv[i0:i1, j0:j1] |= dist < hw + 0.2 + VR
                        continue
                    if o["kind"] == "via": hardv[i0:i1, j0:j1] |= dist < 0.62      # hole-to-hole for same-net vias
                    for L in lays: free[L][i0:i1, j0:j1] |= dist <= max(0.0, hw - width / 2)
                    continue
                tgt, tgtv = (hard, hardv) if (o["fixed"] or o["net"] in usb or protect.get(o["i"], 0) > jobs) else (soft, softv)
                for L in lays: tgt[L][i0:i1, j0:j1] |= dist < hw + clr + width / 2
                tgtv[i0:i1, j0:j1] |= dist < hw + 0.2 + VR
            for L in (0, 1): hard[L] |= own[L] & ~free[L]
            edge = 0.36 + width / 2
            em = (XX < edge) | (XX > W - edge) | (YY < edge) | (YY > H - edge)
            for L in (0, 1): hard[L] |= em & ~free[L]
            hardv |= (XX < 0.75) | (XX > W - 0.75) | (YY < 0.75) | (YY > H - 0.75)
            def cell(x, y): return (min(nx - 1, max(0, int(round((x - x0) / G)))), min(ny - 1, max(0, int(round((y - y0) / G)))))
            starts = {cell(q[0], q[1]) + (LI[q[2]],): q for q in ap if q[2] in LI}
            goals = {cell(q[0], q[1]) + (LI[q[2]],): q for q in bp if q[2] in LI}
            gl = list(goals)
            for (cx_, cy_, cl_) in list(starts) + gl: free[cl_][cx_, cy_] = True
            for L in (0, 1):
                keep = np.zeros((nx, ny), bool)
                for (cx_, cy_, cl_) in list(starts) + gl:
                    if cl_ == L: keep[cx_, cy_] = True
                free[L] &= ~absh[L] | keep
                hard[L] |= absh[L] & ~keep
            def h(c):
                return min(max(abs(c[0] - g[0]), abs(c[1] - g[1])) + 0.414 * min(abs(c[0] - g[0]), abs(c[1] - g[1])) for g in gl)
            found = None
            # USB data: rather move other tracks out of the way than change layer (a via pair on one line of a pair only)
            modes = ((False, False), (True, False), (False, True), (True, True)) if net in usb else ((False, True), (True, True))
            for ripup, allow_via in modes:
                openh = [(1.5 * h(s), 0.0, s, None) for s in starts]; heapq.heapify(openh)
                came = {}; best = {}; it = 0
                while openh and it < 3000000:
                    _, gsc, c, par_ = heapq.heappop(openh); it += 1
                    if c in came: continue
                    came[c] = par_
                    if c in goals: found = c; break
                    cx, cy, cl = c
                    hd, sf, fr = hard[cl], soft[cl], free[cl]
                    for dx, dy, cost in ((1, 0, 1), (-1, 0, 1), (0, 1, 1), (0, -1, 1), (1, 1, 1.414), (1, -1, 1.414), (-1, 1, 1.414), (-1, -1, 1.414)):
                        ux, uy = cx + dx, cy + dy
                        if not (0 <= ux < nx and 0 <= uy < ny): continue
                        if not fr[ux, uy]:
                            if hd[ux, uy]: continue
                            if sf[ux, uy]:
                                if not ripup: continue
                                cost += 40
                        n2 = (ux, uy, cl); g2 = gsc + cost
                        if n2 not in came and g2 < best.get(n2, 1e18):
                            best[n2] = g2; heapq.heappush(openh, (g2 + 1.5 * h(n2), g2, n2, c))
                    if allow_via and not hardv[cx, cy] and not hard[1 - cl][cx, cy] and not (hard[cl][cx, cy] and not free[cl][cx, cy]):
                        vc = via_cost
                        if softv[cx, cy] or soft[0][cx, cy] or soft[1][cx, cy]:
                            vc = via_cost + 200 if ripup else None
                        if vc is not None:
                            n2 = (cx, cy, 1 - cl); g2 = gsc + vc
                            if n2 not in came and g2 < best.get(n2, 1e18):
                                best[n2] = g2; heapq.heappush(openh, (g2 + 1.5 * h(n2), g2, n2, c))
                if found: break
            if not found:
                print("    no path for %s (w %.2f): searched %d cells, window %dx%d, starts %s goals %s" % (
                    net, width, len(came), nx, ny, [(round(q[0], 2), round(q[1], 2), q[2]) for q in list(starts.values())[:3]],
                    [(round(q[0], 2), round(q[1], 2), q[2]) for q in list(goals.values())[:3]]))
                continue
            path = []; c = found
            while c is not None: path.append(c); c = came[c]
            path.reverse()
            # string pulling: replace stair-steps by straight segments where the straight line is free
            def los(a, b):
                (ax, ay, al), (bx, by, bl) = a, b
                n = max(1, int(max(abs(bx - ax), abs(by - ay)) * 3))
                hd, sf, fr = hard[al], soft[al], free[al]
                for k in range(n + 1):
                    ix, iy = int(round(ax + (bx - ax) * k / n)), int(round(ay + (by - ay) * k / n))
                    if not fr[ix, iy] and (hd[ix, iy] or sf[ix, iy]): return False
                return True
            sm = [path[0]]; i = 0
            while i < len(path) - 1:
                j = i + 1
                if path[j][2] == path[i][2]:
                    k = j
                    while k + 1 < len(path) and path[k + 1][2] == path[i][2] and k - i < 400:
                        k += 1
                        if los(path[i], path[k]): j = k
                sm.append(path[j]); i = j
            pts = [(x0 + c[0] * G, y0 + c[1] * G, c[2]) for c in sm]
            s_exact, g_exact = starts[path[0]], goals[found]
            if os.environ.get("PATCH_DEBUG"):
                print("    DEBUG", net, "start", s_exact, "goal", g_exact, "cells", len(path), "sm", [(round(x0 + c[0] * G, 2), round(y0 + c[1] * G, 2), c[2]) for c in sm])
            pts = [(s_exact[0], s_exact[1], pts[0][2])] + pts + [(g_exact[0], g_exact[1], pts[-1][2])]
            # victims: every rippable item the new copper comes too close to (exact geometry)
            dense = [(x0 + c[0] * G, y0 + c[1] * G, c[2]) for c in path]
            newv = [pts[k] for k in range(1, len(pts)) if pts[k][2] != pts[k - 1][2]]
            victims, bad = [], False
            for o in items:
                if o["net"] == net: continue
                hit = False
                if o["kind"] == "via":
                    for (px_, py_, pl_) in dense:
                        if not free[pl_][cell(px_, py_)] and math.hypot(o["x"] - px_, o["y"] - py_) < o["r"] + clr + width / 2 - 0.03: hit = True; break
                    if not hit and any(math.hypot(o["x"] - v[0], o["y"] - v[1]) < o["r"] + VR + 0.18 for v in newv): hit = True
                else:
                    if o["lay"] not in LI: continue
                    if max(o["x1"], o["x2"]) < x0 or min(o["x1"], o["x2"]) > x1 or max(o["y1"], o["y2"]) < y0 or min(o["y1"], o["y2"]) > y1: continue
                    li = LI[o["lay"]]
                    for (px_, py_, pl_) in dense:
                        if pl_ == li and not free[pl_][cell(px_, py_)] and _pt_seg(px_, py_, o) < o["hw"] + clr + width / 2 - 0.03: hit = True; break
                    if not hit and any(_pt_seg(v[0], v[1], o) < o["hw"] + VR + 0.18 for v in newv): hit = True
                if hit:
                    if o["fixed"] or o["net"] in usb or protect.get(o["i"], 0) > jobs: bad = True; break
                    victims.append(o)
            if bad:
                continue
            for o in victims:
                board.Remove(tracks[o["i"]]); _KEEP.append(tracks[o["i"]]); tracks[o["i"]] = None
            code = board.GetNetcodeFromNetname(net)
            n_before = len(tracks)
            for a, b_ in zip(pts, pts[1:]):
                if a[2] != b_[2]:
                    v = pcbnew.PCB_VIA(board); v.SetPosition(P(a[0], a[1])); v.SetWidth(pcbnew.F_Cu, MM(0.5)); v.SetDrill(MM(VIA_DRILL))
                    v.SetViaType(pcbnew.VIATYPE_THROUGH); v.SetLayerPair(pcbnew.F_Cu, pcbnew.B_Cu); v.SetNetCode(code); board.Add(v); tracks.append(v)
                elif math.hypot(a[0] - b_[0], a[1] - b_[1]) > 1e-6:
                    s = pcbnew.PCB_TRACK(board); s.SetStart(P(a[0], a[1])); s.SetEnd(P(b_[0], b_[1])); s.SetWidth(MM(width))
                    s.SetLayer(pcbnew.F_Cu if a[2] == 0 else pcbnew.B_Cu); s.SetNetCode(code); board.Add(s); tracks.append(s)
            if victims:
                for ti in range(n_before, len(tracks)): protect[ti] = jobs + 12
            stats["joined"] += 1; stats["ripped"] += len(victims)
            vn = sorted({o["net"] for o in victims})
            print("  joined %-12s %s -> %s  (%d segments, w %.2f%s)" % (net, A["pads"][0]["name"], Bc["pads"][0]["name"] if Bc["pads"] else "?",
                  len(pts) - 1, width, (", ripped %d of %s" % (len(victims), vn)) if victims else ""))
            if victims:
                cleanup(board, tracks)
                for v_ in vn:
                    if v_ not in queue: queue.append(v_)
            done = True
            break
        if done:
            queue.insert(0, net)        # the net may have more components
        else:
            tries[net] = tries.get(net, 0) + 1
            if tries[net] < 3: queue.append(net)
            else:
                stats["failed"].append(net); print("  FAILED", net, A["pads"][0]["name"])
    rm = cleanup(board, tracks)
    pcbnew.ZONE_FILLER(board).Fill(board.Zones())
    board.BuildConnectivity()
    board.Save(board.GetFileName()); write_project(outdir)
    print("patch: joined %d, ripped %d, failed %s, dangling removed %d; KiCad unconnected: %d" % (
        stats["joined"], stats["ripped"], sorted(set(stats["failed"])), rm, board.GetConnectivity().GetUnconnectedCount(True)))

_KEEP = []   # keep removed SWIG wrappers alive (their destruction confuses pcbnew's type map)

def cleanup(board, tracks):
    """Remove dangling track stubs and vias (left over by the autorouter or by rip-up).
    Works on plain Python copies of the geometry and deletes the board items in one go.
    `tracks` is the caller's list of track objects (None entries = already removed)."""
    f = pcbnew.ToMM
    pads = {}
    for fp in sorted_fps(board):
        for p in fp.Pads():
            if p.GetNetname():
                b = p.GetBoundingBox()
                th = p.GetAttribute() == pcbnew.PAD_ATTRIB_PTH
                lay = "*" if th else ("F" if p.IsOnLayer(pcbnew.F_Cu) else "B")
                pads.setdefault(p.GetNetname(), []).append((f(b.GetLeft()), f(b.GetTop()), f(b.GetRight()), f(b.GetBottom()), lay))
    items = {}     # net -> list of dicts
    for tr in tracks:
        if tr is None: continue
        d = dict(obj=tr, locked=tr.IsLocked(), alive=True)
        if tr.Type() == pcbnew.PCB_VIA_T:
            q = tr.GetPosition()
            d.update(kind="via", x=f(q.x), y=f(q.y), r=f(tr.GetWidth(pcbnew.F_Cu)) / 2)
        else:
            a, e = tr.GetStart(), tr.GetEnd()
            d.update(kind="seg", x1=f(a.x), y1=f(a.y), x2=f(e.x), y2=f(e.y), hw=f(tr.GetWidth()) / 2,
                     lay="F" if tr.GetLayer() == pcbnew.F_Cu else "B")
        items.setdefault(tr.GetNetname(), []).append(d)
    dead = []
    trimmed = [0]
    ox_ = oy_ = 0.0      # geometry here is in absolute KiCad coordinates
    for net, its in items.items():      # exact duplicates (same net, layer, width, end points): keep one, a locked one if any
        seen = {}
        for o in its:
            if o["kind"] != "seg": continue
            k_ = (o["lay"], round(o["hw"], 4)) + tuple(sorted(((round(o["x1"], 4), round(o["y1"], 4)), (round(o["x2"], 4), round(o["y2"], 4)))))
            if k_ not in seen: seen[k_] = o; continue
            drop = o
            if o["locked"] and not seen[k_]["locked"]: drop, seen[k_] = seen[k_], o
            if not drop["locked"]: drop["alive"] = False; dead.append(drop["obj"])
    for net, its in items.items():
        def touches(x, y, lay, me):
            for bb in pads.get(net, ()):
                if bb[4] in ("*", lay) and bb[0] - 0.02 <= x <= bb[2] + 0.02 and bb[1] - 0.02 <= y <= bb[3] + 0.02:
                    return True
            for o in its:
                if o is me or not o["alive"]:
                    continue
                if o["kind"] == "via":
                    if math.hypot(o["x"] - x, o["y"] - y) <= o["r"] + 0.01:
                        return True
                elif o["lay"] == lay:
                    if abs((o["x1"] + o["x2"]) / 2 - x) > abs(o["x2"] - o["x1"]) / 2 + 0.5 or abs((o["y1"] + o["y2"]) / 2 - y) > abs(o["y2"] - o["y1"]) / 2 + 0.5:
                        continue
                    dx, dy = o["x2"] - o["x1"], o["y2"] - o["y1"]; L2 = dx * dx + dy * dy
                    tt = 0.0 if L2 == 0 else min(1.0, max(0.0, ((x - o["x1"]) * dx + (y - o["y1"]) * dy) / L2))
                    if math.hypot(x - (o["x1"] + tt * dx), y - (o["y1"] + tt * dy)) <= o["hw"] + 0.02:
                        return True
            return False
        def junction(o, fx, fy, cx_, cy_):
            """Farthest point (from the connected end cx_,cy_) at which another item of the net meets segment o."""
            best = None
            for q in its:
                if q is o or not q["alive"]: continue
                cand = [(q["x"], q["y"])] if q["kind"] == "via" else ([(q["x1"], q["y1"]), (q["x2"], q["y2"])] if q["lay"] == o["lay"] else [])
                for (px, py) in cand:
                    if _pt_seg(px, py, o) <= 0.01:
                        d_ = math.hypot(px - cx_, py - cy_)
                        if d_ > 0.02 and (best is None or d_ > best[0]): best = (d_, px, py)
            return best
        changed = True
        while changed:
            changed = False
            for o in its:
                if not o["alive"] or o["locked"]:
                    continue
                if o["kind"] == "seg":
                    t1, t2 = touches(o["x1"], o["y1"], o["lay"], o), touches(o["x2"], o["y2"], o["lay"], o)
                    if t1 != t2:      # exactly one free end: try to trim back to the last junction
                        j = junction(o, 0, 0, o["x1"], o["y1"]) if t1 else junction(o, 0, 0, o["x2"], o["y2"])
                        if j is not None:
                            if t1:
                                o["x2"], o["y2"] = j[1], j[2]; o["obj"].SetEnd(pcbnew.VECTOR2I(MM(j[1] + ox_), MM(j[2] + oy_)))
                            else:
                                o["x1"], o["y1"] = j[1], j[2]; o["obj"].SetStart(pcbnew.VECTOR2I(MM(j[1] + ox_), MM(j[2] + oy_)))
                            trimmed[0] += 1; changed = True
                            continue
                    bad = not t1 or not t2
                else:
                    bad = net not in PLANE_NETS and not (touches(o["x"], o["y"], "F", o) and touches(o["x"], o["y"], "B", o))
                if bad:
                    o["alive"] = False; dead.append(o["obj"]); changed = True
    for o in dead:
        board.Remove(o); _KEEP.append(o)
        for i_, x_ in enumerate(tracks):
            if x_ is o: tracks[i_] = None
    return len(dead)


def repair(outdir, report):
    """DRC-driven repair: delete (unlocked) routed items that take part in an error; the
    affected connections are re-routed by the next patch round."""
    import re
    board = pcbnew.LoadBoard(os.path.join(outdir, "voxhub.kicad_pcb"))
    f = pcbnew.ToMM
    tracks = sorted_tracks(board); _KEEP.append(tracks)
    txt = open(report).read()
    kinds = ("clearance", "shorting_items", "tracks_crossing", "hole_clearance", "hole_to_hole", "copper_edge_clearance",
             "track_dangling", "via_dangling", "items_not_allowed", "solder_mask_bridge", "track_width")
    gone = set()
    def find(desc, x, y):
        m = re.match(r"(Track|Via) \[([^\]]+)\]", desc)
        if not m: return None
        best = None
        ml = re.search(r"length ([\d.]+) mm", desc)
        want_len = float(ml.group(1)) if ml else None
        for i, tr in enumerate(tracks):
            if tr is None or i in gone or tr.GetNetname() != m.group(2) or tr.IsLocked(): continue
            isvia = tr.Type() == pcbnew.PCB_VIA_T
            if isvia != (m.group(1) == "Via"): continue
            if isvia:
                q = tr.GetPosition(); d = math.hypot(f(q.x) - x, f(q.y) - y)
            else:
                a, e = tr.GetStart(), tr.GetEnd()
                d = _seg_rect(f(a.x), f(a.y), f(e.x), f(e.y), (x, y, x, y))
                if want_len is not None and d < 0.6 and abs(f(tr.GetLength()) - want_len) > 0.002:
                    d += 0.3
            if best is None or d < best[0]: best = (d, i)
        return best[1] if best and best[0] < 0.9 else None
    n = 0
    for blk in re.split(r"\n(?=\[)", txt):
        m = re.match(r"\[(\w+)\]", blk)
        if not m or m.group(1) not in kinds: continue
        its = re.findall(r"@\(([\d.]+) mm, ([\d.]+) mm\): (.*)", blk)
        cands = []
        for x, y, desc in its:
            i = find(desc, float(x), float(y))
            if i is not None and not tracks[i].IsLocked() and tracks[i].GetNetname() not in PLANE_NETS:
                cands.append(i)
        if cands:
            i = cands[-1]
            board.Remove(tracks[i]); _KEEP.append(tracks[i]); gone.add(i); tracks[i] = None; n += 1
    n += prune_escapes(board, tracks)
    rm = cleanup(board, tracks)
    pcbnew.ZONE_FILLER(board).Fill(board.Zones()); board.BuildConnectivity()
    board.Save(board.GetFileName()); write_project(outdir)
    print("repair: removed %d offending items + %d dangling; unconnected now: %d" % (n, rm, board.GetConnectivity().GetUnconnectedCount(True)))

# ---------------------------------------------------------------------------------------
# USB 2.0 pairs: electrical (pad-to-pad) length, flow-through ESD links, serpentine length matching
# ---------------------------------------------------------------------------------------
VIA_LEN = 1.5          # path length counted for one F.Cu <-> B.Cu via (1.6 mm board minus the outer copper)
# (positive net, negative net, pin that drives/receives at the hub, far-end connector)
USB_PAIRS = (("USB_UP_P", "USB_UP_N", "U4", "J3"), ("USB1_P", "USB1_N", "U4", "J6"), ("USB2_P", "USB2_N", "U4", "J6"))
ESD_LINKS = {"U7": (("1", "6"), ("3", "4")), "U8": (("1", "6"), ("3", "4"))}     # USBLC6-2SC6: both pads of one I/O
USB_HUB = "U4"
# which pad of each ESD pair the hub side and the connector side use: with the placement above (FIXED) pads 6 / 4 are
# the row that faces the hub and pads 1 / 3 the row that faces the connector.
ESD_ROLE = {"U7": {"hub": ("6", "4"), "con": ("1", "3")}, "U8": {"hub": ("6", "4"), "con": ("1", "3")}}
USB_SKEW_LIMIT = 3.8   # mm (150 mil), the usual USB 2.0 high-speed intra-pair guideline
TUNE_TOL = 0.25        # mm: pairs closer than this are left alone
MEANDER = dict(s=0.6, c=0.15, a_min=0.30, a_max=3.0, margin=0.40, clr=0.17, clr_same=0.40)

def add_esd_links(board, tracks):
    """USBLC6-2SC6 has two pads per data line (1+6, 3+4).  Join them with a locked straight track under the
    package (ST's flow-through layout) so that the line passes *through* the protection device instead of
    reaching the second pad over a separate, long stub."""
    n = 0
    for ref, pairs in sorted(ESD_LINKS.items()):
        fp = board.FindFootprintByReference(ref)
        if fp is None: continue
        pad = {p.GetNumber(): p for p in fp.Pads()}
        for a, b in pairs:
            pa, pb = pad[a], pad[b]
            if pa.GetNetname() != pb.GetNetname() or not pa.GetNetname(): continue
            qa, qb = pa.GetPosition(), pb.GetPosition()
            dup = False
            for tr in tracks:
                if tr is not None and tr.Type() != pcbnew.PCB_VIA_T and tr.IsLocked() and tr.GetNetname() == pa.GetNetname():
                    e1, e2 = tr.GetStart(), tr.GetEnd()
                    if {(e1.x, e1.y), (e2.x, e2.y)} == {(qa.x, qa.y), (qb.x, qb.y)}: dup = True
            if dup: continue
            t = pcbnew.PCB_TRACK(board); t.SetStart(qa); t.SetEnd(qb); t.SetWidth(MM(0.2)); t.SetLayer(pcbnew.F_Cu)
            t.SetNetCode(pa.GetNetCode()); t.SetLocked(True); board.Add(t); tracks.append(t); n += 1
    print("ESD flow-through links added:", n)

def _seg_cross(a, b):
    """Intersection point of two track centre lines (None if they do not meet)."""
    x1, y1, x2, y2, x3, y3, x4, y4 = a["x1"], a["y1"], a["x2"], a["y2"], b["x1"], b["y1"], b["x2"], b["y2"]
    den = (x2 - x1) * (y4 - y3) - (y2 - y1) * (x4 - x3)
    if abs(den) < 1e-12: return None
    t = ((x3 - x1) * (y4 - y3) - (y3 - y1) * (x4 - x3)) / den
    u = ((x3 - x1) * (y2 - y1) - (y3 - y1) * (x2 - x1)) / den
    if -1e-9 <= t <= 1 + 1e-9 and -1e-9 <= u <= 1 + 1e-9: return (x1 + t * (x2 - x1), y1 + t * (y2 - y1))
    return None

def _clip_seg(o, bb, g):
    """Part of track o (as a (t1, t2) interval in mm along the track) that lies inside rectangle bb grown by g."""
    dx, dy = o["x2"] - o["x1"], o["y2"] - o["y1"]; L = math.hypot(dx, dy)
    if L < 1e-9: return None
    t1, t2 = 0.0, 1.0
    for p_, q_ in ((-dx, o["x1"] - (bb[0] - g)), (dx, (bb[2] + g) - o["x1"]), (-dy, o["y1"] - (bb[1] - g)), (dy, (bb[3] + g) - o["y1"])):
        if abs(p_) < 1e-12:
            if q_ < 0: return None
            continue
        r_ = q_ / p_
        if p_ < 0: t1 = max(t1, r_)
        else: t2 = min(t2, r_)
    return (t1 * L, t2 * L) if t1 <= t2 else None

def _net_graph(net, pads, items):
    """Copper graph of one net.  Nodes: track end points / junctions (x, y, layer) and pads ("pad", name).
    Edges: (other node, length, tag) with tag = ("seg", track index, t1, t2) for a piece of a track.

    Two pieces of copper are joined wherever they really touch, not only where a track ends on something:
    centre lines that cross, a track that runs over a pad or through a via land, track ends whose round caps
    overlap another track.  (Revision A1 first shipped with an end-point-only graph; it missed a track that
    crossed its own net next to an ESD pad and reported the long way round a 4.9 mm loop as the path.)"""
    T = 0.02
    segs = [o for o in items if o["net"] == net and o["kind"] == "seg" and o["lay"] in ("F", "B")]
    vias = [o for o in items if o["net"] == net and o["kind"] == "via"]
    adj = {}
    def edge(a, b, w, tag=None):
        if a == b: return
        adj.setdefault(a, []).append((b, w, tag)); adj.setdefault(b, []).append((a, w, tag))
    def key(x, y, lay): return (round(x, 3), round(y, 3), lay)
    pts = {"F": [], "B": []}           # (x, y, radius of the copper around the point)
    for o in segs:
        pts[o["lay"]] += [(o["x1"], o["y1"], o["hw"]), (o["x2"], o["y2"], o["hw"])]
    for lay in "FB":                   # centre lines crossing away from their end points
        ls = [o for o in segs if o["lay"] == lay]
        for i_ in range(len(ls)):
            for j_ in range(i_ + 1, len(ls)):
                q = _seg_cross(ls[i_], ls[j_])
                if q: pts[lay].append((q[0], q[1], 0.0))
    for v in vias:
        edge(key(v["x"], v["y"], "F"), key(v["x"], v["y"], "B"), VIA_LEN, ("via", v["i"]))
        for lay in "FB":
            for (px, py, pr) in pts[lay]:       # track ends (round caps) on the via land
                d = math.hypot(px - v["x"], py - v["y"])
                if 1e-4 < d <= v["r"] + max(T, pr - 0.005): edge(key(px, py, lay), key(v["x"], v["y"], lay), d, ("hop",))
    for v in vias:
        for lay in "FB": pts[lay].append((v["x"], v["y"], v["r"]))
    padhit = {}                        # track index -> [(t, x, y, pad name, distance to the pad centre)]
    for p in pads:
        if p["net"] != net or p["npth"]: continue
        for o in segs:
            if p["lay"] not in ("*", o["lay"]): continue
            c = _clip_seg(o, p["bb"], o["hw"] - 0.005)
            if c is None: continue
            dx, dy = o["x2"] - o["x1"], o["y2"] - o["y1"]; L = math.hypot(dx, dy)
            t = min(c[1], max(c[0], ((p["x"] - o["x1"]) * dx + (p["y"] - o["y1"]) * dy) / L))
            qx, qy = o["x1"] + dx * t / L, o["y1"] + dy * t / L
            padhit.setdefault(o["i"], []).append((t, qx, qy, p["name"], math.hypot(qx - p["x"], qy - p["y"])))
    for o in segs:
        dx, dy = o["x2"] - o["x1"], o["y2"] - o["y1"]; L = math.hypot(dx, dy)
        if L < 1e-6:
            edge(key(o["x1"], o["y1"], o["lay"]), key(o["x2"], o["y2"], o["lay"]), 0.0); continue
        on = {0.0: (o["x1"], o["y1"]), L: (o["x2"], o["y2"])}
        for (px, py, pr) in pts[o["lay"]]:
            t = ((px - o["x1"]) * dx + (py - o["y1"]) * dy) / L
            if T < t < L - T:
                qx, qy = o["x1"] + dx * t / L, o["y1"] + dy * t / L
                d = math.hypot(px - qx, py - qy)
                if d <= o["hw"] + max(T, pr - 0.005):
                    on[t] = (qx, qy); edge(key(px, py, o["lay"]), key(qx, qy, o["lay"]), d, ("hop",))
            else:
                for (ex, ey) in ((o["x1"], o["y1"]), (o["x2"], o["y2"])):
                    d = math.hypot(px - ex, py - ey)
                    if d <= max(T, o["hw"] + pr - 0.005): edge(key(px, py, o["lay"]), key(ex, ey, o["lay"]), d, ("hop",))
        for (t, qx, qy, name, d) in padhit.get(o["i"], ()):
            tk = t if T < t < L - T else (0.0 if t <= T else L)
            if tk == t: on[t] = (qx, qy)
            edge(("pad", name), key(*on[tk], o["lay"]), d, ("hop",))
        ts = sorted(on)
        for t1, t2 in zip(ts, ts[1:]):
            edge(key(*on[t1], o["lay"]), key(*on[t2], o["lay"]), t2 - t1, ("seg", o["i"], t1, t2))
    for p in pads:
        if p["net"] != net or p["npth"]: continue
        for lay in (("F", "B") if p["lay"] == "*" else (p["lay"],)):
            for (px, py, pr) in pts[lay]:
                if p["bb"][0] - T <= px <= p["bb"][2] + T and p["bb"][1] - T <= py <= p["bb"][3] + T:
                    edge(("pad", p["name"]), key(px, py, lay), math.hypot(px - p["x"], py - p["y"]), ("hop",))
    return adj

def _net_path(net, pads, items, ref_a, ref_b):
    """Shortest copper path between the pad of `net` on ref_a and the one on ref_b.
    Returns (length incl. vias, number of vias, [edge tags]) or None."""
    import heapq
    adj = _net_graph(net, pads, items)
    def pad_of(ref):
        c = sorted(k for k in adj if k[0] == "pad" and k[1].split(".")[0] == ref)
        return c[0] if c else None
    a, b = pad_of(ref_a), pad_of(ref_b)
    if a is None or b is None: return None
    dist = {a: 0.0}; prev = {}; pq = [(0.0, 0, a)]; cnt = 1; seen = set()
    while pq:
        d, _, u = heapq.heappop(pq)
        if u in seen: continue
        seen.add(u)
        if u == b: break
        for (v, w, tag) in adj.get(u, ()):
            nd = d + w
            if nd < dist.get(v, 1e18):
                dist[v] = nd; prev[v] = (u, tag); heapq.heappush(pq, (nd, cnt, v)); cnt += 1
    if b not in seen: return None
    tags = []; u = b; nodes = [b]
    while u != a:
        v = u; u, tag = prev[u]
        if tag: tags.append(tag if tag[0] != "hop" else ("hop", dist[v] - dist[u]))
        nodes.append(u)
    through = []        # pads the path runs through, hub end first
    mine = [p for p in pads if p["net"] == net and not p["npth"]]
    for nd in nodes[::-1]:
        name = nd[1] if nd[0] == "pad" else next((p["name"] for p in mine if p["lay"] in ("*", nd[2])
               and p["bb"][0] - 0.02 <= nd[0] <= p["bb"][2] + 0.02 and p["bb"][1] - 0.02 <= nd[1] <= p["bb"][3] + 0.02), None)
        if name and (not through or through[-1] != name): through.append(name)
    return dist[b], sum(1 for t in tags if t[0] == "via"), tags, through

def usb_report(board, tracks=None):
    """Per USB pair: pad-to-pad electrical length of both lines and their difference (skew), plus the copper of
    each net that is NOT on that path (stubs, loops, fragments) - a flow-through line has none."""
    tracks = tracks if tracks is not None else sorted_tracks(board)
    pads, items = _geom(board, tracks)
    rep = []
    for (pn, nn, ra, rb) in USB_PAIRS:
        row = dict(nets=(pn, nn))
        for k, net in (("p", pn), ("n", nn)):
            r = _net_path(net, pads, items, ra, rb)
            seen = set(); cu = 0.0
            for o in items:
                if o["net"] != net or o["kind"] != "seg": continue
                e = tuple(sorted(((round(o["x1"], 4), round(o["y1"], 4)), (round(o["x2"], 4), round(o["y2"], 4))))) + (o["lay"],)
                if e in seen: continue                    # the same piece of copper drawn twice
                seen.add(e); cu += math.hypot(o["x2"] - o["x1"], o["y2"] - o["y1"])
            on = sum(t[3] - t[2] for t in r[2] if t[0] == "seg") if r else 0.0
            hop = sum(t[1] for t in r[2] if t[0] == "hop") if r else 0.0     # bridged inside a pad / via land / overlap
            row[k] = dict(path=r[0] if r else float("nan"), vias=r[1] if r else 0, tags=r[2] if r else [], copper=cu,
                          onpath=on + hop, offpath=max(0.0, cu - on - hop) if r else float("nan"), through=r[3] if r else [],
                          nvias=sum(1 for o in items if o["net"] == net and o["kind"] == "via"))
        row["skew"] = abs(row["p"]["path"] - row["n"]["path"])
        # the same without any allowance for vias: the real figure lies between the two
        row["skew0"] = abs((row["p"]["path"] - VIA_LEN * row["p"]["vias"]) - (row["n"]["path"] - VIA_LEN * row["n"]["vias"]))
        row["offpath"] = max(row["p"]["offpath"], row["n"]["offpath"])
        rep.append(row)
    return rep, pads, items

def _merge_collinear(board, tracks, nets):
    """The patch router leaves straight runs as chains of short collinear segments.  Merge every chain whose inner
    points are plain 2-way joints (no via, pad, or third track) into one track.  Returns the number of merges."""
    f = pcbnew.ToMM
    n_merged = 0
    again = True
    while again:
        again = False
        ends = {}          # (net, layer, x, y) -> [track index]
        for i, tr in enumerate(tracks):
            if tr is None or tr.GetNetname() not in nets: continue
            if tr.Type() == pcbnew.PCB_VIA_T:
                q = tr.GetPosition()
                for lay in (pcbnew.F_Cu, pcbnew.B_Cu): ends.setdefault((tr.GetNetname(), lay, q.x, q.y), []).append(-1)
                continue
            for q in (tr.GetStart(), tr.GetEnd()):
                ends.setdefault((tr.GetNetname(), tr.GetLayer(), q.x, q.y), []).append(i)
        padpos = set()
        for fp in board.GetFootprints():
            for p in fp.Pads():
                if p.GetNetname() in nets:
                    q = p.GetPosition(); padpos.add((p.GetNetname(), q.x, q.y))
        for key, lst in sorted(ends.items()):
            if len(lst) != 2 or -1 in lst or lst[0] == lst[1] or (key[0], key[2], key[3]) in padpos: continue
            a, b = tracks[lst[0]], tracks[lst[1]]
            if a is None or b is None or a.IsLocked() or b.IsLocked() or a.GetWidth() != b.GetWidth(): continue
            j = pcbnew.VECTOR2I(key[2], key[3])
            pa = a.GetEnd() if (a.GetStart().x, a.GetStart().y) == (key[2], key[3]) else a.GetStart()
            pb = b.GetEnd() if (b.GetStart().x, b.GetStart().y) == (key[2], key[3]) else b.GetStart()
            v1 = (j.x - pa.x, j.y - pa.y); v2 = (pb.x - j.x, pb.y - j.y)
            l1, l2 = math.hypot(*v1), math.hypot(*v2)
            if l1 == 0 or l2 == 0: continue
            cross = (v1[0] * v2[1] - v1[1] * v2[0]) / (l1 * l2); dot = (v1[0] * v2[0] + v1[1] * v2[1]) / (l1 * l2)
            # the joint may be off the straight line pa-pb by at most 2 um
            dev = abs(v1[0] * (pb.y - pa.y) - v1[1] * (pb.x - pa.x)) / max(1.0, math.hypot(pb.x - pa.x, pb.y - pa.y))
            if dot <= 0 or dev > 2000: continue
            a.SetStart(pa); a.SetEnd(pb)
            board.Remove(b); _KEEP.append(b); tracks[lst[1]] = None
            n_merged += 1; again = True
            break
    return n_merged

def tune_usb(outdir):
    """Serpentine length matching: add 45-degree-mitred meander bumps to the shorter line of every USB pair
    until the pad-to-pad lengths agree.  Bumps are only placed where the copper keeps its clearance."""
    import numpy as np
    M = MEANDER; s_, c_, hw = M["s"], M["c"], 0.1
    K = (8 - 4 * math.sqrt(2)) * c_                    # a bump of amplitude a adds 2a - K
    board = pcbnew.LoadBoard(os.path.join(outdir, "voxhub.kicad_pcb"))
    tracks = sorted_tracks(board); _KEEP.append(tracks)
    kos = board_keepouts(board)
    changed = _merge_collinear(board, tracks, set(NETCLASSES["USB"][2])) > 0
    for pi in range(len(USB_PAIRS)):
        rep, pads, items = usb_report(board, tracks)
        row = rep[pi]
        if row["skew"] != row["skew"]:
            print("tune: %s/%s not fully routed - skipped" % row["nets"]); continue
        short = "p" if row["p"]["path"] < row["n"]["path"] else "n"
        net = row["nets"][0 if short == "p" else 1]
        need = row["skew"]
        if need <= TUNE_TOL:
            print("tune: %-8s/%-8s skew %.2f mm - ok" % (row["nets"] + (need,))); continue
        # on-path intervals per track
        iv = {}
        for tag in row[short]["tags"]:
            if tag[0] == "seg": iv.setdefault(tag[1], []).append((tag[2], tag[3]))
        byi = {o["i"]: o for o in items}
        slots = []        # (A_max, track index, side, t_start)
        for ti, ivs in sorted(iv.items()):
            o = byi[ti]
            ivs.sort(); merged = [list(ivs[0])]
            for a_, b_ in ivs[1:]:
                if a_ <= merged[-1][1] + 1e-6: merged[-1][1] = max(merged[-1][1], b_)
                else: merged.append([a_, b_])
            dx, dy = o["x2"] - o["x1"], o["y2"] - o["y1"]; L = math.hypot(dx, dy)
            if L < 1e-6 or tracks[ti].IsLocked(): continue
            ux, uy = dx / L, dy / L
            li = o["lay"]
            # obstacles near this track on its layer: (ax, ay, bx, by, required centre-line distance)
            obs = []
            rng = M["a_max"] + 1.0
            bx0, by0, bx1, by1 = min(o["x1"], o["x2"]) - rng, min(o["y1"], o["y2"]) - rng, max(o["x1"], o["x2"]) + rng, max(o["y1"], o["y2"]) + rng
            for q in items:
                if q["i"] == ti: continue
                same = q["net"] == net
                if q["kind"] == "via":
                    if not (bx0 <= q["x"] <= bx1 and by0 <= q["y"] <= by1): continue
                    obs.append((q["x"], q["y"], q["x"], q["y"], q["r"] + hw + (M["clr_same"] if same else max(M["clr"], 0.2))))
                else:
                    if q["lay"] != li: continue
                    if max(q["x1"], q["x2"]) < bx0 or min(q["x1"], q["x2"]) > bx1 or max(q["y1"], q["y2"]) < by0 or min(q["y1"], q["y2"]) > by1: continue
                    obs.append((q["x1"], q["y1"], q["x2"], q["y2"], q["hw"] + hw + (M["clr_same"] if same else M["clr"])))
            rects = []     # (x0, y0, x1, y1) grown by the required distance
            for p in pads:
                if p["lay"] not in ("*", li): continue
                g = hw + (0.3 if p["npth"] else max(M["clr"], 0.2))
                bb = p["bb"]
                if bb[2] + g < bx0 or bb[0] - g > bx1 or bb[3] + g < by0 or bb[1] - g > by1: continue
                rects.append((bb[0] - g, bb[1] - g, bb[2] + g, bb[3] + g))
            for k in kos:
                rects.append((k[0] - hw - 0.05, k[1] - hw - 0.05, k[2] + hw + 0.05, k[3] + hw + 0.05))
            OB = np.array(obs, float).reshape(-1, 5)
            def blocked(X, Y):
                bad = (X < 0.5) | (X > W - 0.5) | (Y < 0.5) | (Y > H - 0.5)
                for (rx0, ry0, rx1, ry1) in rects:
                    bad |= (X > rx0) & (X < rx1) & (Y > ry0) & (Y < ry1)
                if len(OB):
                    ax, ay, bx, by, rq = (OB[:, k][None, None, :] for k in range(5))
                    ddx, ddy = bx - ax, by - ay; L2 = ddx * ddx + ddy * ddy
                    tt = np.where(L2 > 0, np.clip(((X[..., None] - ax) * ddx + (Y[..., None] - ay) * ddy) / np.where(L2 > 0, L2, 1), 0, 1), 0)
                    dist = np.hypot(X[..., None] - (ax + tt * ddx), Y[..., None] - (ay + tt * ddy))
                    bad |= (dist < rq).any(axis=2)
                return bad
            step = 0.05
            dvals = np.arange(0.10, M["a_max"] + 1e-9, step)
            for (ta, tb) in merged:
                lo, hi = ta + M["margin"] + c_, tb - M["margin"] - c_ - s_
                if hi < lo: continue
                n = int((hi - lo) / (2 * s_)) + 1
                off = lo + ((hi - lo) - (n - 1) * 2 * s_) / 2          # centre the bump train on the interval
                best = None
                for side in (1, -1):
                    nx_, ny_ = -uy * side, ux * side
                    caps = []
                    for j in range(n):
                        t0 = off + j * 2 * s_
                        tv = np.arange(t0 - c_, t0 + s_ + c_ + 1e-9, step)
                        TT, DD = np.meshgrid(tv, dvals, indexing="ij")
                        X = o["x1"] + ux * TT + nx_ * DD; Y = o["y1"] + uy * TT + ny_ * DD
                        rowbad = blocked(X, Y).any(axis=0)
                        k = int(np.argmax(rowbad)) if rowbad.any() else len(dvals)
                        amax = dvals[k - 1] if k > 0 else 0.0
                        caps.append((float(amax), ti, side, t0))
                    tot = sum(max(0.0, 2 * a - K) for a, _, _, _ in caps if a >= M["a_min"])
                    if best is None or tot > best[0]: best = (tot, caps)
                slots += [c for c in best[1] if c[0] >= M["a_min"]]
        slots.sort(key=lambda c: (-c[0], c[1], c[3]))
        chosen = None
        for k in range(1, len(slots) + 1):
            sel = slots[:k]
            if sum(2 * a - K for a, _, _, _ in sel) + 1e-9 < need: continue
            lo_, hi_ = M["a_min"], sel[0][0]
            if sum(2 * min(a, lo_) - K for a, _, _, _ in sel) > need + 1e-9:
                continue                                    # even the smallest bumps would overshoot
            for _ in range(60):
                mid = (lo_ + hi_) / 2
                if sum(2 * min(a, mid) - K for a, _, _, _ in sel) < need: lo_ = mid
                else: hi_ = mid
            chosen = [(min(a, hi_), ti, side, t0) for a, ti, side, t0 in sel]
            break
        if chosen is None:
            cap = sum(2 * a - K for a, _, _, _ in slots)
            if not slots:
                print("tune: %s needs +%.2f mm but no meander fits - left as is" % (net, need)); continue
            print("tune: %s needs +%.2f mm, only %.2f mm of meander fits - partial compensation" % (net, need, cap))
            chosen = slots                                  # use everything that fits
        code = board.GetNetcodeFromNetname(net)
        per = {}
        for a, ti, side, t0 in chosen: per.setdefault(ti, []).append((t0, a, side))
        added = 0.0
        for ti, bumps in sorted(per.items()):
            o = byi[ti]; dx, dy = o["x2"] - o["x1"], o["y2"] - o["y1"]; L = math.hypot(dx, dy); ux, uy = dx / L, dy / L
            pl = [(0.0, 0.0)]
            for t0, a, side in sorted(bumps):
                d = a * side; cc = c_ * side
                pl += [(t0 - c_, 0.0), (t0, cc), (t0, d - cc), (t0 + c_, d), (t0 + s_ - c_, d), (t0 + s_, d - cc), (t0 + s_, cc), (t0 + s_ + c_, 0.0)]
                added += 2 * a - K
            pl.append((L, 0.0))
            xy = [(o["x1"] + ux * t - uy * d, o["y1"] + uy * t + ux * d) for t, d in pl]
            old = tracks[ti]; lay = old.GetLayer(); wdt = old.GetWidth()
            board.Remove(old); _KEEP.append(old); tracks[ti] = None
            for (xa, ya), (xb, yb) in zip(xy, xy[1:]):
                if math.hypot(xb - xa, yb - ya) < 1e-6: continue
                t = pcbnew.PCB_TRACK(board); t.SetStart(P(xa, ya)); t.SetEnd(P(xb, yb)); t.SetWidth(wdt); t.SetLayer(lay)
                t.SetNetCode(code); board.Add(t); tracks.append(t)
        changed = True
        print("tune: %-8s +%.2f mm in %d meander bump(s) (amplitude %.2f..%.2f mm) to match %s" % (
            net, added, len(chosen), min(c[0] for c in chosen), max(c[0] for c in chosen), row["nets"][1 if short == "p" else 0]))
    if changed:
        pcbnew.ZONE_FILLER(board).Fill(board.Zones()); board.BuildConnectivity()
        board.Save(board.GetFileName()); write_project(outdir)
    rep, _, _ = usb_report(board, sorted_tracks(board))
    for row in rep:
        print("tune: %-8s/%-8s path %.2f / %.2f mm, skew %.2f mm" % (row["nets"] + (row["p"]["path"], row["n"]["path"], row["skew"])))

# net classes for the autorouter (the same numbers are in voxhub.kicad_pro for KiCad's DRC)
NETCLASSES = {
    "Power": (400, 150, ["BUCK_SW", "USB1_VBUS", "USB2_VBUS", "SD_VDD", "SPK_P", "SPK_N"]),
    "HV": (250, 200, ["VBUS", "VBUS_SW", "PD_GATE", "PD_FET_EN"]),
    "P3V3": (250, 130, ["+3V3"]),
    "USB": (200, 130, ["USB_UP_P", "USB_UP_N", "USB1_P", "USB1_N", "USB2_P", "USB2_N"]),
}
DEFAULT_RULE = (150, 130)

def dsn_netclasses(s):
    import re
    s = s.replace("(rule\n      (width 200)\n      (clearance 200)\n      (clearance 50 (type smd_smd))",
                  "(rule\n      (width %d)\n      (clearance %d)\n      (clearance 50 (type smd_smd))" % DEFAULT_RULE)
    a = s.index("    (class kicad_default")
    b = s.index("  (wiring", a)
    block = s[a:b]
    special = {n for _, _, nets in NETCLASSES.values() for n in nets}
    head, tail = block.split("(circuit", 1)
    toks = re.findall(r'"[^"]*"|\S+', head)[2:]
    keep = [x for x in toks if x not in special]
    out = "    (class kicad_default " + " ".join(keep) + "\n      (circuit\n        (use_via \"Via[0-3]_500:300_um\")\n      )\n"
    out += "      (rule\n        (width %d)\n        (clearance %d)\n      )\n    )\n" % DEFAULT_RULE
    for name, (w, c, nets) in NETCLASSES.items():
        out += "    (class %s %s\n      (circuit\n        (use_via \"Via[0-3]_%s_um\")\n      )\n" % (
            name, " ".join(nets), "600:300" if name == "Power" else "500:300")
        out += "      (rule\n        (width %d)\n        (clearance %d)\n      )\n    )\n" % (w, c)
    return s[:a] + out + "  )\n" + s[b:]

if __name__ == "__main__":
    if sys.argv[1] == "place":
        place(sys.argv[2], sys.argv[3])
        tune_usb(sys.argv[3])
        lock_usb(sys.argv[3])
    elif sys.argv[1] == "dsn":
        b = pcbnew.LoadBoard(os.path.join(sys.argv[2], "voxhub.kicad_pcb"))
        os.makedirs(os.path.join(sys.argv[2], "gen", "work"), exist_ok=True)
        if "--planes" in sys.argv:
            poly_zone(b, rect(0, 0, W, H), (pcbnew.In1_Cu,), "GND", name="GND_PLANE")
            poly_zone(b, rect(0, 0, W, H), (pcbnew.In2_Cu,), "+5V", name="5V_PLANE")
        dsn = os.path.join(sys.argv[2], "gen", "work", "voxhub.dsn")
        print("DSN export:", pcbnew.ExportSpecctraDSN(b, dsn))
        s = open(dsn).read()
        s = dsn_netclasses(s)
        for lay in ("In1.Cu", "In2.Cu"):       # planes: keep the router off these layers
            s = s.replace("(layer %s\n      (type signal)" % lay, "(layer %s\n      (type power)" % lay)
        open(dsn, "w").write(s)
    elif sys.argv[1] == "repair":
        repair(sys.argv[2], sys.argv[3])
    elif sys.argv[1] == "patch":
        rr = ()
        if "--reroute-usb" in sys.argv:
            u = list(NETCLASSES["USB"][2])          # UP_P, UP_N, 1_P, 1_N, 2_P, 2_N
            variant = int(sys.argv[sys.argv.index("--variant") + 1]) if "--variant" in sys.argv else 0
            orders = [u, [u[1], u[0], u[3], u[2], u[5], u[4]], u[2:] + u[:2], list(reversed(u)), [u[4], u[5], u[2], u[3], u[0], u[1]], [u[3], u[2], u[5], u[4], u[1], u[0]]]
            rr = tuple(orders[variant % len(orders)])
        patch(sys.argv[2], reroute=rr)
    elif sys.argv[1] == "tune":
        tune_usb(sys.argv[2])
    elif sys.argv[1] == "stats":
        b = pcbnew.LoadBoard(os.path.join(sys.argv[2], "voxhub.kicad_pcb"))
        L, V = {}, {}
        ntr = nvia = 0
        for tr in b.GetTracks():
            n_ = tr.GetNetname()
            if tr.Type() == pcbnew.PCB_VIA_T: V[n_] = V.get(n_, 0) + 1; nvia += 1
            else: L[n_] = L.get(n_, 0.0) + pcbnew.ToMM(tr.GetLength()); ntr += 1
        print("track segments: %d, vias: %d (GND %d, +5V %d)" % (ntr, nvia, V.get("GND", 0), V.get("+5V", 0)))
        print("USB 2.0 pairs - electrical length pad to pad (hub pin to connector pin, %.1f mm counted per via):" % VIA_LEN)
        rep, _, _ = usb_report(b)
        for row in rep:
            print("%-9s %6.2f mm (%d vias)   %-9s %6.2f mm (%d vias)   skew %.2f mm   (vias counted as 0: %.2f mm)" % (
                row["nets"][0], row["p"]["path"], row["p"]["vias"], row["nets"][1], row["n"]["path"], row["n"]["vias"], row["skew"], row["skew0"]))
        print("USB 2.0 lines - pads on the path, and copper of the net that is not on that path (stubs, loops; 0 = pure flow-through):")
        for row in rep:
            for k in "pn":
                print("%-9s %-34s on-path %6.2f mm   off-path %.2f mm" % (
                    row["nets"]["pn".index(k)], " > ".join(row[k]["through"]), row[k]["onpath"], row[k]["offpath"]))
        print("worst pair: skew %.2f mm, %.2f mm with vias counted as 0 (limit %.1f mm); off-path copper %.2f mm" % (
            max(r_["skew"] for r_ in rep), max(r_["skew0"] for r_ in rep), USB_SKEW_LIMIT, max(r_["offpath"] for r_ in rep)))
        usb_bad = any(r_["skew"] != r_["skew"] or max(r_["skew"], r_["skew0"]) > USB_SKEW_LIMIT for r_ in rep)
        for n_ in ("SD_CLK", "SD_CMD", "SD_DAT0", "SD_DAT1", "SD_DAT2", "SD_DAT3", "I2S_BCLK", "PDM_CLK_M"):
            print("%-9s %6.1f mm (%d vias)" % (n_, L.get(n_, 0), V.get(n_, 0)))
        if usb_bad:
            print("USB pair not traceable pad to pad or above the skew limit", file=sys.stderr); sys.exit(3)
    else:
        finish(sys.argv[2])
