geilevideossos-gamedev/fable-sbc-test/(commit log)

2026-11-10 Add schematic generator, KiCad schematic (ERC clean) and voice assistant add-on
    Claude-Session: https://claude.ai/code/session_01Gk7egLqB3G31LZbQQLvfeS
    [audio.kicad_sch, cm4.kicad_sch, power.kicad_sch, usb.kicad_sch, voxhub.kicad_sch, zigbee.kicad_sch]
2026-11-10 Route PCB (DRC clean), add fabrication outputs, enclosure, OS image tooling and docs
    - hardware: scripted placement, power fan-out, Freerouting session, patch router,
    copper pours; ERC 0 / DRC 0 violations, 0 unconnected; Gerbers, drill, pos, BOM,
    PDFs, DXF, STEP, renders
    - enclosure: parametric CadQuery model, STL/3MF/STEP, renders, 0 mm^3 interference
    - os: HAOS board definition, overlay, build-image.sh (repack verified, full build documented)
    - docs: README, DECISIONS, TODO
    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
    [ADAU7002.step, MGM240P.step, RaspberryPi_CM4_with_heatsink.step, bom.csv, bom_system.csv, cm4.kicad_sch, config-voxhub.txt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]
2026-11-10 Final PCB: hub rotated, USB nets re-routed and matched, deterministic build, docs
    - hardware: deterministic post-route flow (patch router, DRC-driven repair, USB variants),
    mechanical DXF layer + positions CSV, silkscreen, 3D models wired up, fab/assembly README
    - sourcing: replace obsolete parts found during verification
    - enclosure regenerated for the final placement
    - README / DECISIONS / TODO updated with final results
    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
    [bom.csv, mechanical_positions.csv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]
2026-11-11 Revision A1: verify against datasheets, match USB pairs, live sourcing, enclosure update
    Hardware
    - CM4 antenna keep-out moved to the position of CM4 datasheet fig. 4 (it was in the wrong half of the edge)
    - LMR33640: feedback 24.9k (5.02 V), 220 nF / 50 V X7R input bypass, X7R input capacitors (datasheet table)
    - 1 uF capacitors 0603 X7R, second 100 nF on CYPD3177 VDDD
    - USB2514B RESET_N driven by the CM4 (nEXTRST) instead of an RC reset
    - MGM240P: RTS / CTS as in the reference diagram, RESETn driven open drain through a 2N7002
    - USB 2.0 pairs: flow-through ESD links, pad-to-pad length measurement and serpentine matching;
    skew 0.00 / 1.35 / 0.00 mm (limit 3.8 mm), ERC and DRC at zero
    - ne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
    [ADAU7002.step, MGM240P.step, RaspberryPi_CM4_with_heatsink.step, audio.kicad_sch, bom.csv, bom_system.csv, cm4.kicad_sch, config-voxhub.txt]
2026-11-11 media: showcase animation (MP4 1080p60, 21 s) and still of the exploded view
    Rendered headless with Blender 4.5.16 / Cycles from the STEP files of the
    repository (1260 frames, 3 h 10 min on 4 cores). Encoded as H.264 with the
    BT.709 matrix and colour tags.
    Build script fixes from the review: tool check before the render, Blender
    exit code is honoured, frames are validated before encoding, a truncated
    frame is re-rendered on resume, Blender 5 is refused (pre-5.0 animation API).
    Claude-Session: https://claude.ai/code/session_01Gk7egK7YUtuF2atdshaLyA
2026-11-11 Review round: USB pairs really matched now, buck bypass at the regulator, fixes from an independent review
    An independent review of the revision A1 deliverables (five reviewers, each
    finding attacked by a second agent; 47 of 51 findings confirmed) showed that
    USB port 2 was not matched: the length measurement only joined copper at
    track end points and followed a 4.9 mm loop where a track crossed its own
    net. Real skew 4.9 mm (limit 3.8 mm), reported as 0.00 mm.
    - USB ESD parts turned into a flow-through orientation (one pad row to the
    hub, one to the connector) and swapped left / right to match the hub pins
    - router rules for the USB data nets: pad to pad from scratch, hub side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
    [bom.csv, bom_system.csv, config-voxhub.txt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]
2026-11-11 os: attempts 7 and 8 documented; host builds redirect the /build signing-key paths
    Attempt 7 built all 218 packages and stopped in target-finalize (a python3
    build directory emptied by the session's disk helper). Attempt 8 stopped in
    post-build.sh: HAOS expects the RAUC signing key under /build, the mount point
    inside its builder container. Attempt 9 is running.
    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
2026-11-11 os: the full from-source build ran to the end (attempt 9); image inspected and documented
    os/build-image.sh full (host build, HAOS 18.5, 218 packages) produced
    haos_voxhub-cm4-18.5-full.img.xz (317 MiB) and the OTA bundle. Checked: GPT
    with the 8 HAOS partitions, config.txt with the VoxHub block, voxhub.dtbo from
    the voxhub-overlay package applies to the image's CM4 device tree, kernel
    6.18.59 with the audio / GPIO / I2C drivers, RAUC compatible haos-rpi4-64,
    data partition with the Supervisor containers.
    Last fix needed: on host builds the HAOS scripts look for the RAUC signing
    key under /build (builder container mount); build-image.sh redirects that to
    the cloned tree. The full mode now a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
2026-11-11 Second review round: buck power stage placed by hand, script and wording fixes
    A second, independent round checked the fixes of the first one: all 48
    confirmed findings fixed, the USB result re-computed with a third parser
    (0.000 mm on all pairs, no vias, wiring correct), 17 new findings confirmed.
    - The one that mattered: after C10 had been moved to the regulator, the
    switch-node track ran between the bulk capacitor C8 and U2 and left C8 on a
    20 mm long 0.4 mm track. The power stage is now placed by hand: U2 turned so
    that VIN / PGND face the PD stage and SW / BOOT / VCC the inductor; C10, C8
    and C9 share one pour with the VIN pin; C12 and C11 1.8 mm from their pins;
    ind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
    [voxhub-B_Cu.gbr, voxhub-B_Mask.gbr, voxhub-B_Paste.gbr, voxhub-B_Silkscreen.gbr, voxhub-Edge_Cuts.gbr, voxhub-F_Cu.gbr, voxhub-F_Mask.gbr, voxhub-F_Paste.gbr]
2026-11-11 Third review round: wording and script fixes, remaining layout items documented
    A focused third round on the power-stage change found no defect on the board
    (split pour gone, USB confirmed with a fourth parser, outputs consistent) and
    twelve low findings.
    - hardware/README.md: the reasons in the waived-checks table now describe the
    warnings that are actually reported; via-in-pad note names the two fan-out
    vias inside QFN lead pads; the buck paragraph says what is still automatic
    (ground side through one shared via, VBUS necks) and lists what to change
    before a production spin
    - DECISIONS.md: review counts and the provenance of the independent USB
    figures corrected; log row 30 expl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
    [build_pcb.py]
2026-11-11 media: showcase video re-rendered from the final board
    The 866 frames that show the PCB (150-1015) are rendered again from the
    board after the review fixes; the 394 closed-device frames are kept
    (printed parts unchanged, five of them re-rendered for comparison match
    to within 3/255). Probed: H.264 High, 1920x1080, 60 fps, 1260 frames,
    21 s, BT.709. Stale-status notes in media/README.md, TODO.md and
    DECISIONS.md replaced, decision log row 31 added.
    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
2026-11-12 Hardware revision A2: parts in stock at JLCPCB, layout fixes, JLCPCB package
    Parts
    - every BOM line looked up live in the JLCPCB assembly library and at LCSC
    (hardware/gen/sourcing_jlc.json, jlc_lookup.py); DigiKey stays the second source
    - radio module MGM240P (no stock) replaced by RF-star RF-BM-2652P2 (CC2652P)
    - status LEDs are ordinary 0603 parts on the top-facing side instead of
    reverse-mount LEDs; crystal, inductor, polymer capacitors, Zener and passives
    moved to parts JLCPCB stocks
    Layout
    - power stage and USB lines are hand-designed, locked copper (gen/prewire.py):
    PGND tied to the exposed pad with its own vias, VBUS / VBUS_SW feed 1.2 to
    1.6 mm wide, no via inside or tou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
    [ADAU7002.step, RF-BM-2652P2.step, RaspberryPi_CM4_with_heatsink.step, audio.kicad_sch, bom.csv, bom_jlcpcb.csv, bom_system.csv, cm4.kicad_sch]
2026-11-12 Documentation for revision A2: decision log, READMEs, checklist
    - DECISIONS.md: A2 decision log (35 entries), exceptions to the sourcing
    rules, data sheet re-download table, radio / sourcing / open-items sections
    - README.md: status, order / shopping / assembly entry points, GPIO map and
    power budget for the CC2652P radio, cost summary from JLCPCB prices
    - hardware/README.md rewritten for the A2 build flow, rules and outputs
    - enclosure and OS READMEs follow the new speaker and radio
    - system BOM lists the EU shop, article number and price of every item
    Claude-Session: https://claude.ai/code/session_01Gk7egJhTt6YHBijPCLQGwy
2026-11-12 A2 after review round 1: layout, order package, enclosure and script fixes
    Six independent reviewers checked the changed areas (no high finding,
    10 medium, 30 low). Applied:
    Board
    - hub decoupling: three capacitors fixed at the supply pins with locked
    copper (links under the package for pins 5 and 23), crystal lines pre-wired
    - ground via out of pad C5.2; scripted ground stubs for the SMT spacers and
    the microphone rings; new gate gen/check_vias.py
    - VBUS / VBUS_SW test pads removed, remaining pads labelled; net class HV
    (0.20 mm clearance) for the nets that carry the charger voltage
    - second antenna keep-out under the copper-free pocket of the radio module
    - copper 0.45 mm from the b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
    [bom.csv, bom_jlcpcb.csv, bom_system.csv, cm4.kicad_sch, placement_report.csv, power.kicad_sch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]
2026-11-12 Round 2 leftovers: build path fix, 7 mm heat sink model, foam gap, guides updated
    - build.sh: the native path substitution no longer rewrites gen/work (stray netlist removed)
    - CM4 model with the 7 mm heat sink, enclosure pedestal for a 2 mm compressed pad
    - fab guides updated to the final board (53 BOM rows, rails on the 74 mm edges, test pads)
    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
    [ADAU7002.step, RF-BM-2652P2.step, RaspberryPi_CM4_with_heatsink.step, bom_system.csv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]
2026-11-12 DECISIONS: results of review round 2 (radio, enclosure, order package, script)
    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
2026-11-12 Guides: consistent peak power, heat sink clearance and lead routing wording
    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
2026-11-12 Final board state: GND test pad label above its pad, outputs and order files regenerated
    Copper and placement are unchanged against the previous commit (same autorouter
    session); schematic netlist is written to gen/work again.
    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
    [voxhub-B_Cu.gbl, voxhub-B_Mask.gbs, voxhub-B_Paste.gbp, voxhub-B_Silkscreen.gbo, voxhub-Edge_Cuts.gm1, voxhub-F_Cu.gtl, voxhub-F_Mask.gts, voxhub-F_Paste.gtp]
2026-11-12 Review round 2 closed: hub channels, corner keep-outs, neck-down at fine pads
    Findings of the power / USB re-check, all low, verified on the board first:
    - hub 3.3 V links under the package are hand-designed and locked; the two free
    channels between lead ring and exposed pad are keep-outs for the routers
    - pour keep-outs around the four rounded corners: copper 0.450 mm from the
    outline everywhere (was 0.20 mm at the corners)
    - routed track ends are necked to the pad width at fine pads (amplifier,
    WLCSP, CM4 socket)
    - check_vias.py: explicit exposed-pad table and real pad shapes
    - check_power.py header and the impedance corners (both dielectric
    constants) corrected; inner copper 15.2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
    [voxhub-B_Cu.gbl, voxhub-B_Mask.gbs, voxhub-B_Paste.gbp, voxhub-B_Silkscreen.gbo, voxhub-Edge_Cuts.gm1, voxhub-F_Cu.gtl, voxhub-F_Mask.gts, voxhub-F_Paste.gtp]
2026-11-12 Zigbee radio: --role hub|satellite with router firmware, radio simulator and tests; satellite bridge and exposure guard
    flash_zigbee.sh writes the Z-Stack coordinator on the hub and Koenkk's router 20250403 on
    the satellite, checks an installed router through the boot loader CRC, can make the router
    rejoin, refuses the router role on Home Assistant OS and can use local copies of the
    downloads. tools/test holds a CC26xx boot loader / ZNP / RCP simulator and 49 test checks.
    assistant/voxhub_satellite starts the hub-side satellite: LED and mute bridge for Linux
    Voice Assistant, launcher, hub watch and the exposure guard for locks and alarm panels.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
2026-11-12 Hub add-on VoxHub Satellite: LVA 1.1.18 satellite with LEDs, mute switch and exposure guard
    The add-on builds on the official Linux Voice Assistant image, finds the googlevoicehat
    source and sink, sets the microphone gain in dB, starts LVA and bridges its peripheral API
    to the status LEDs and the mute switch. The exposure guard keeps locks, alarm panels and
    the scenes, groups and scripts that control them away from Assist. Container test with a
    real ESPHome API client; router join instructions corrected (the router searches once).
    Claude-Session: https://claude.ai/code/session_01Gk7egHkjJiGBXQR6HpA5yH
2026-11-12 Shopping list: satellite variant and combined basket; guide chapter 7; satellite image builder
    fab/SHOPPING_LIST.md section 8: CM4101000 (1 GB) and a 32 GB card for the satellite, the
    combined basket hub + satellite in two parcels to Austria (286.90 EUR). ASSEMBLY_AND_TEST
    chapter 7: the hub's Claude pipeline, the satellite SD card, pairing, rooms, the Zigbee
    router and the tests from both rooms. os/satellite: image build script and root files
    (first build running). README files updated for the two-device system.
    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
2026-11-12 Satellite image checks fixed (symlinks, shadow regex, stubbed sound server for --help); test client takes the device name
    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
2026-11-12 Satellite image runtime test: PipeWire, launcher, LVA and the LED bridge run inside the image, driven by an ESPHome API client
    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
2026-11-12 Review fixes: router check over programmed ranges, absolute mic gain, hub LVA on loopback, guard walks script configs
    - flash_zigbee.sh: the router check compares only the ranges the image programs (code,
    CCFG), not the router's NV area; --rejoin refuses without router firmware; messages
    use the installed script name. Simulator writes NV on first boot, no stale button.
    - launch.py: the microphone gain is an absolute linear factor (+12.04dB was relative and
    grew at every start); the hub add-on binds Linux Voice Assistant to 127.0.0.1.
    - guard.py: reads every script's configuration (script calls, area/device targets,
    templates); scenes use entity references only; empty protected list k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
2026-11-12 Review fixes in the documentation; container test checks loopback and gain after restart
    Guide: add-on repository with branch, satellite microphone test plays MK1 and MK2, order of
    work for the satellite board, cross references, wake word and room only in Home Assistant,
    unattended-upgrade -v. README quick start commands fixed, privacy sentence. DECISIONS:
    review round S-33 to S-40, S-18 as its own table. TODO up to date.
    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
